yuuundj/Haetburi-practice/archive/code_before_variants/README.md

# 횃불이 이족보행 로봇 — URDF / MuJoCo 모델

횃불이 캐릭터 STL을 관절 단위로 잘라, **Dynamixel XL430-W250-T 7개**로 움직이는
이족 로봇 모델로 만든 것입니다. 현재 버전은 **모터 7개가 전부 캐릭터 껍데기 안에**
들어갑니다. 발목 모터는 발에 하나(피치), 다리에 하나(롤)를 나눠 넣었습니다.

preview

```
python3 sim/view.py            # 인터랙티브 뷰어 (Tab → Control 탭에서 관절 슬라이더)
python3 sim/demo.py            # 전 관절 가동 범위 시연
python3 sim/analyse.py         # 모터 간섭·토크·전도 한계·한 발 지지 리포트
python3 tools/build_model.py   # 파라미터를 고친 뒤 모델 재생성
python3 tools/ankle_search.py  # 발목 모터 배치 전수 탐색
```

필요한 것은 `mujoco`, `trimesh`, `shapely`, `manifold3d`, `mapbox_earcut`, `rtree`,
`numpy`, `pillow`입니다. WSL에서는 렌더링에 `MUJOCO_GL=glfw`가 필요합니다.

## 1. 관절 구성

| 관절 | 축 | 범위 | 모터 위치 | 부모 → 자식 |
|---|---|---|---|---|
| `waist_yaw` | z | ±60° | 가슴 속 | pelvis → torso |
| `hip_pitch_l/r` | y | ±45° | 배(골반) 속 | pelvis → leg |
| `ankle_roll_l/r` | x | ±12° | 다리 속 | leg → ankle |
| `ankle_pitch_l/r` | y | ±15° | 발 속 | ankle → foot |

무릎은 없고 다리는 고관절 한 축입니다. `ankle` 링크는 롤 모터 출력과 피치 모터 출력을
잇는 브래킷이고 모터가 없습니다. 머리·팔·꼬리·가방은 상체 강체 하나입니다.

## 2. 크기

| 항목 | 값 |
|---|---|
| 캐릭터 본체 (머리 끝 ~ 원래 발바닥) | 500 mm |
| 실제 전고 | 614 mm |
| 발 (길이 × 폭 × 높이) | 108 × 45 × 82 mm, 위에서 보면 타원(지수 2.5), 옆은 돔(지수 4) |
| 발이 다리보다 나온 길이 | 앞 68 mm, 뒤 41 mm |
| 다리 단면 (폭 × 앞뒤) | 37 × 46 mm, 모서리 지수 6 |
| 다리 길이 (가랑이 ~ 다리 밑) | 57 mm (원본 비율이면 약 19 mm) |
| 발목 틈 (발등 ~ 다리 밑) | 10 mm |
| 발목 피치 축 / 롤 축 높이 | 17 / 106 mm |
| 총 질량 / 무게중심 높이 | 2.82 kg / 244 mm |

## 3. 모양과 모터 배치를 정한 과정

500 mm 스케일에서 골반은 49 mm 높이라 고관절 모터(46.5 mm)로 꽉 차고, 가랑이 아래는
원래 35 mm뿐입니다. XL430은 28.5 × 46.5 × 34 mm이고, 출력축은 34 mm 방향으로 지나며
46.5 mm 변의 한쪽 끝에서 11.25 mm 지점에 있습니다(ROBOTIS 도면).

1. **발목 모터 2개를 모두 발에 넣는 안**은 전수 탐색 결과 가장 작은 발도
   89 × 43 × 142 mm였습니다(`tools/ankle_search.py`). 발 폭이 두 다리 간격 때문에
   약 44 mm로 묶여 있어 두 모터를 세로로 쌓아야 하기 때문입니다.
2. 그래서 **발목 모터를 나눠** 넣었습니다. 다리에는 좌우 폭이 28.5 mm인 롤 모터를
   세워 넣고, 발에는 피치 모터를 긴 쪽이 발끝을 향하게 눕혀 넣습니다.
3. **다리**는 모서리 지수 6의 둥근 사각 기둥(37 × 46 mm)입니다. 원본처럼 둥근 단면은
   직사각형 모터를 품으려면 46 mm 폭까지 굵어져야 해서 두 다리가 거의 붙습니다.
4. **몸통 아랫부분**은 배 둘레와 두 다리 윗면을 볼록 껍질로 이은 반바지 모양입니다.
   원래의 둥근 다리 윗부분을 지우고 다시 만들었기 때문에, 사각 다리가 턱 없이 몸통으로
   이어집니다. 그 높이에 붙어 있던 꼬리 뿌리는 따로 잘라 다시 붙였습니다.
5. **배터리·U2D2 300 g은 배 앞쪽**, 고관절 모터 앞에 둡니다. 가방에 넣으면 무게중심이
   다리보다 11 mm 뒤에 와서 발을 뒤로 빼야만 섰습니다. 지금은 무게중심이 다리 바로
   위에 있어 발을 앞으로 길게 뺄 수 있습니다.
6. **발**은 위에서 보면 타원, 옆에서 보면 돔인 번입니다. 발바닥은 가장 넓은 둘레에서
   잘랐습니다. 그보다 아래에서 자르면 옆면이 발바닥보다 불룩해서, 발목을 꺾을 때 발이
   흔들의자처럼 굴렀습니다.
7. 다리 속 모터는 고관절 ±45°에서도 고관절 모터에 닿지 않게 고관절 축 20 mm 아래에서
   끝납니다. 이것과 모터 높이가 다리 길이 57 mm를 정합니다. 발목 틈 10 mm는 발목을
   끝까지 꺾어도 다리 밑면이 발에 닿지 않는 최소값입니다.

## 4. 부하 계산

`sim/analyse.py` 결과이고, XL430 스톨 토크 1.4 N·m 대비 비율입니다.

| 상황 | 결과 |
|---|---|
| 모터 7개가 껍데기 안에 든 비율 | 전부 100 % |
| 모터끼리 최소 간격 | 2.2 mm |
| 중립 직립, 발목 피치 / 고관절 | 3 % / 3 % |
| 두 발로 앞뒤 7° 기울이기 | 35 % |
| 앞뒤 전도 | 시뮬레이션 8°, 정적 계산 10.3° (뒤꿈치 쪽) |
| 좌우 | 발목 롤 한계 12°까지 넘어지지 않음 |
| 넘어지기 직전 자세를 한 발로 버티기 | 80 % |
| 전 관절 데모(23.5초, 앞뒤 기울임 5°) | 최대 43 %, 넘어지지 않음 |

**한 발로 서기는 이 버전에서 되지 않습니다.** 고관절 롤이 없어서 두 발이 닿아 있는 동안
몸을 옆으로 옮길 방법이 없습니다. 발목 롤을 꺾으면 두 가지 결과가 가능합니다. 하나는
몸 전체가 한쪽 발로 기울며 반대 발이 뜨는 것이고, 다른 하나는 몸은 그대로 있고 두 발이
모서리로 서는 것입니다. 롤 축이 바닥에서 106 mm로 높은 이 버전에서는 뒤쪽이 일어납니다.
딛는 발부터 꺾거나 시간차를 줘도 같았습니다. 롤 축이 낮았던 이전 버전들에서는 발이
떴습니다. 걷게 하려면 고관절 롤을 추가하거나, 롤 모터를 발로 내려 축을 낮추거나,
동적으로 흔드는 보행 제어가 필요합니다.

지금까지 만든 버전을 비교하면 이렇습니다.

| | 모터 노출 | 발목 2개 발에 | 나눠 넣기 (1차) | **나눠 넣기 (현재)** |
|---|---|---|---|---|
| 모터 내장 | 고관절·허리만 | 전부 | 전부 | 전부 |
| 전고 | 500 mm (본체 407) | 608 mm | 584 mm | 614 mm |
| 발 | 110 × 66 판 | 103 × 43 × 120 | 62 × 45 × 49 | 108 × 45 × 82 |
| 발 방향 | - | 가운데 | 뒤로 치우침 | 앞으로 김 |
| 가랑이 아래 다리 | 28 + 모터 93 | 19 | 57 | 57 |
| 앞뒤 전도 | 19° | 9° | 6° | 8° |
| 한 발 지지 | 됨 | 됨 | 됨 | **안 됨** |
| 데모 최대 부하 | 28 % | 50 % | 44 % | 43 % |

## 5. 파일

```
tools/haetburi_params.py   치수·질량·관절 범위·발목 배치 선택 (여기만 고치면 됨)
tools/ankle_search.py      발목 모터 2개를 발에 넣는 배치 탐색, 둥근 발 맞춤(fit_bun)
tools/layout.py            발·다리 단면 크기, 다리 길이, 발목 틈, 모터 위치
tools/segment.py           원본 STL 절단, 둥근 사각 다리, 반바지 모양 몸통 아랫부분
tools/massprops.py         껍데기 적분 기반 질량·관성
tools/build_model.py       URDF 생성, 메시 내보내기, 모터 내장 비율 검사
tools/write_mjcf.py        MuJoCo 씬 생성
tools/render_preview.py    robot/preview.png (투시 화면 포함)
tools/make_feet.py         검토용 도라에몽 발 시안 (modelings/haetburi_feet_v1.stl)

robot/haetburi.urdf        URDF (ROS·PyBullet에서도 로드 가능)
robot/haetburi_scene.xml   MuJoCo 씬
robot/meshes/*.stl         링크별 메시 (미터, 로봇 좌표계)
review/                    발 시안 검토 이미지
```

`robot/` 아래는 전부 생성물입니다. 손으로 고치지 말고 파라미터를 고친 뒤 다시 빌드하세요.

## 6. 좌표계와 단위

- **+x 정면, +y 로봇 왼쪽, +z 위**, 발바닥이 z = 0
- 원본 STL은 −y가 얼굴 방향이라 z축 기준 +90° 회전해 내보냅니다
- 메시·URDF·MJCF는 미터, 파라미터 파일은 mm

## 7. 모델링 상의 단순화

- 모터는 실제 치수와 축 위치를 쓰지만 외형은 박스입니다. 혼 2.5 mm는 간섭 계산에만
  넣었습니다.
- 롤 모터와 피치 모터를 잇는 발목 브래킷은 50 g 박스로만 넣었고 형상은 없습니다.
- 반사 관성 `armature = 0.0067 kg·m²`, 마찰 `0.04 N·m`는 추정값입니다.
- 액추에이터는 `kp 30, kv 1.2, ±1.4 N·m` 위치 서보입니다. 실제 PID·전류 제한은
  반영하지 않았습니다.
- 발 충돌은 발 메시의 볼록 껍질, 나머지는 박스와 구입니다. 다리와 자기 발은 서로
  충돌하지 않게 제외했습니다.
- 배터리·U2D2 300 g은 배 앞쪽의 점 질량으로 넣었습니다.

## 8. 참고

- [ROBOTIS XL430-W250-T e-Manual](https://emanual.robotis.com/docs/en/dxl/x/xl430-w250/)
- [ROBOTIS XM430 데이터시트 도면](https://media.distrelec.com/Web/Downloads/_t/ds/Dynamixel_XM-Series_eng_tds.pdf)
  (XL430과 케이스 치수 동일, 축 위치 11.25 mm의 근거)
- `images-modeling/PartsAssembly.png` (6파트 분할, 몸통 상하 분할)
