yuuundj/Haetburi-practice/images-modeling/Haetburi.png

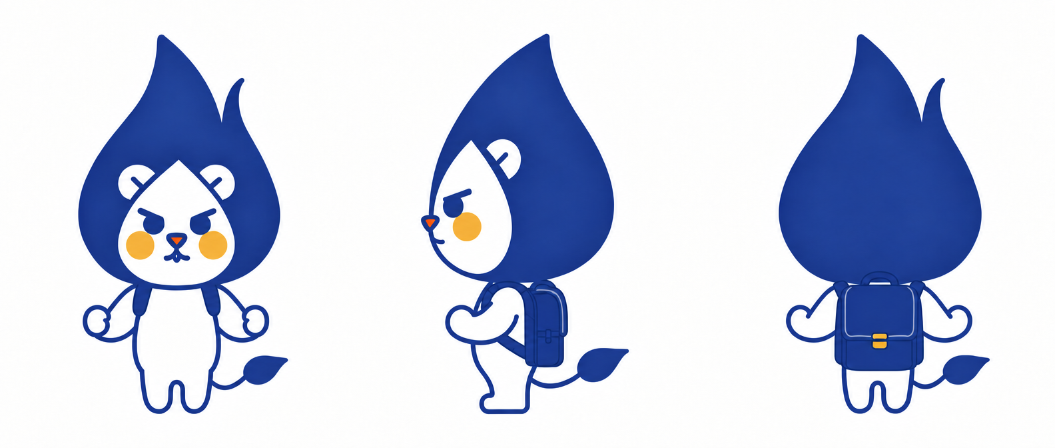
images-modeling/Haetburi.png
