yuuundj/Haetburi-practice/images-modeling/Haetburi_display.png

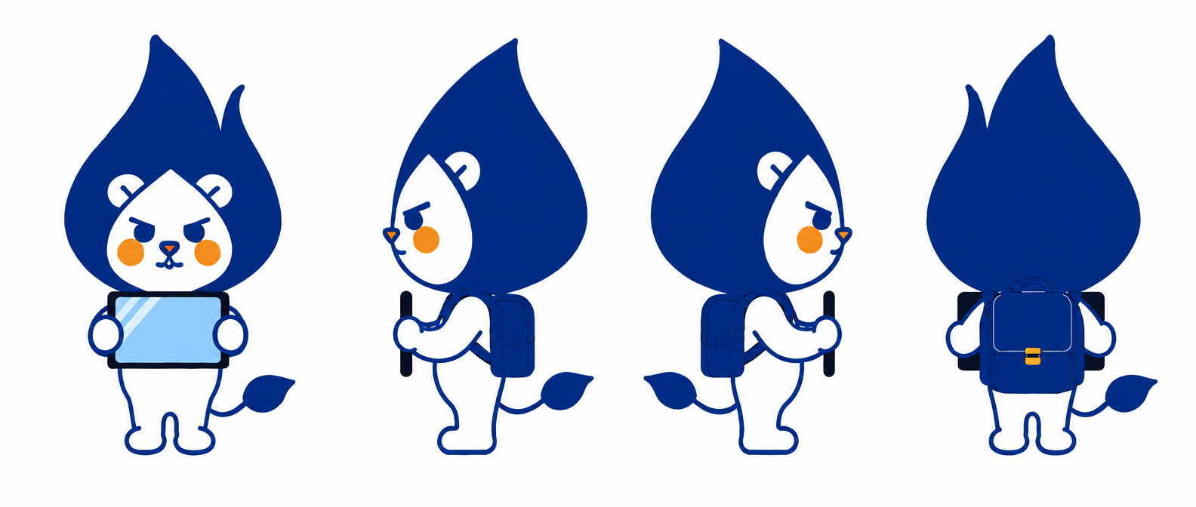
images-modeling/Haetburi_display.png
