yuuundj/Haetburi-practice/review/display_model_v2.png

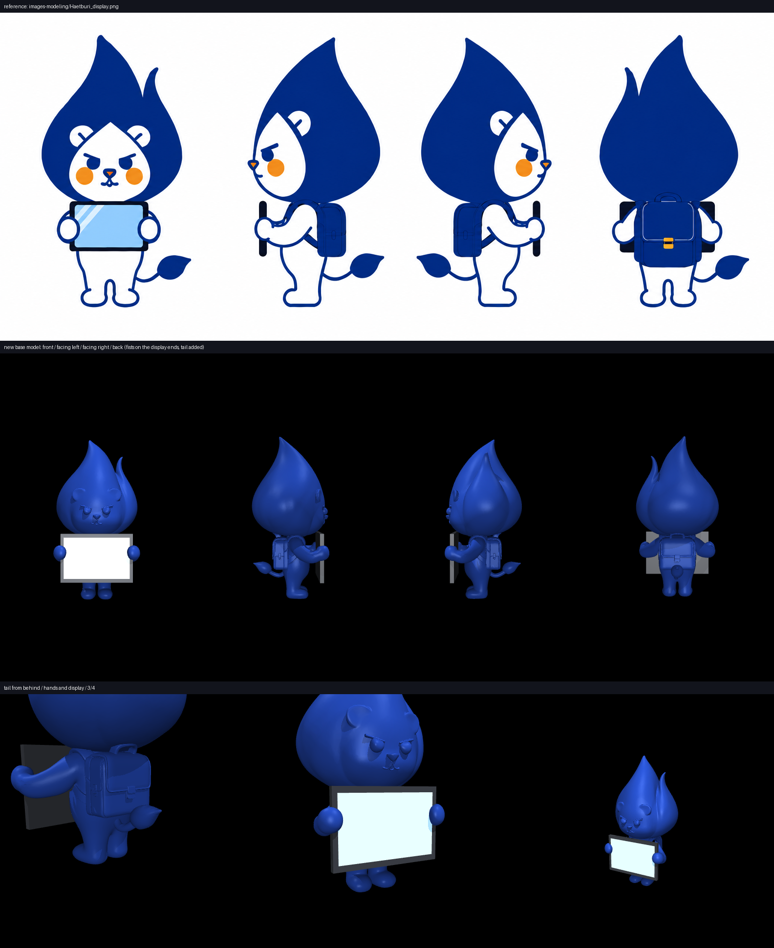
review/display_model_v2.png
