yuuundj/Haetburi-practice/review/feet_v1.png

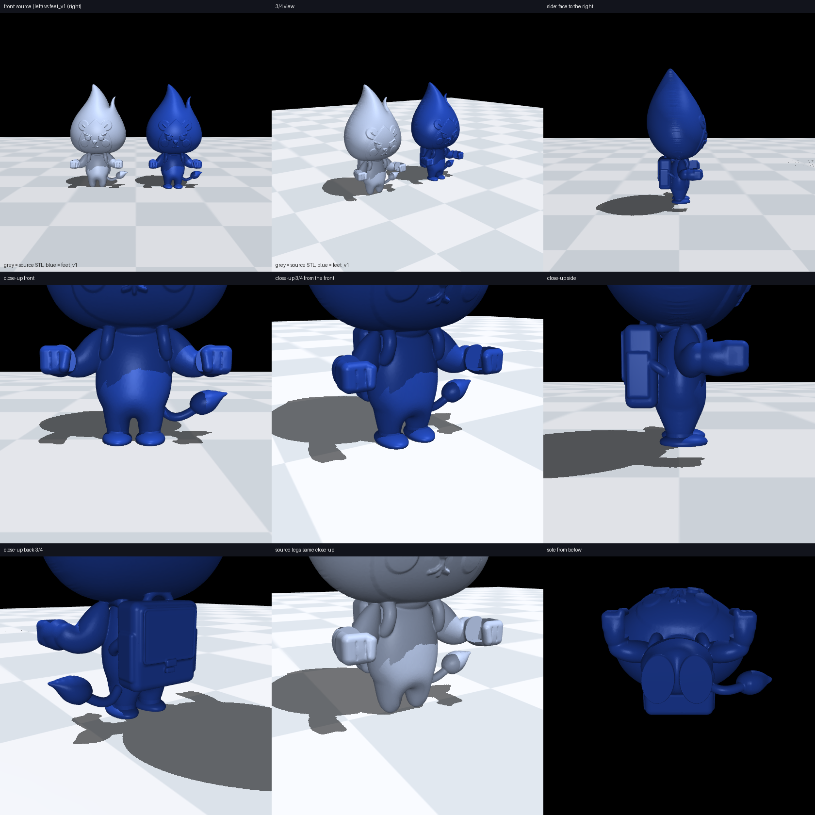
review/feet_v1.png
