yuuundj/Haetburi-practice/review/feet_v1_plan.png

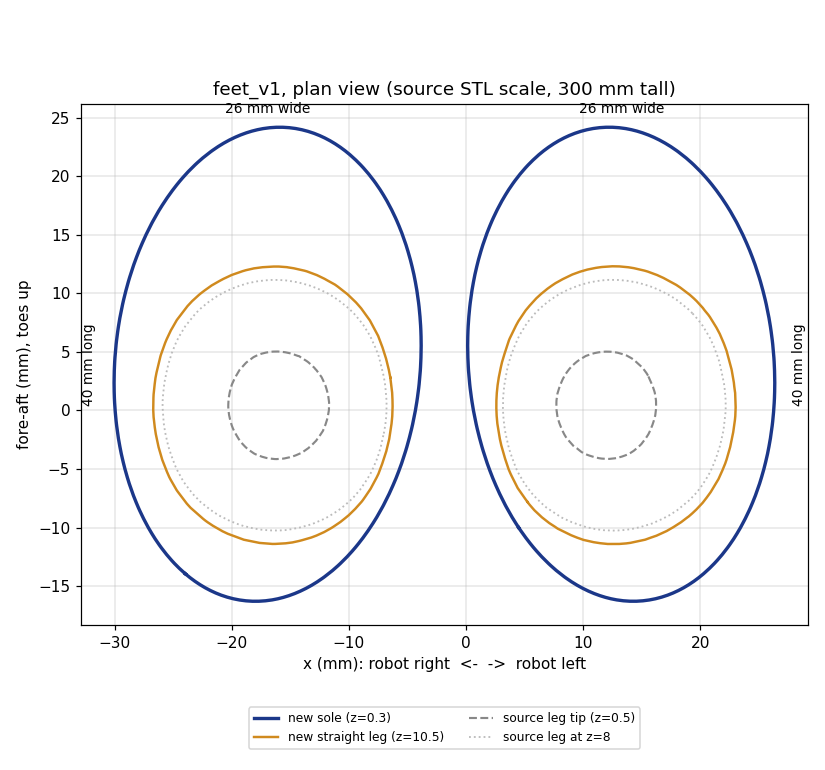
review/feet_v1_plan.png
