yuuundj/Haetburi-practice/robot/v9_yaw_roll_display/reference_compare.png

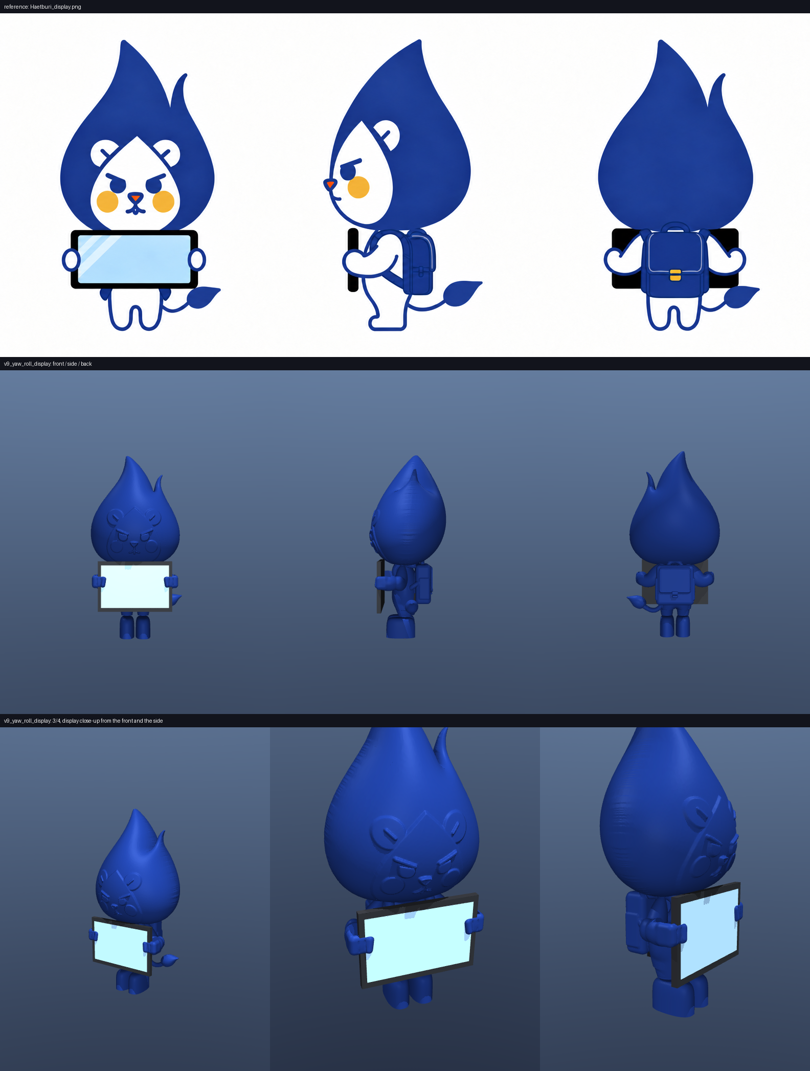
robot/v9_yaw_roll_display/reference_compare.png
