yuuundj/Haetburi-practice/robot/v10_split_display/reference_compare.png

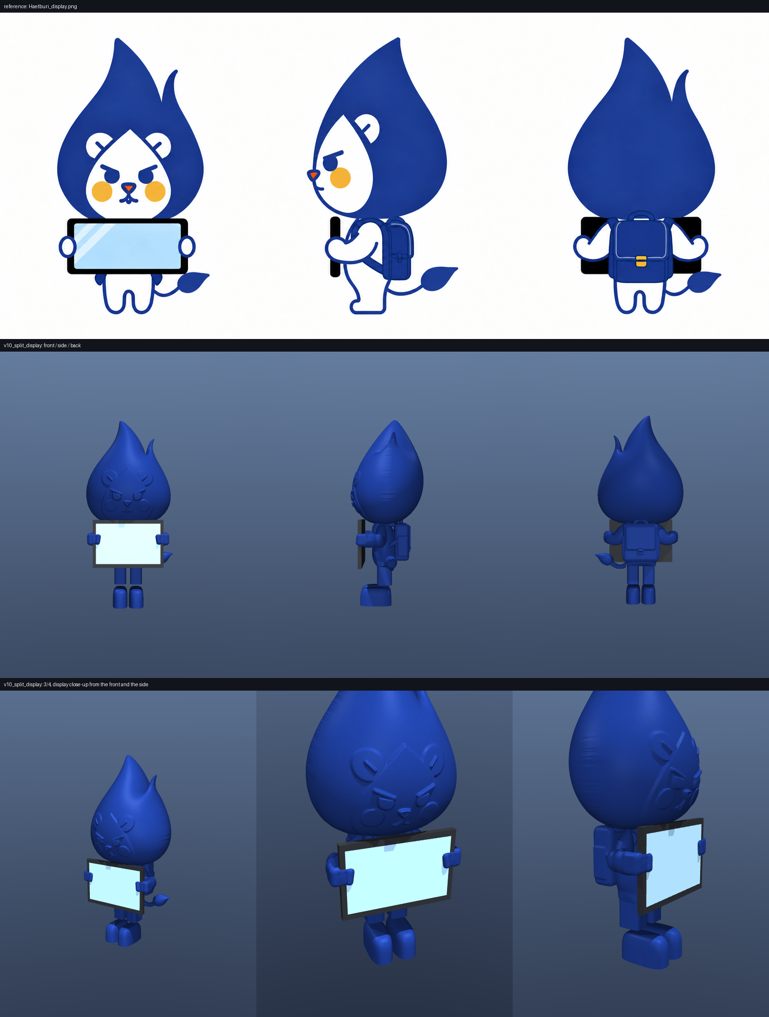
robot/v10_split_display/reference_compare.png
