yuuundj/Haetburi-practice/robot/v11_newbase_display/preview.png

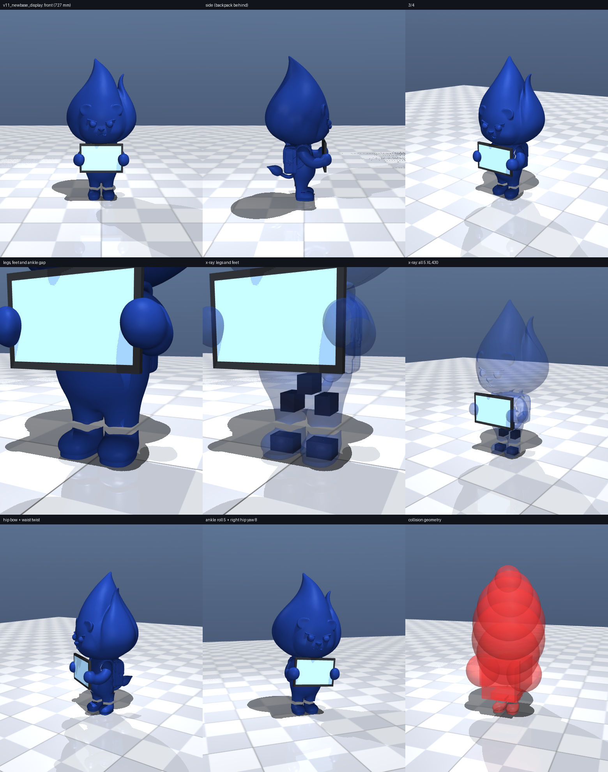
robot/v11_newbase_display/preview.png
