yuuundj/Haetburi-practice/robot/v11_newbase_display/walk_strip.png

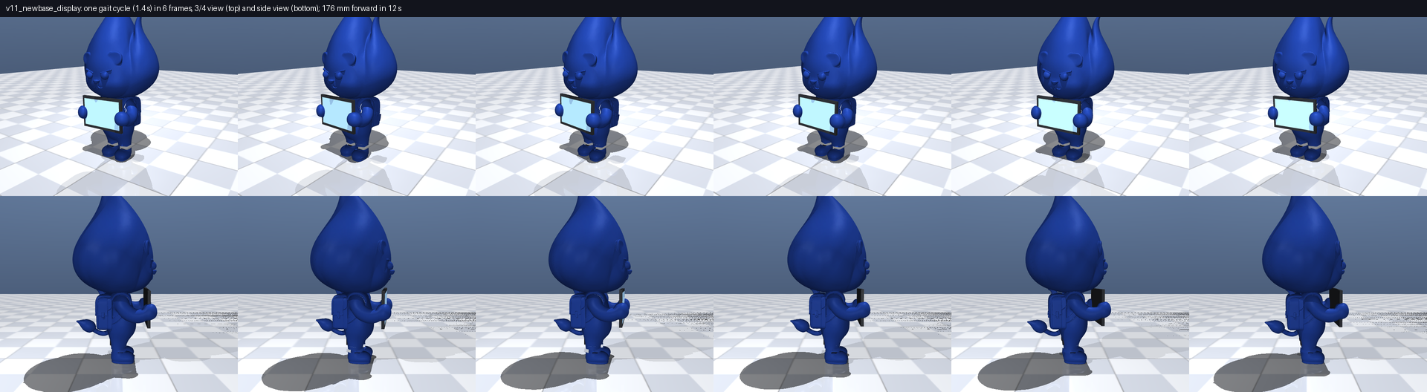
robot/v11_newbase_display/walk_strip.png
