yuuundj/Haetburi-practice/robot/v12_slipper_display/feet_closeup.png

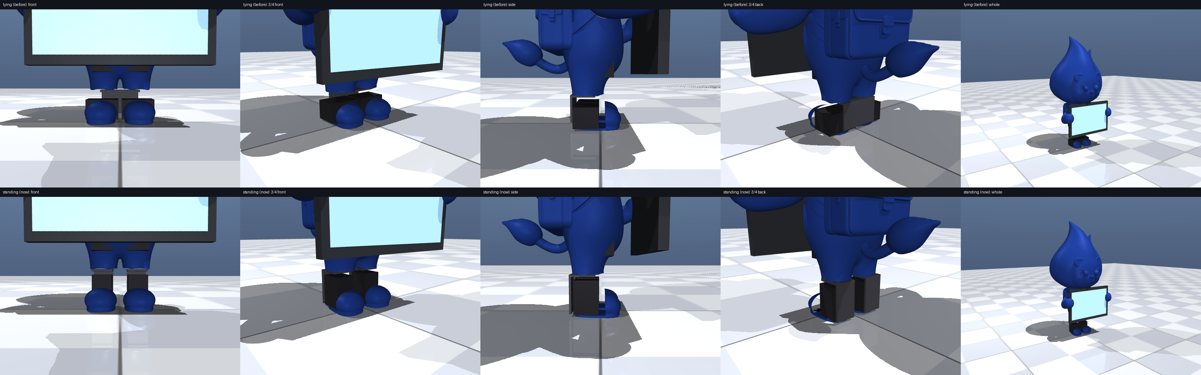
robot/v12_slipper_display/feet_closeup.png
