yuuundj/Haetburi-practice/robot/v12_slipper_display/preview.png

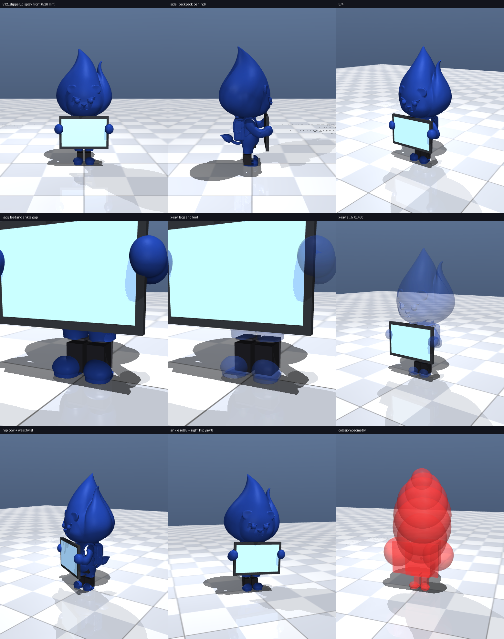
robot/v12_slipper_display/preview.png
