yuuundj/Haetburi-practice/robot/v12_slipper_display/walk_strip.png

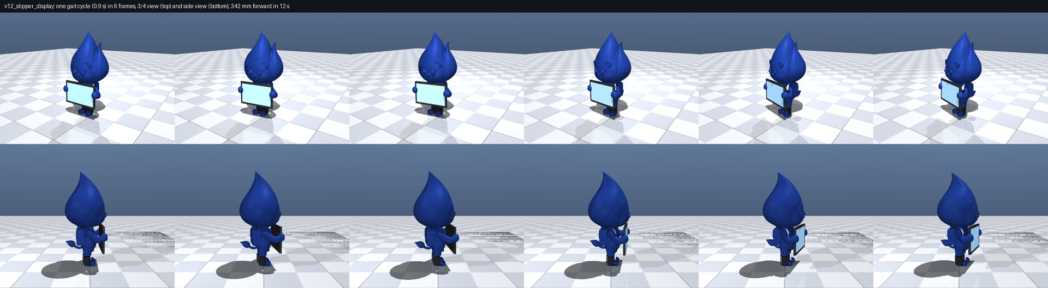
robot/v12_slipper_display/walk_strip.png
