yuuundj/Haetburi-practice/robot/v13_ankle_pitch_display/legs_closeup.png

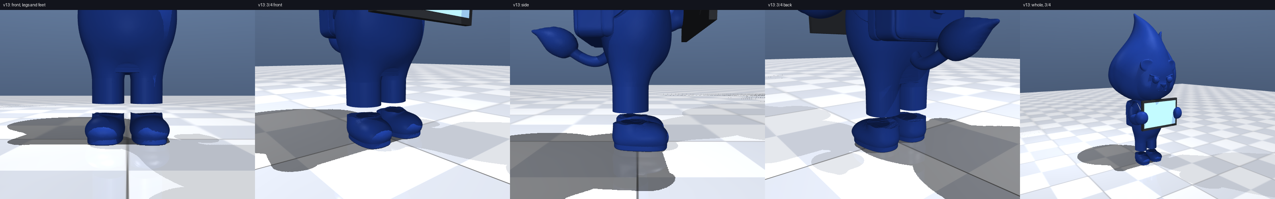
robot/v13_ankle_pitch_display/legs_closeup.png
