yuuundj/Haetburi-practice/robot/v13_ankle_pitch_display/preview.png

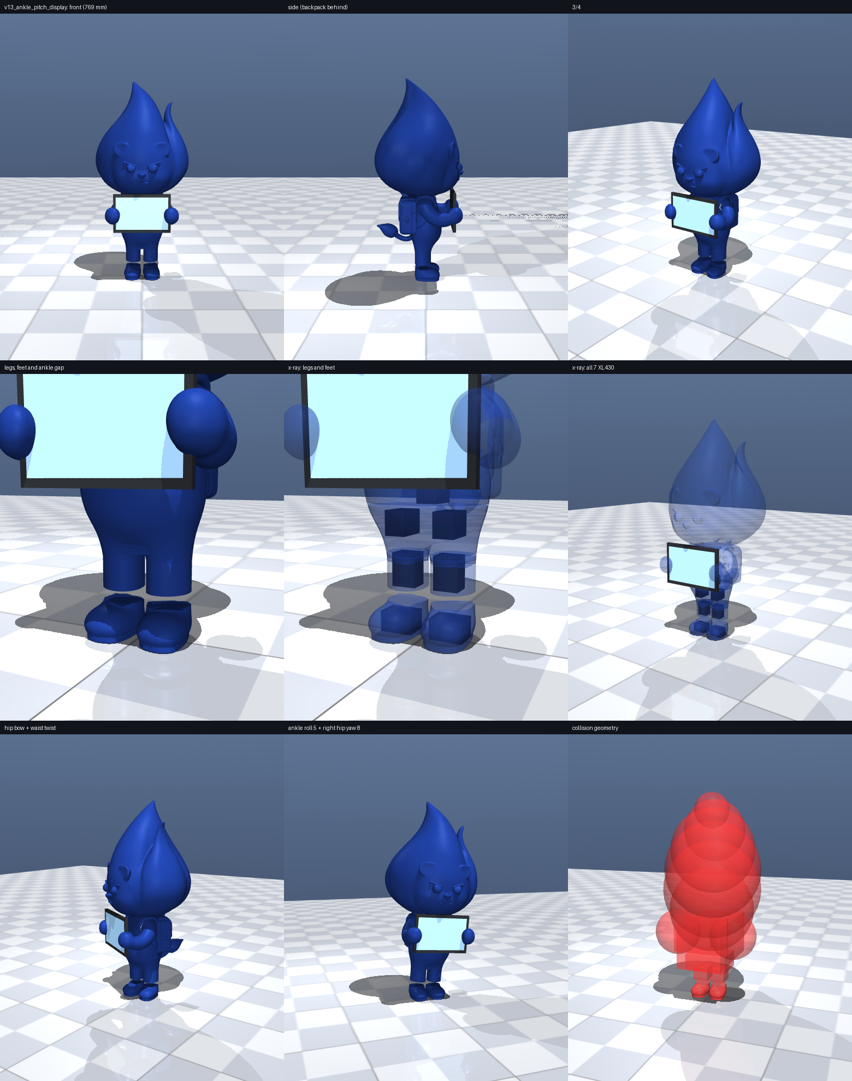
robot/v13_ankle_pitch_display/preview.png
