yuuundj/Haetburi-practice/robot/v14_scs0009_hidden/preview.png

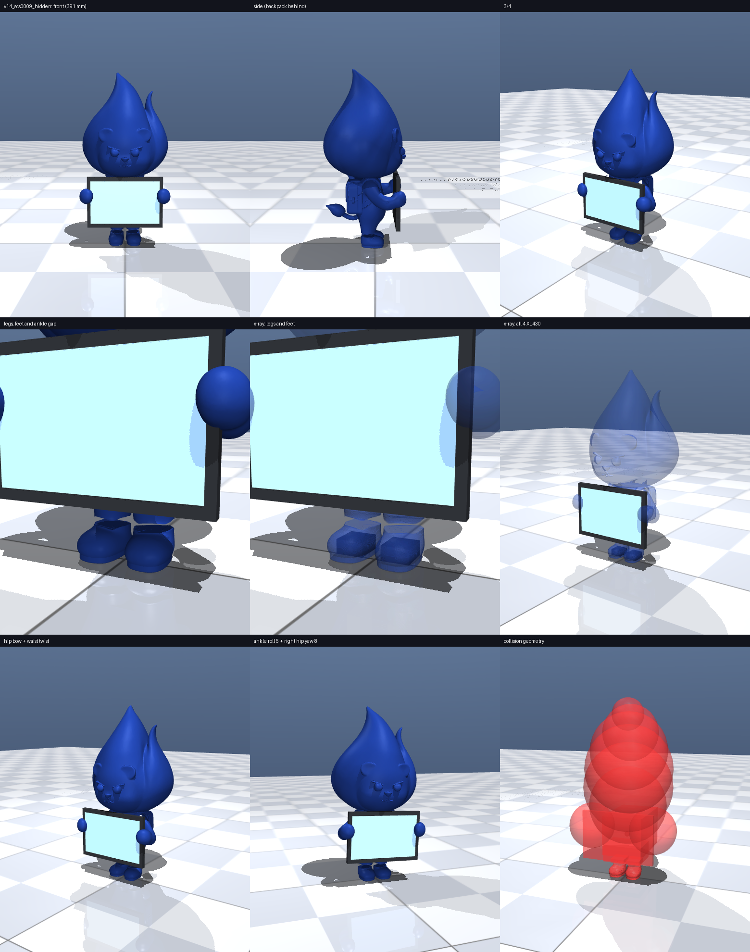
robot/v14_scs0009_hidden/preview.png
