yuuundj/Haetburi-practice/robot/v14_size_compare.png

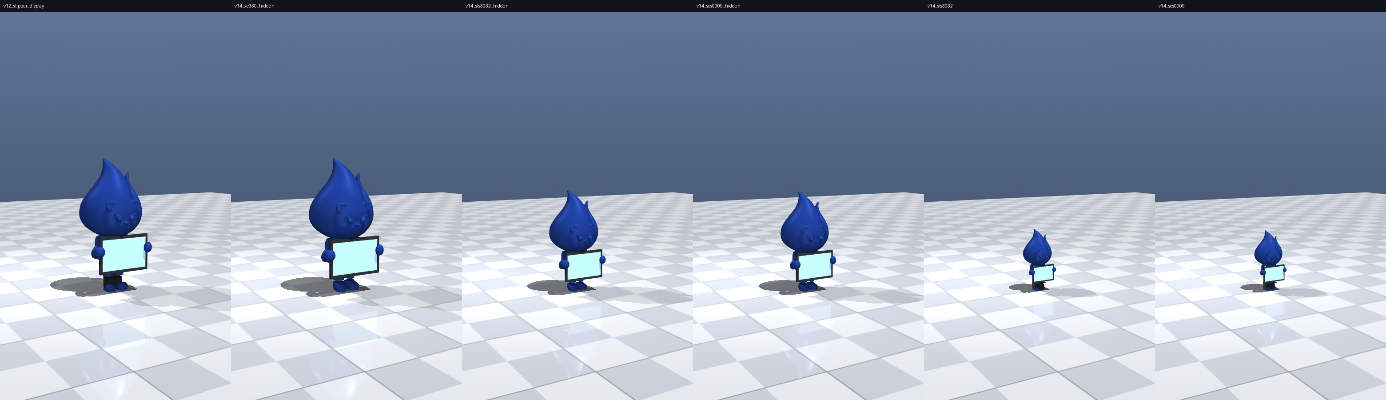
robot/v14_size_compare.png
