yuuundj/Haetburi-practice/robot/v14_sts3032_hidden_7in/layout_xray.png

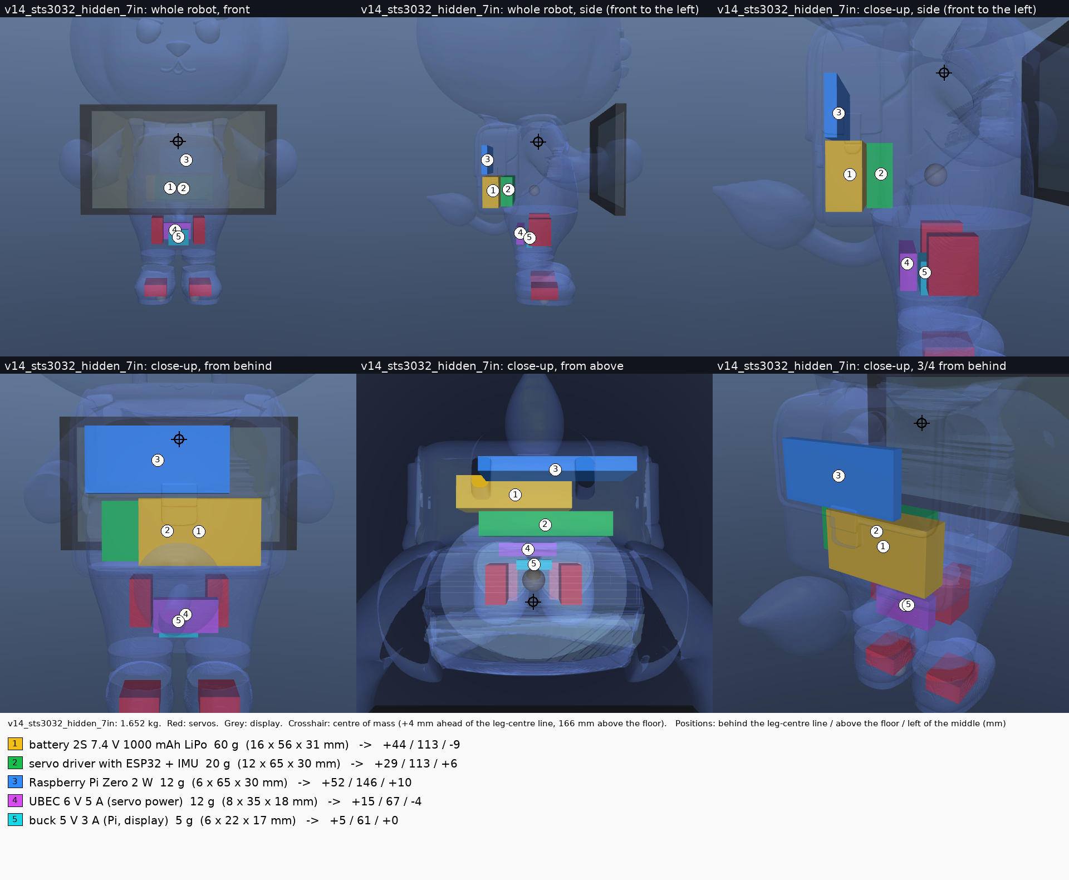
robot/v14_sts3032_hidden_7in/layout_xray.png
