yuuundj/Haetburi-practice/robot/v16_xm430/walk_strip.png

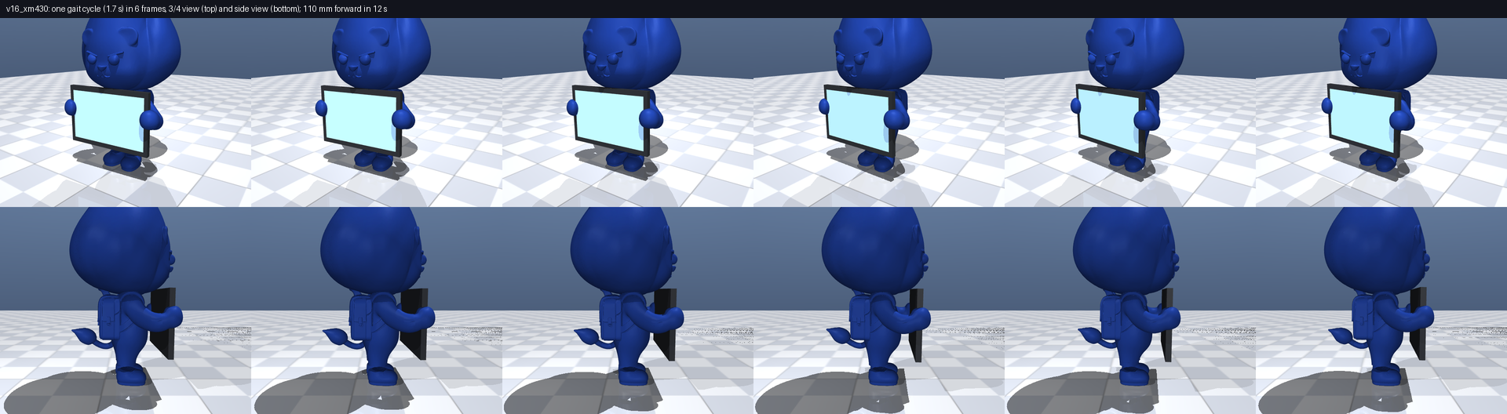
robot/v16_xm430/walk_strip.png
