yuuundj/Haetburi-practice/robot/v17_sts3032_w4/walk_strip.png

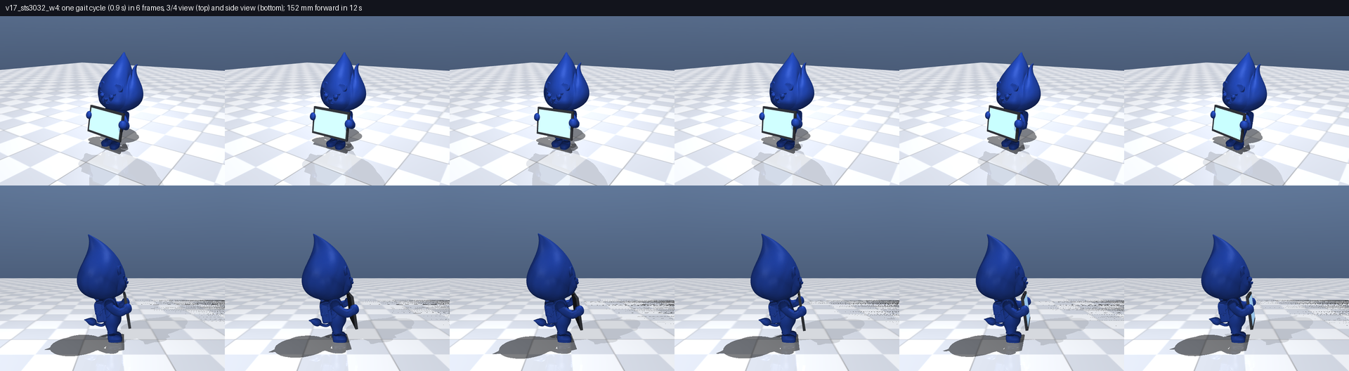
robot/v17_sts3032_w4/walk_strip.png
