yuuundj/Haetburi-practice/robot/v17_v18_v19_compare.png

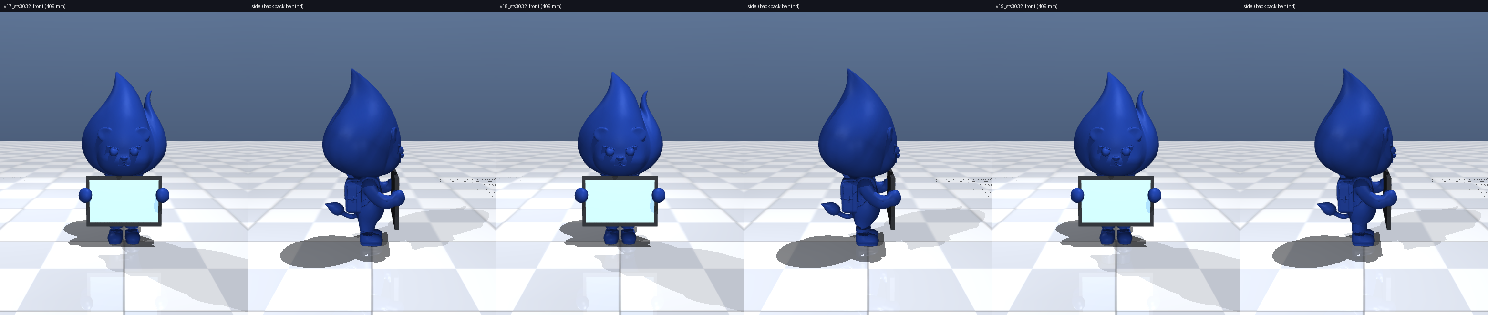
robot/v17_v18_v19_compare.png
