yuuundj/Haetburi-practice/robot/v19_scs0009/hip_seam.png

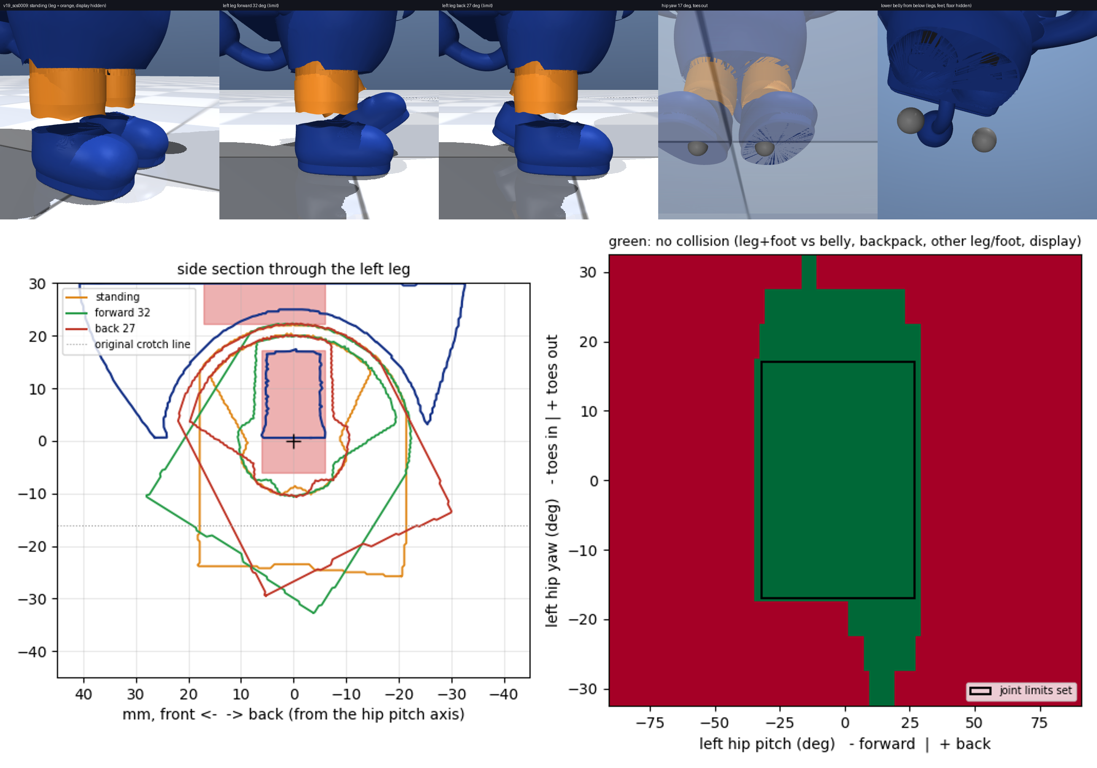
robot/v19_scs0009/hip_seam.png
