yuuundj/Haetburi-practice/robot/v19_scs0009/preview.png

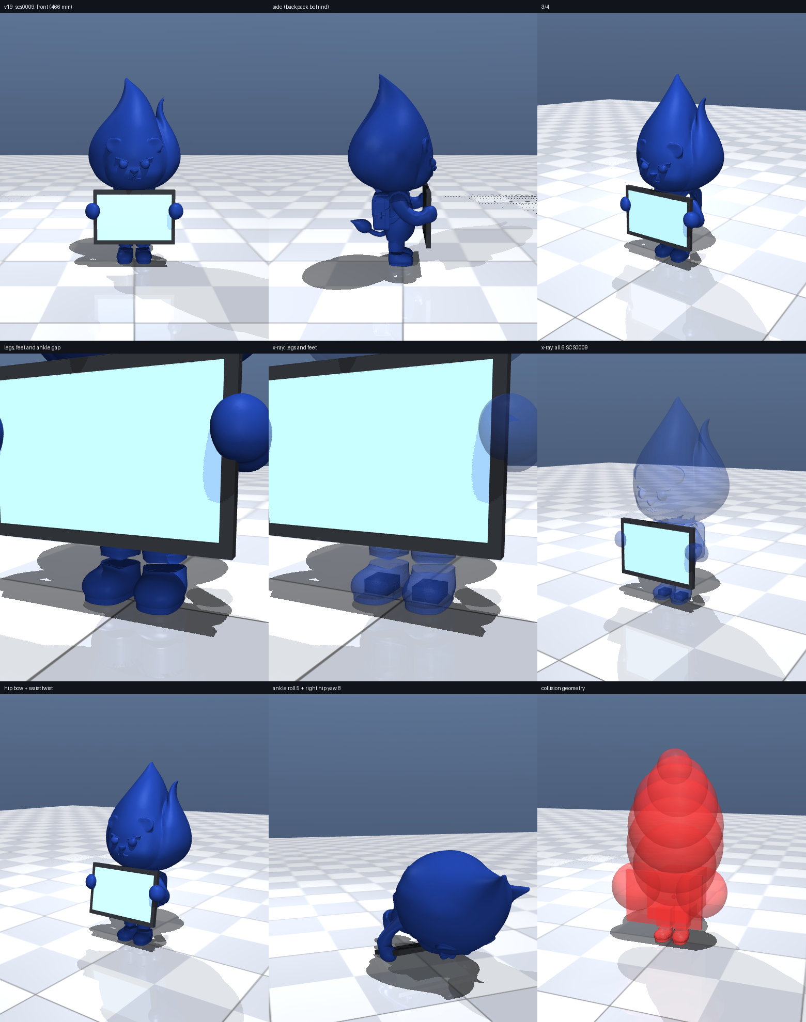
robot/v19_scs0009/preview.png
