yuuundj/Haetburi-practice/robot/v21_lower_body.png

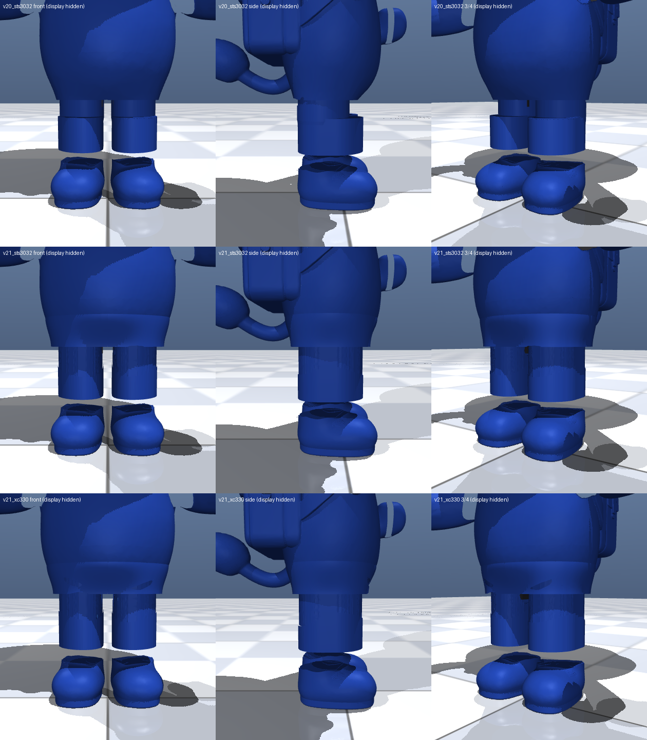
robot/v21_lower_body.png
