yuuundj/Haetburi-practice/robot/v21_xc330/hip_seam.png

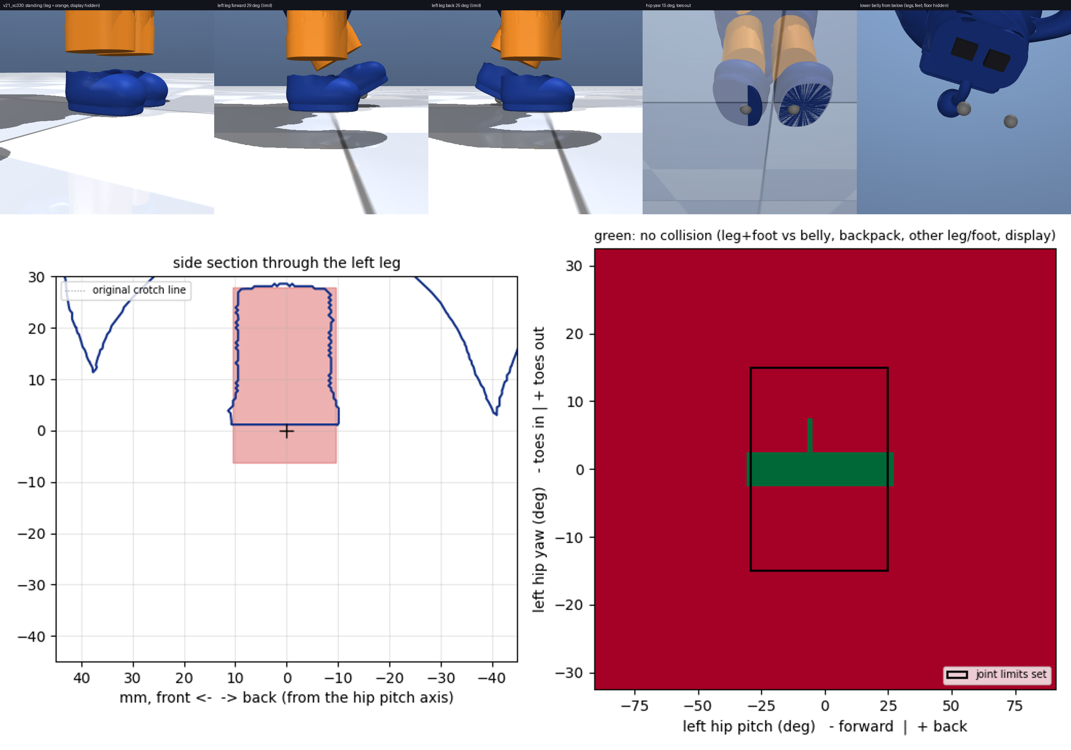
robot/v21_xc330/hip_seam.png
