yuuundj/Haetburi-practice/robot/v22_sts3032/hip_seam.png

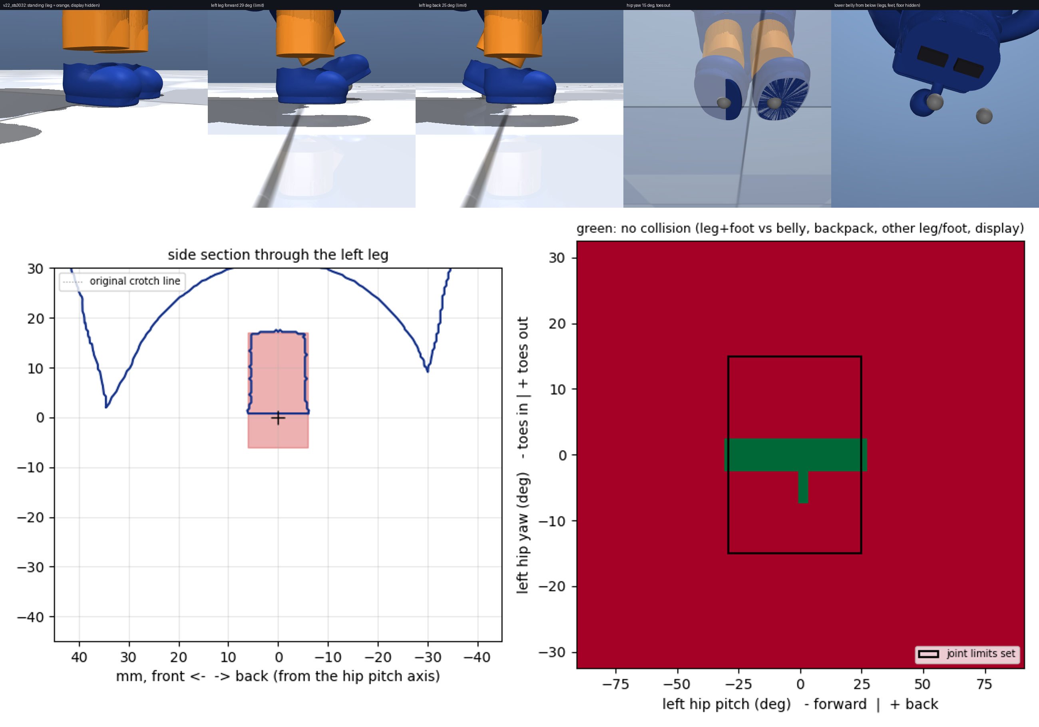
robot/v22_sts3032/hip_seam.png
