yuuundj/Haetburi-practice/robot/v22_sts3032/preview.png

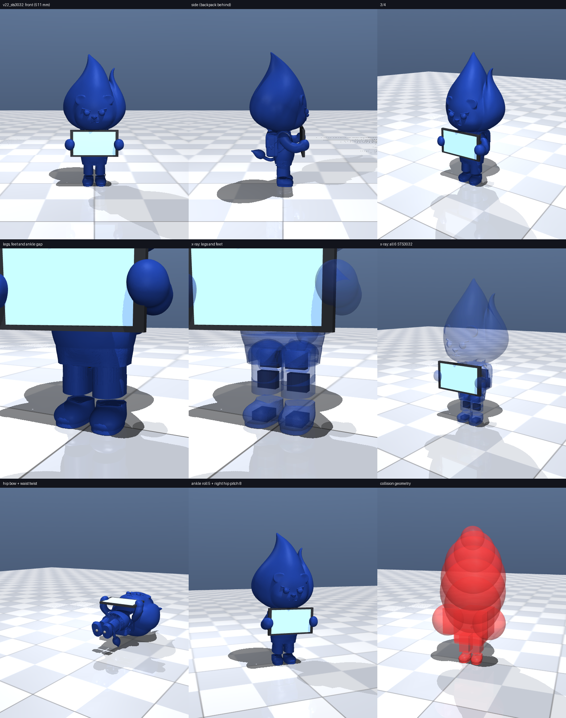
robot/v22_sts3032/preview.png
