yuuundj/Haetburi-practice/robot/v22_sts3032/walk_strip.png

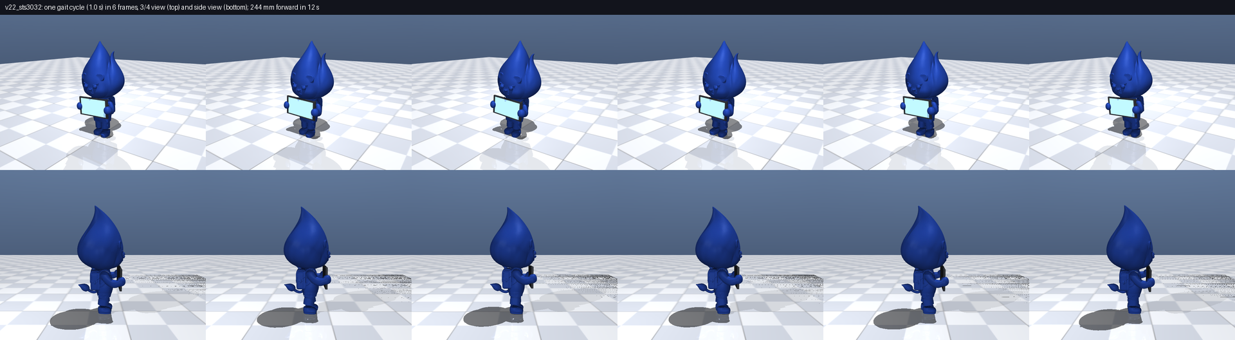
robot/v22_sts3032/walk_strip.png
