yuuundj/Haetburi-practice/images-modeling/PartsAssembly.png

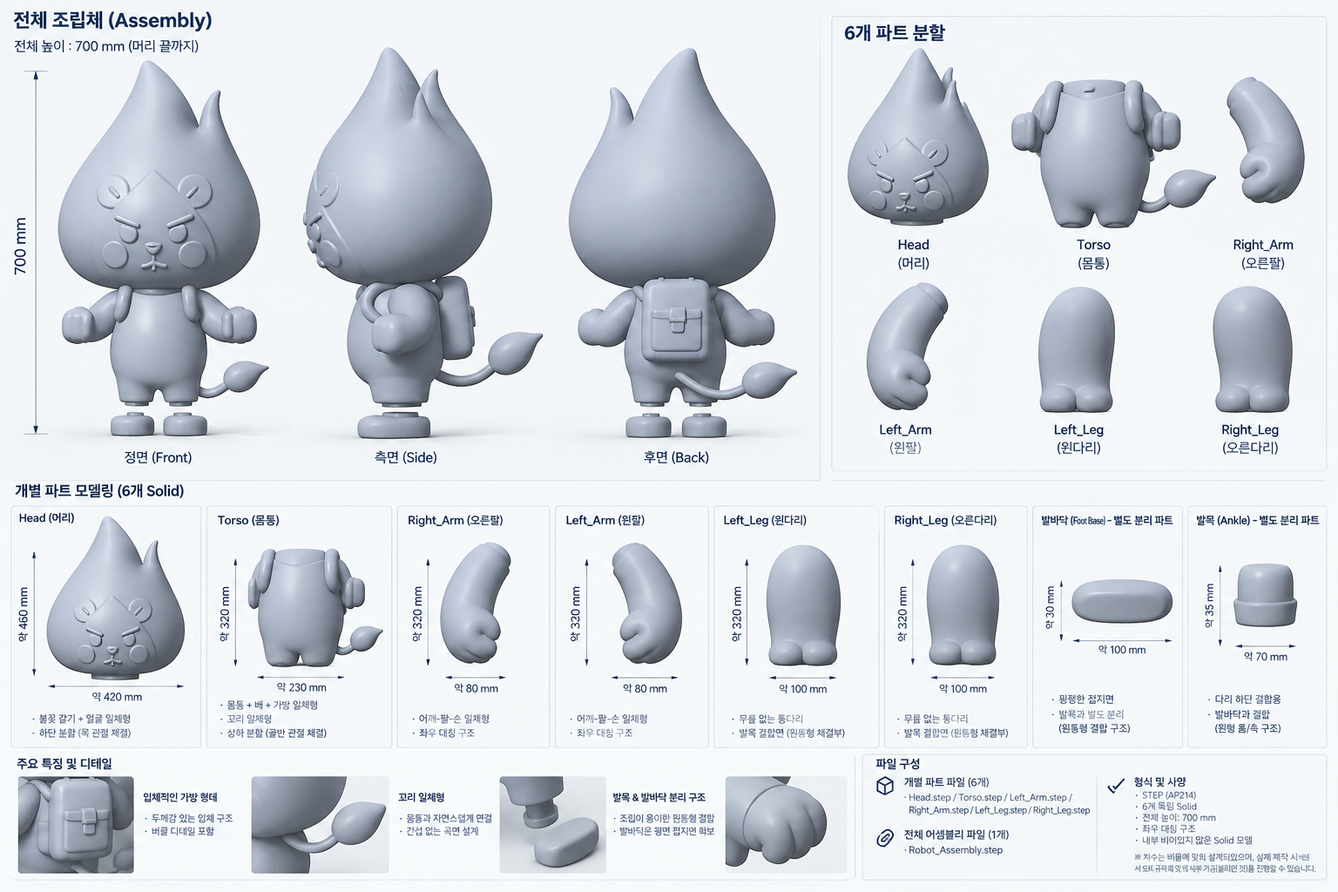
images-modeling/PartsAssembly.png
