yuuundj/Haetburi-practice/images-modeling/PartsAssemblyV2.jpeg

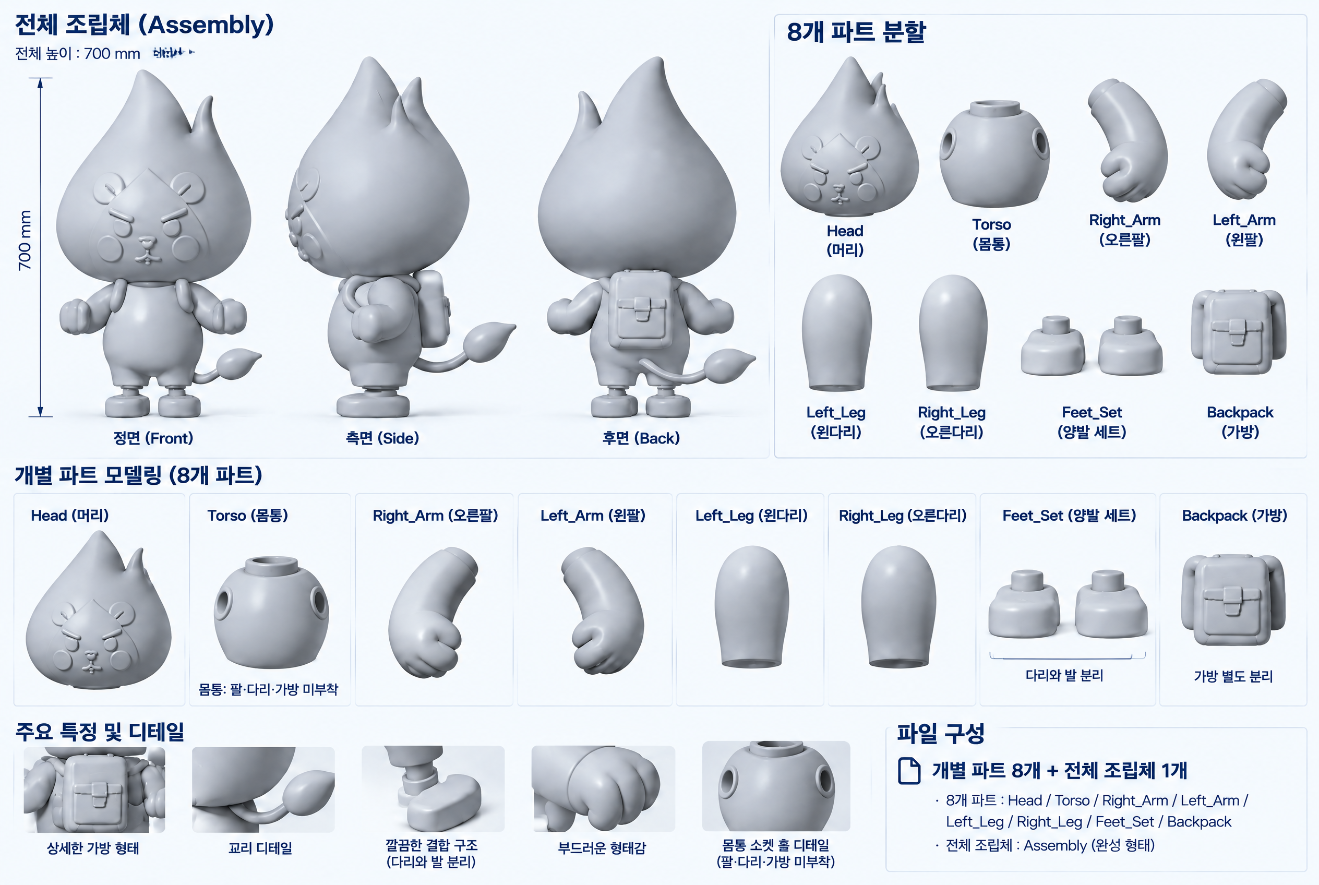
images-modeling/PartsAssemblyV2.jpeg
