yuuundj/Haetburi-practice/images-modeling/PartsSeparation_back.png

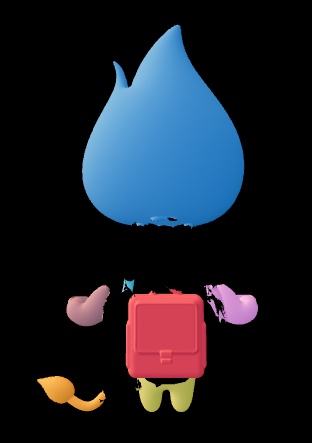
images-modeling/PartsSeparation_back.png
