yuuundj/Haetburi-practice/images-modeling/PartsSeparation_front.png

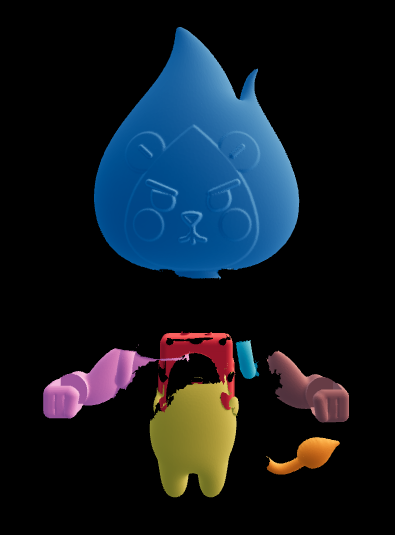
images-modeling/PartsSeparation_front.png
