yuuundj/Haetburi-practice/robot/v11_newbase_display/meshes/leg_r.stl

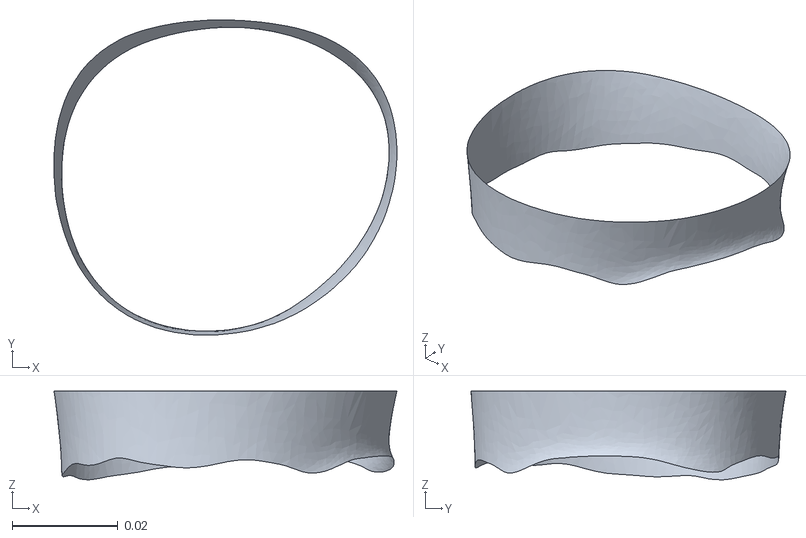
[picture p34: CAD file, 2026-10-13]
robot/v11_newbase_display/meshes/leg_r.stl
0.0648 x 0.0596 x 0.0168
