yuuundj/Haetburi-practice/robot/v12_slipper_display/meshes/foot_r.stl

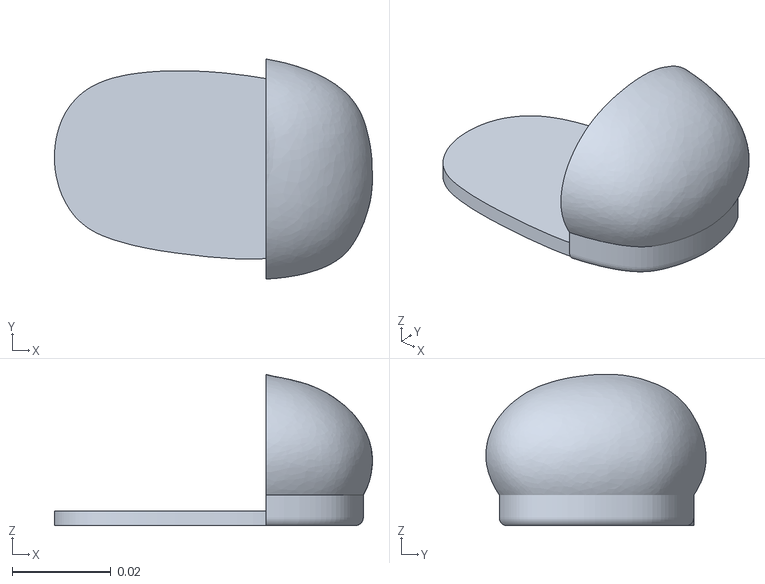
[picture p35: CAD file, 2026-10-13]
robot/v12_slipper_display/meshes/foot_r.stl
0.0646 x 0.0447 x 0.0307
