yuuundj/Haetburi-practice/robot/v13_ankle_pitch_display/meshes/torso.stl

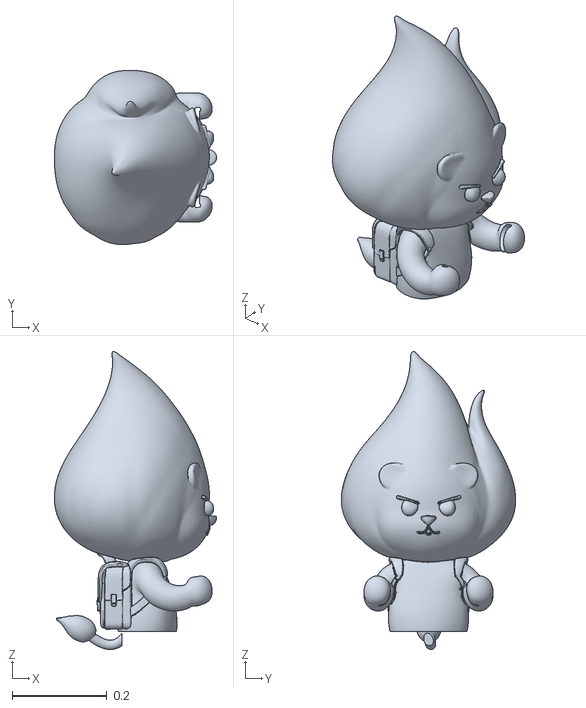
[picture p36: CAD file, 2026-10-13]
robot/v13_ankle_pitch_display/meshes/torso.stl
0.342 x 0.368 x 0.628
