yuuundj/Haetburi-practice/robot/v14_scs0009_hidden/meshes/leg_l.stl

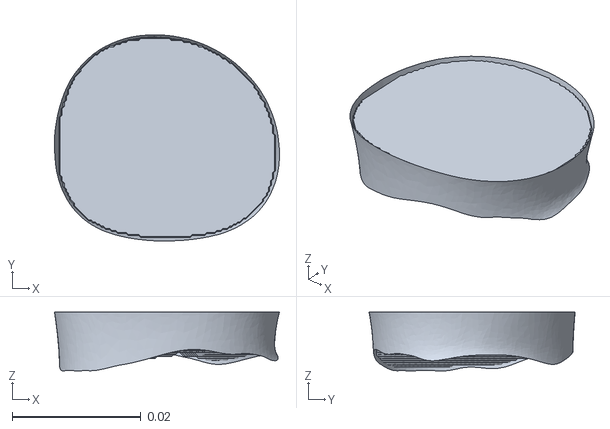
[picture p37: CAD file, 2026-10-13]
robot/v14_scs0009_hidden/meshes/leg_l.stl
0.0349 x 0.032 x 0.00914
