yuuundj/Haetburi-practice/robot/v14_sts3032_hidden/meshes/leg_r.stl

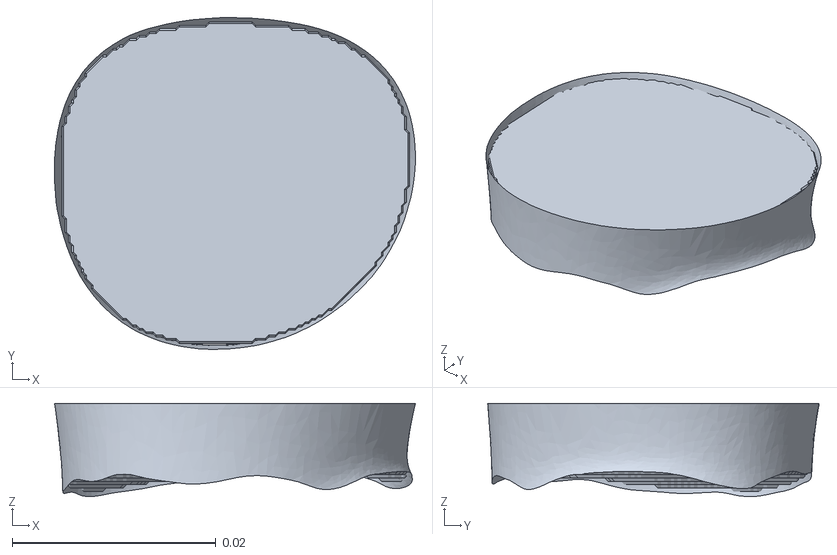
[picture p38: CAD file, 2026-10-13]
robot/v14_sts3032_hidden/meshes/leg_r.stl
0.0354 x 0.0325 x 0.00916
