yuuundj/Haetburi-practice/robot/v14_sts3032_hidden_7in/meshes/leg_r.stl

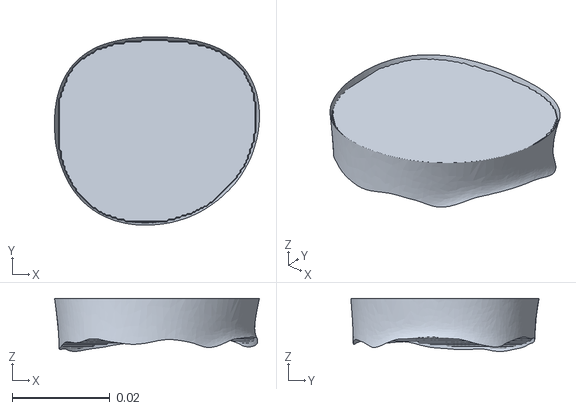
[picture p39: CAD file, 2026-10-13]
robot/v14_sts3032_hidden_7in/meshes/leg_r.stl
0.042 x 0.0385 x 0.0109
