yuuundj/Haetburi-practice/robot/v14_xc330_hidden/meshes/foot_r.stl

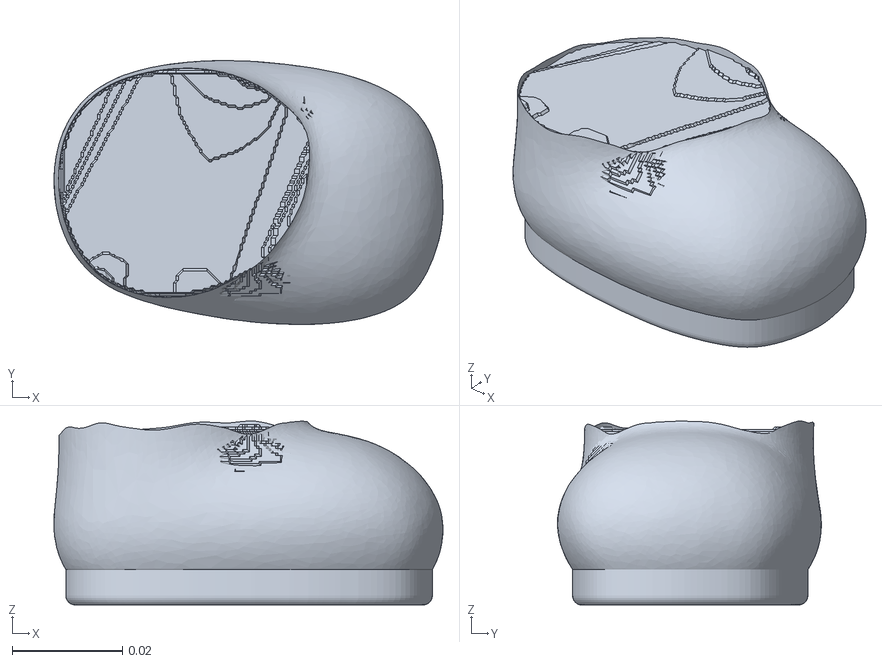
[picture p40: CAD file, 2026-10-13]
robot/v14_xc330_hidden/meshes/foot_r.stl
0.0705 x 0.0478 x 0.0333
