yuuundj/Haetburi-practice/robot/v16_xm430/meshes/foot_r.stl

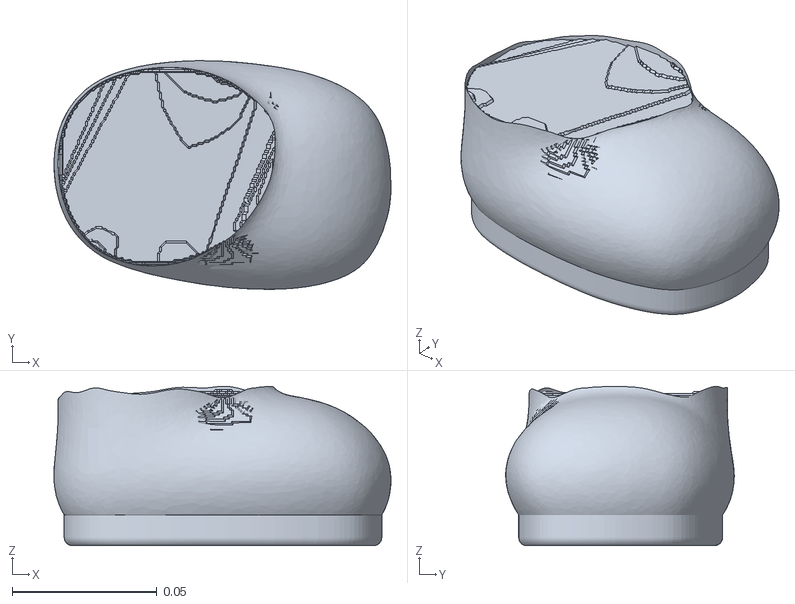
[picture p41: CAD file, 2026-10-13]
robot/v16_xm430/meshes/foot_r.stl
0.116 x 0.0789 x 0.055
