yuuundj/Haetburi-practice/robot/v17_sts3032_w4/meshes/leg_l.stl

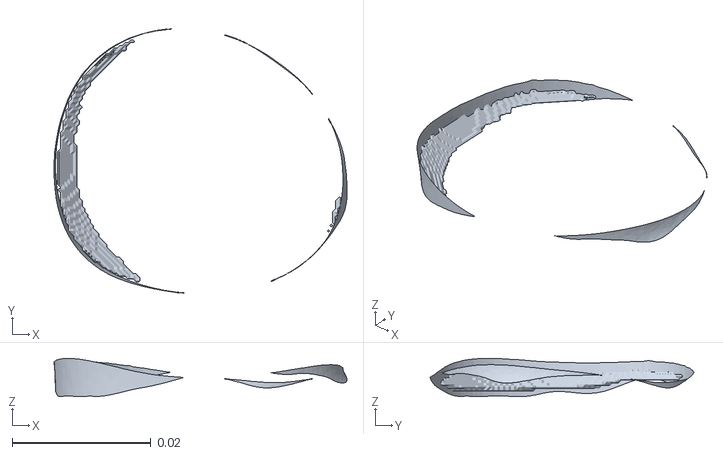
[picture p42: CAD file, 2026-10-13]
robot/v17_sts3032_w4/meshes/leg_l.stl
0.0423 x 0.0381 x 0.00552
