yuuundj/Haetburi-practice/robot/v19_scs0009/meshes/foot_l.stl

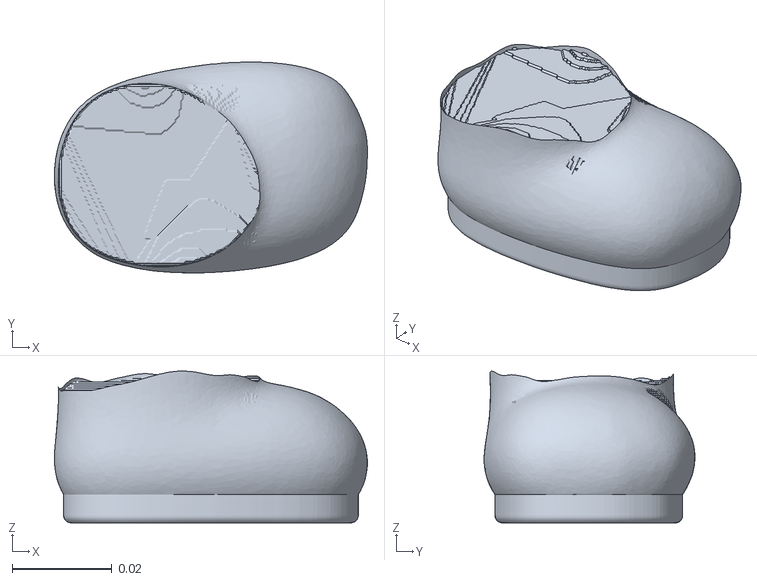
[picture p43: CAD file, 2026-10-13]
robot/v19_scs0009/meshes/foot_l.stl
0.0628 x 0.0423 x 0.0305
