yuuundj/Haetburi-practice/robot/v19_xl330/meshes/torso.stl

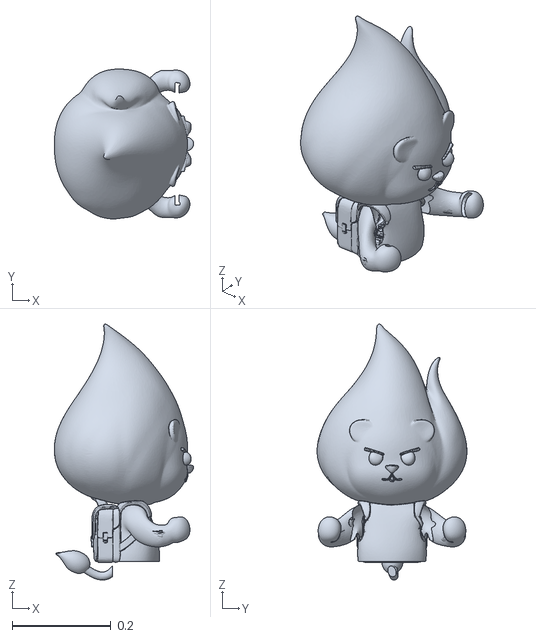
[picture p44: CAD file, 2026-10-13]
robot/v19_xl330/meshes/torso.stl
0.282 x 0.303 x 0.517
