yuuundj/Haetburi-practice/robot/v21_sts3032_lite/body_native.stl

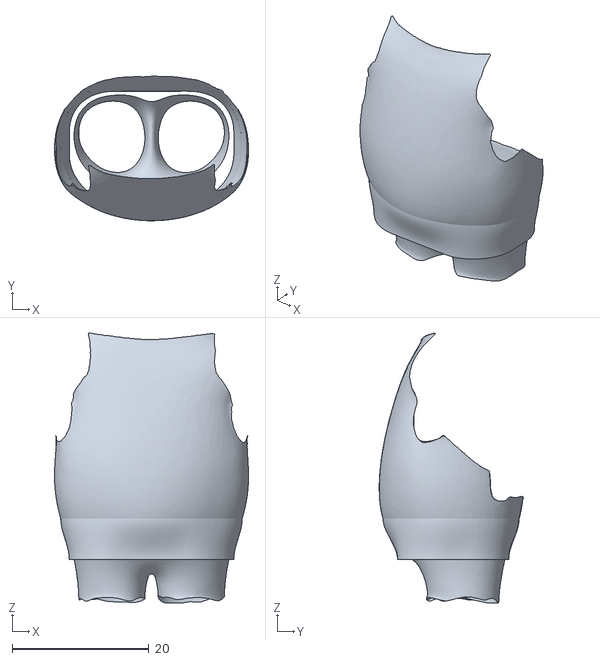
[picture p45: CAD file, 2026-10-13]
robot/v21_sts3032_lite/body_native.stl
28.3 x 21.1 x 39.4
