yuuundj/Haetburi-practice/robot/v21_xc330/meshes/torso.stl

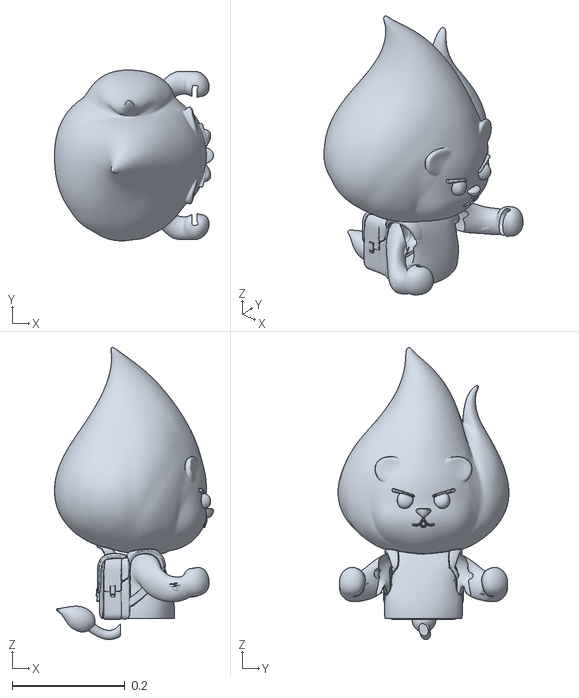
[picture p47: CAD file, 2026-10-13]
robot/v21_xc330/meshes/torso.stl
0.282 x 0.303 x 0.517
