yuuundj/Haetburi-practice/robot/v22_sts3032/meshes/foot_r.stl

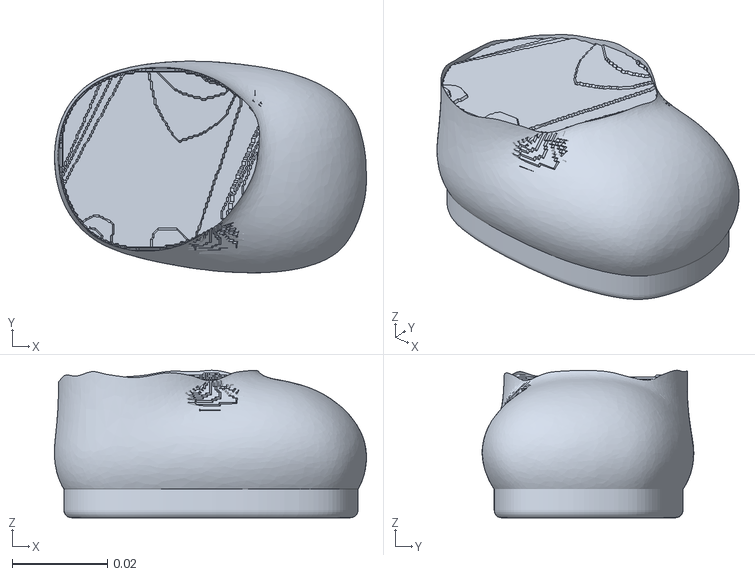
[picture p48: CAD file, 2026-10-13]
robot/v22_sts3032/meshes/foot_r.stl
0.0655 x 0.0445 x 0.031
