yuuundj/Haetburi-practice/modelings/haetburi_display_tail.stl

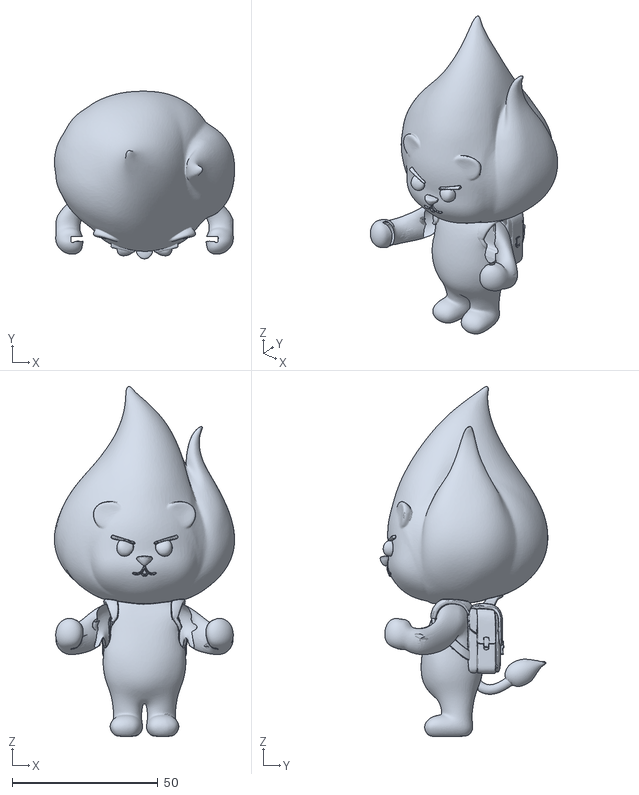
[picture p49: CAD file, 2026-10-13]
modelings/haetburi_display_tail.stl
61.8 x 57.5 x 120.0
