yuuundj/Haetburi-practice/robot/v11_newbase_display/meshes/torso.stl

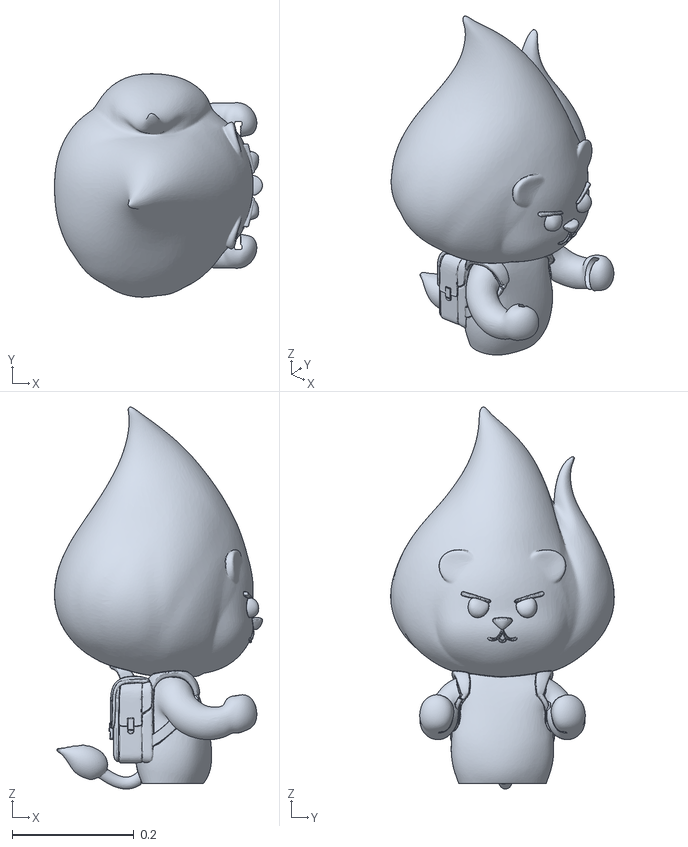
[picture p50: CAD file, 2026-10-13]
robot/v11_newbase_display/meshes/torso.stl
0.342 x 0.368 x 0.628
