yuuundj/Haetburi-practice/robot/v12_slipper_display/meshes/leg_l.stl

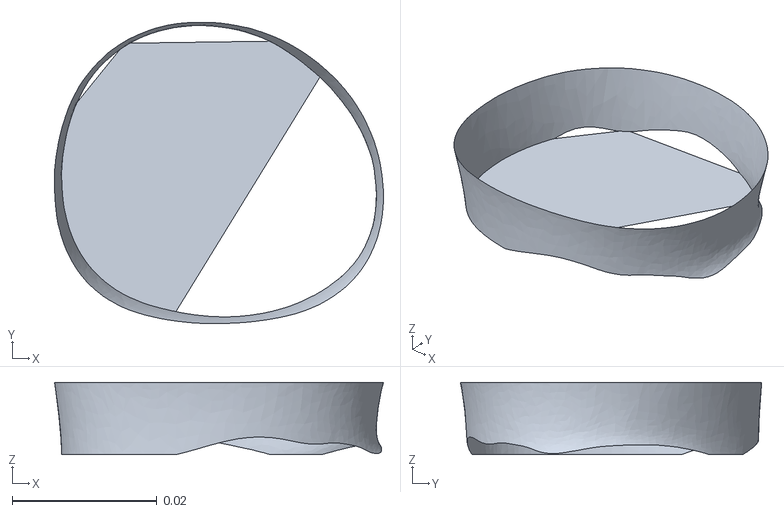
[picture p51: CAD file, 2026-10-13]
robot/v12_slipper_display/meshes/leg_l.stl
0.0454 x 0.0416 x 0.01
