yuuundj/Haetburi-practice/robot/v13_ankle_pitch_display/meshes/pelvis.stl

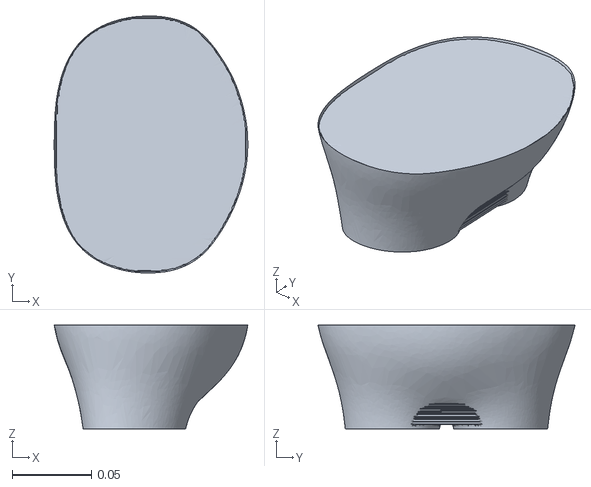
[picture p52: CAD file, 2026-10-13]
robot/v13_ankle_pitch_display/meshes/pelvis.stl
0.122 x 0.162 x 0.0654
