yuuundj/Haetburi-practice/robot/v14_scs0009_hidden/meshes/foot_l.stl

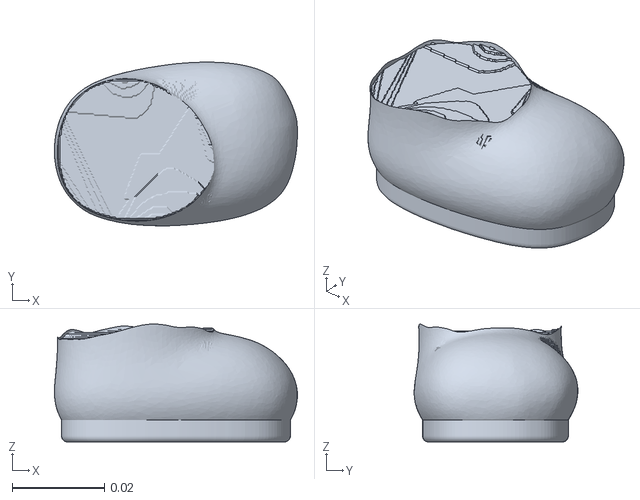
[picture p53: CAD file, 2026-10-13]
robot/v14_scs0009_hidden/meshes/foot_l.stl
0.0527 x 0.0355 x 0.0255
