yuuundj/Haetburi-practice/robot/v14_sts3032_hidden/meshes/foot_l.stl

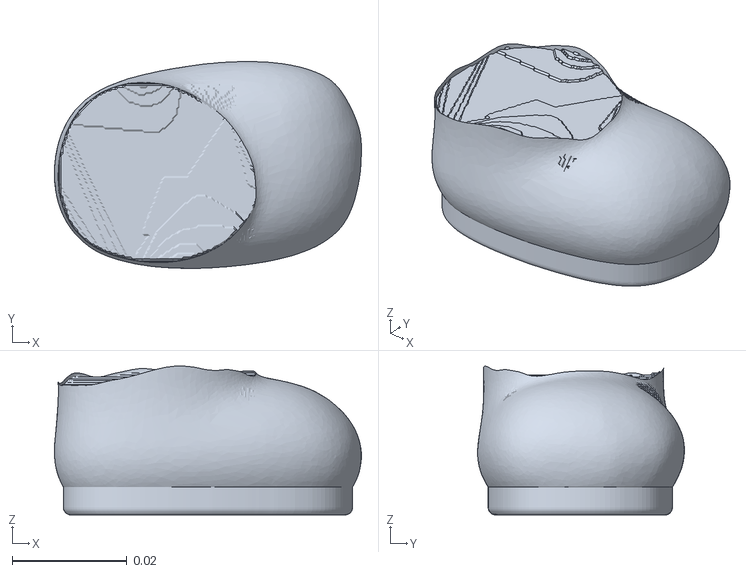
[picture p54: CAD file, 2026-10-13]
robot/v14_sts3032_hidden/meshes/foot_l.stl
0.0535 x 0.036 x 0.0259
