yuuundj/Haetburi-practice/robot/v14_sts3032_hidden_w4/meshes/foot_l.stl

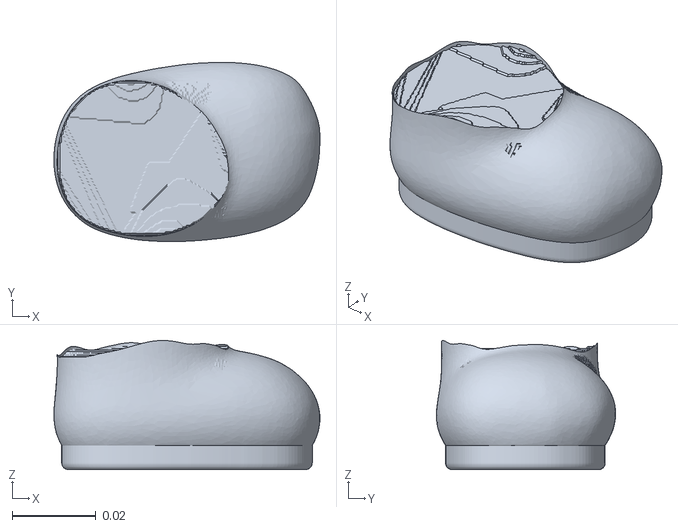
[picture p56: CAD file, 2026-10-13]
robot/v14_sts3032_hidden_w4/meshes/foot_l.stl
0.0634 x 0.0427 x 0.0307
