yuuundj/Haetburi-practice/robot/v14_xc330_hidden/meshes/foot_l.stl

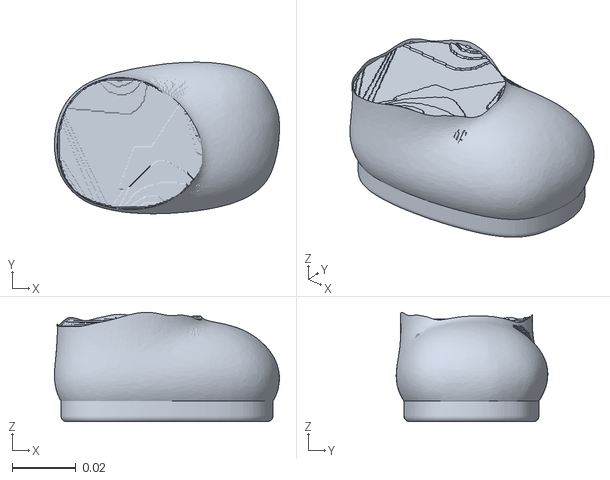
[picture p57: CAD file, 2026-10-13]
robot/v14_xc330_hidden/meshes/foot_l.stl
0.0708 x 0.0477 x 0.0343
