yuuundj/Haetburi-practice/robot/v14_xl330_hidden/meshes/leg_l.stl

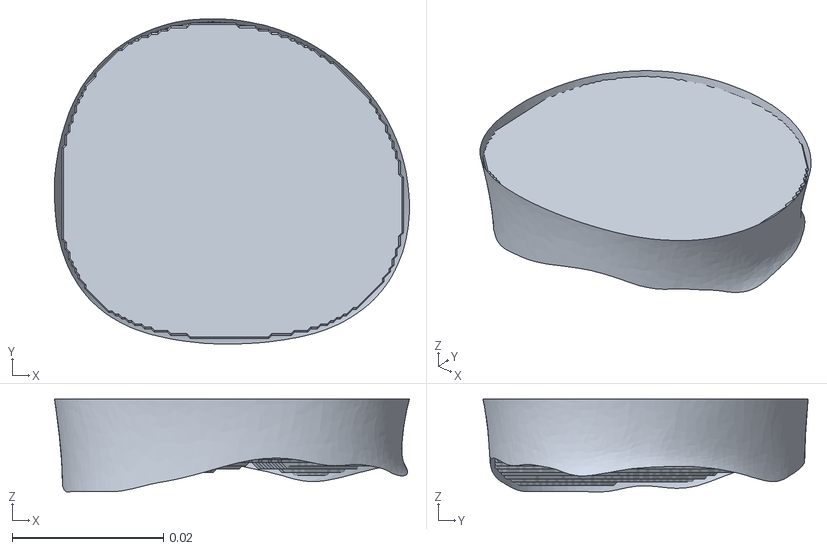
[picture p58: CAD file, 2026-10-13]
robot/v14_xl330_hidden/meshes/leg_l.stl
0.0469 x 0.043 x 0.0123
