yuuundj/Haetburi-practice/robot/v16_xm430/meshes/pelvis.stl

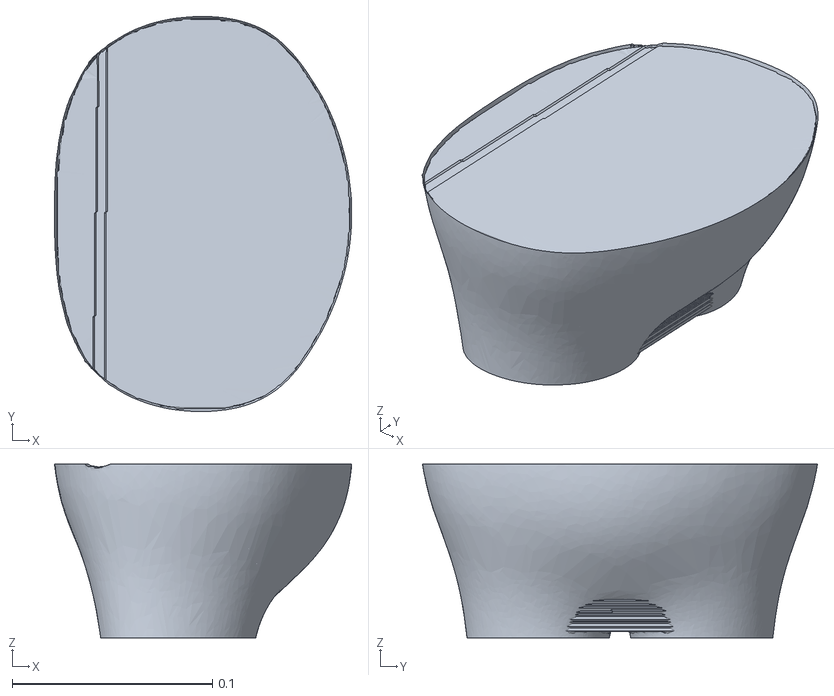
[picture p59: CAD file, 2026-10-13]
robot/v16_xm430/meshes/pelvis.stl
0.148 x 0.197 x 0.0866
