yuuundj/Haetburi-practice/robot/v17_sts3032_w4/meshes/foot_l.stl

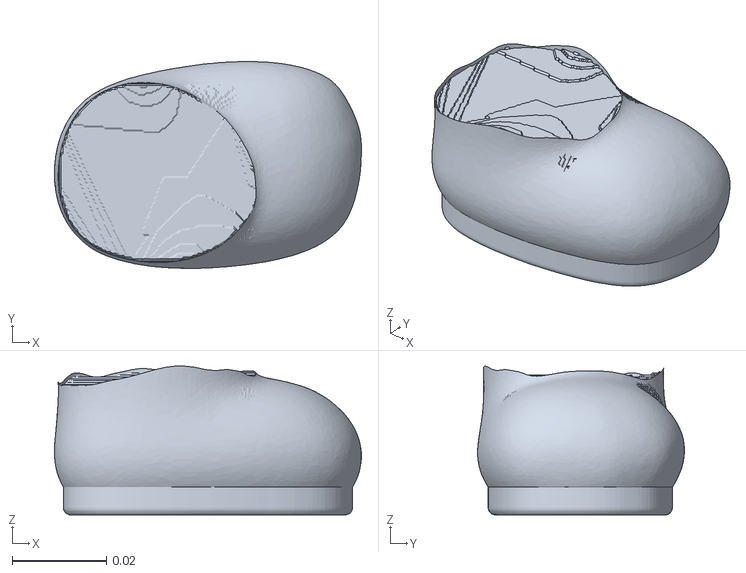
[picture p60: CAD file, 2026-10-13]
robot/v17_sts3032_w4/meshes/foot_l.stl
0.0653 x 0.044 x 0.0317
