yuuundj/Haetburi-practice/robot/v19_scs0009/meshes/torso.stl

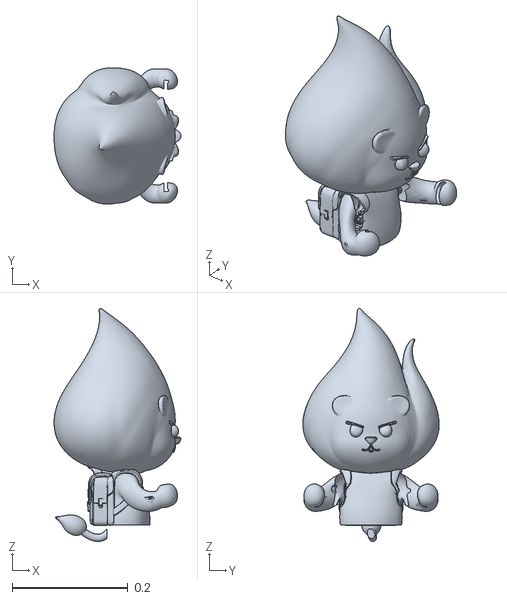
[picture p61: CAD file, 2026-10-13]
robot/v19_scs0009/meshes/torso.stl
0.219 x 0.236 x 0.403
