yuuundj/Haetburi-practice/robot/v19_xl330/meshes/leg_r.stl

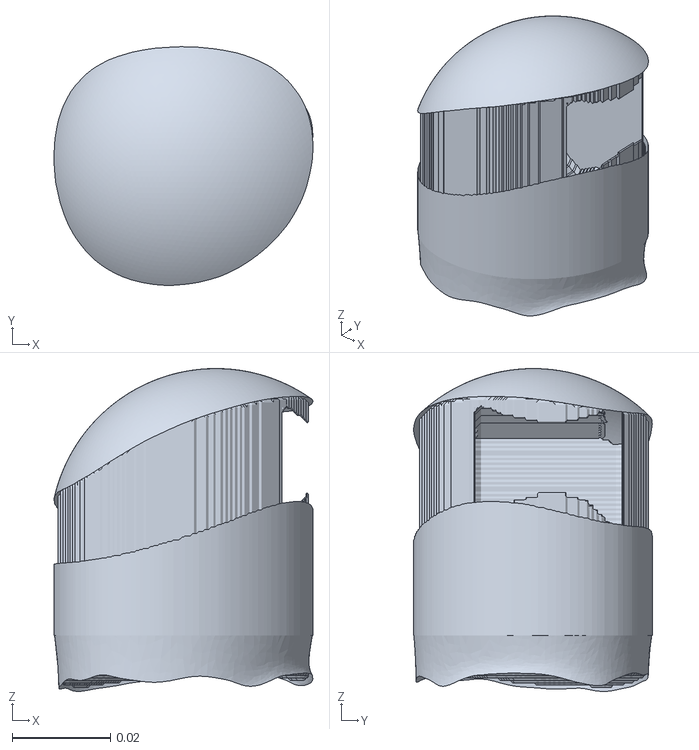
[picture p62: CAD file, 2026-10-13]
robot/v19_xl330/meshes/leg_r.stl
0.0527 x 0.0486 x 0.0658
