yuuundj/Haetburi-practice/robot/v21_sts3032_lite/meshes/torso.stl

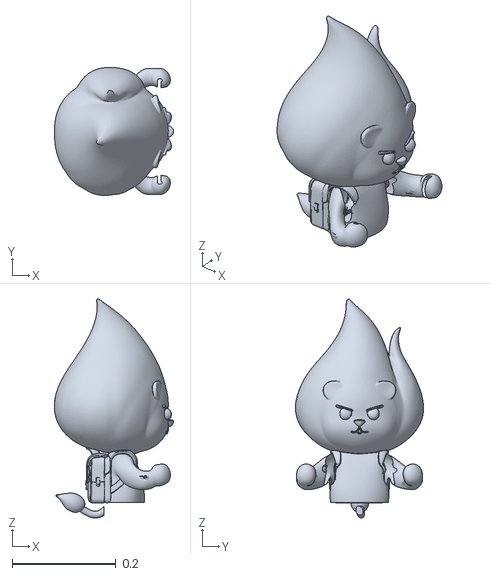
[picture p63: CAD file, 2026-10-13]
robot/v21_sts3032_lite/meshes/torso.stl
0.23 x 0.247 x 0.422
