yuuundj/Haetburi-practice/robot/v21_xc330/meshes/foot_r.stl

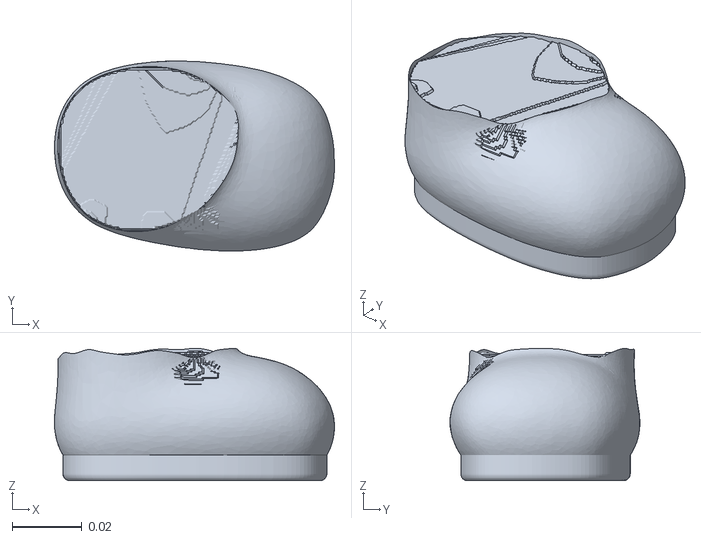
[picture p64: CAD file, 2026-10-13]
robot/v21_xc330/meshes/foot_r.stl
0.0803 x 0.0545 x 0.038
