yuuundj/Haetburi-practice/robot/v22_sts3032/meshes/pelvis.stl

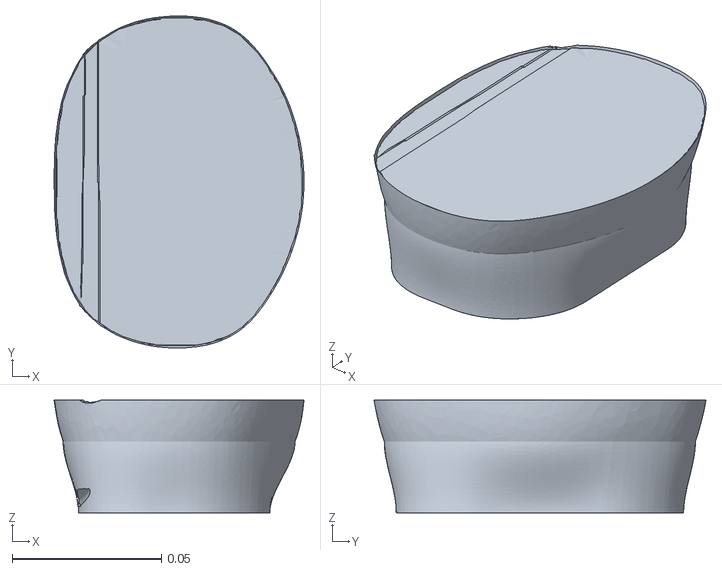
[picture p65: CAD file, 2026-10-13]
robot/v22_sts3032/meshes/pelvis.stl
0.0836 x 0.111 x 0.0378
