yuuundj/Haetburi-practice/robot/v11_newbase_display/meshes/foot_r.stl

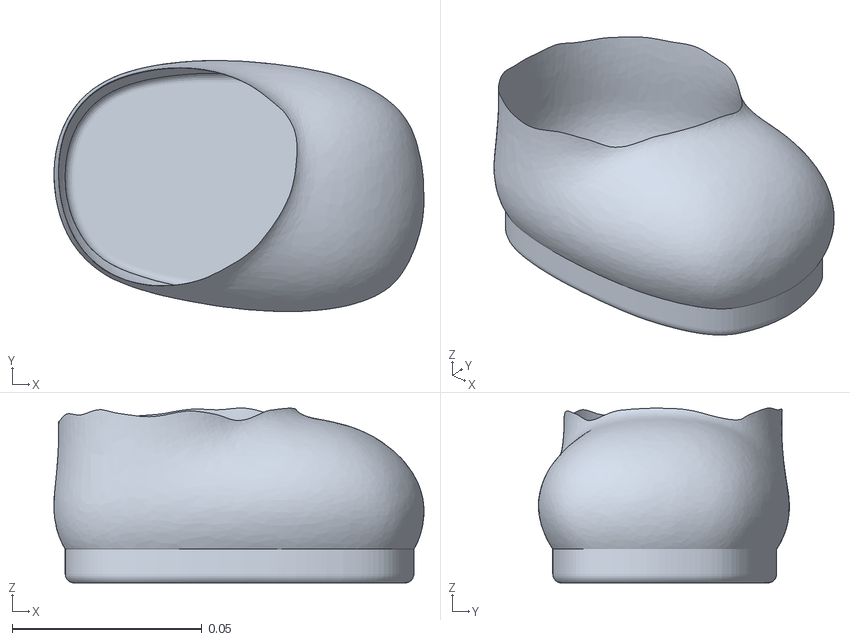
[picture p66: CAD file, 2026-10-13]
robot/v11_newbase_display/meshes/foot_r.stl
0.0975 x 0.0662 x 0.0461
