yuuundj/Haetburi-practice/robot/v13_ankle_pitch_display/meshes/foot_r.stl

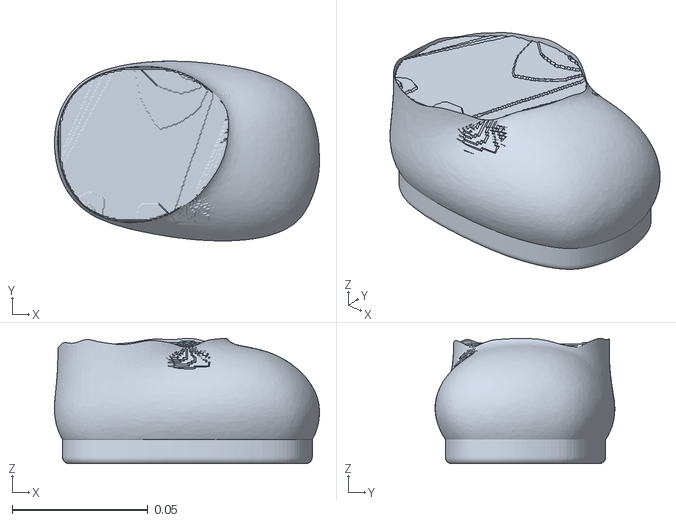
[picture p67: CAD file, 2026-10-13]
robot/v13_ankle_pitch_display/meshes/foot_r.stl
0.0975 x 0.0662 x 0.0461
