yuuundj/Haetburi-practice/robot/v14_scs0009_hidden/meshes/pelvis.stl

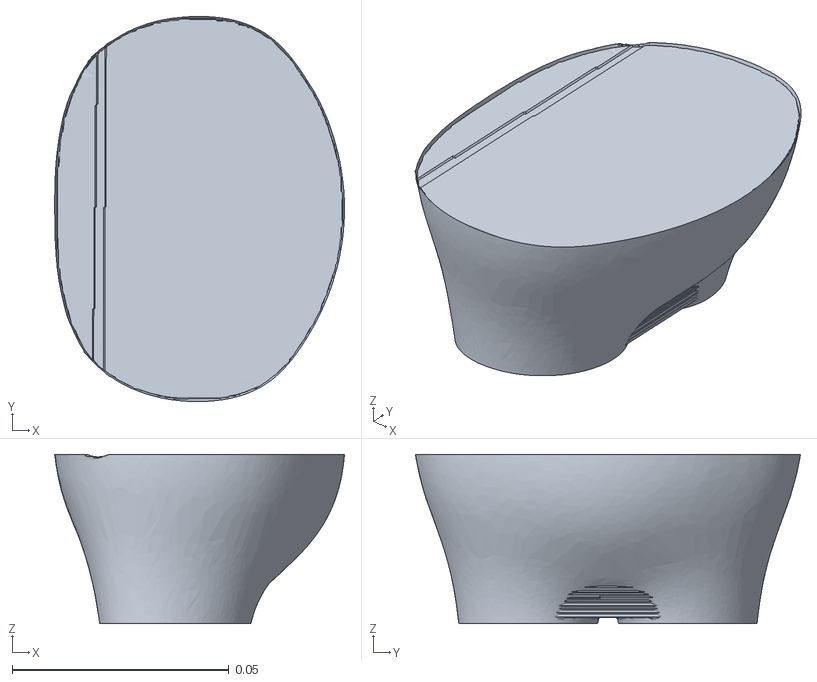
[picture p68: CAD file, 2026-10-13]
robot/v14_scs0009_hidden/meshes/pelvis.stl
0.0669 x 0.0888 x 0.039
