yuuundj/Haetburi-practice/robot/v14_sts3032_hidden/meshes/foot_r.stl

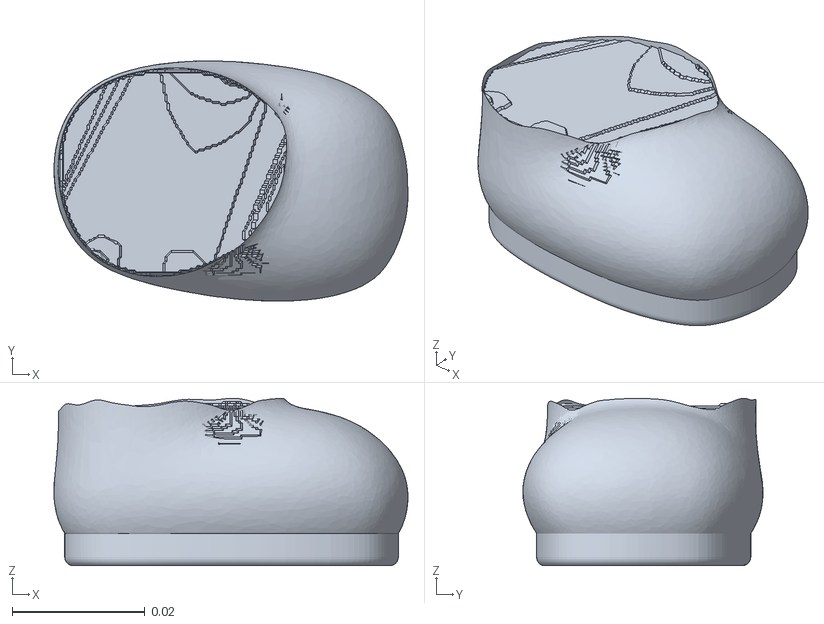
[picture p69: CAD file, 2026-10-13]
robot/v14_sts3032_hidden/meshes/foot_r.stl
0.0533 x 0.0361 x 0.0252
