yuuundj/Haetburi-practice/robot/v14_sts3032_hidden_7in/meshes/foot_r.stl

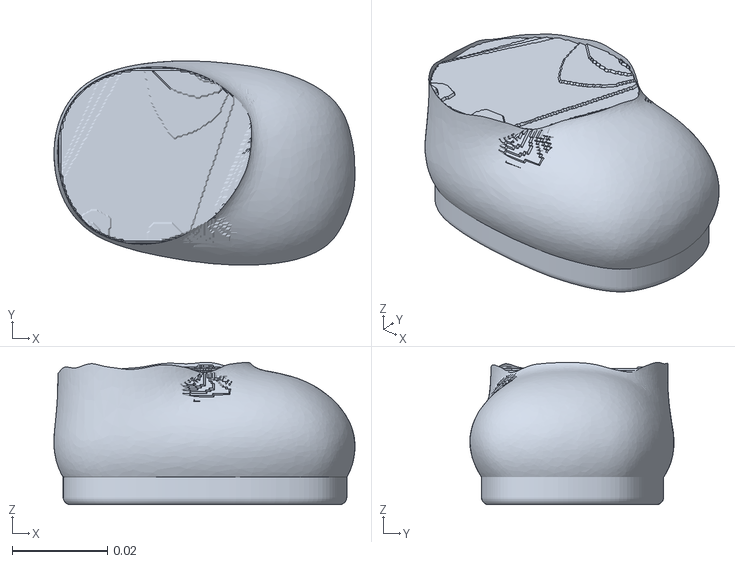
[picture p70: CAD file, 2026-10-13]
robot/v14_sts3032_hidden_7in/meshes/foot_r.stl
0.0631 x 0.0428 x 0.0298
