yuuundj/Haetburi-practice/robot/v14_xl330_hidden/meshes/torso.stl

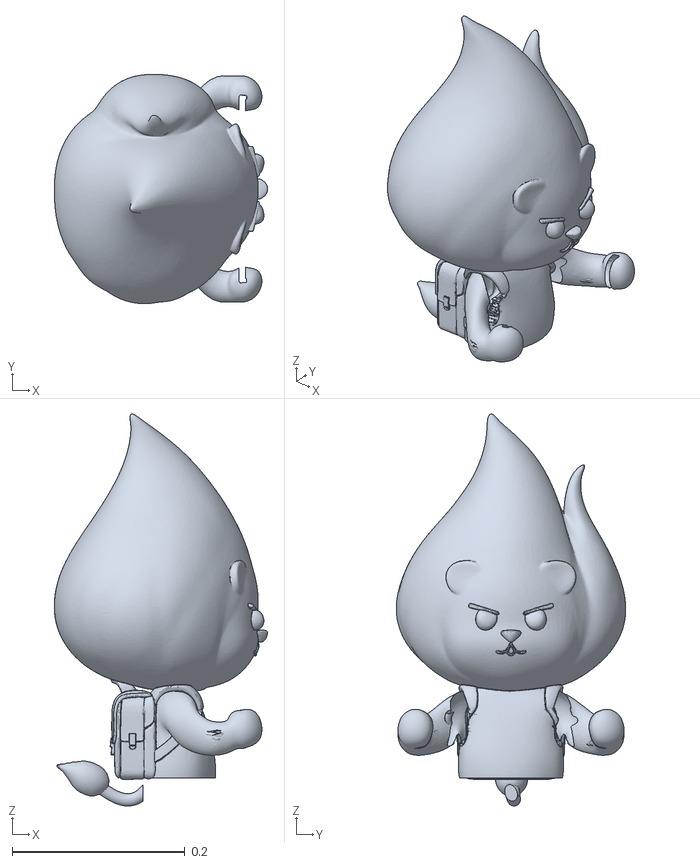
[picture p71: CAD file, 2026-10-13]
robot/v14_xl330_hidden/meshes/torso.stl
0.247 x 0.266 x 0.454
