yuuundj/Haetburi-practice/robot/v16_xm430/meshes/leg_l.stl

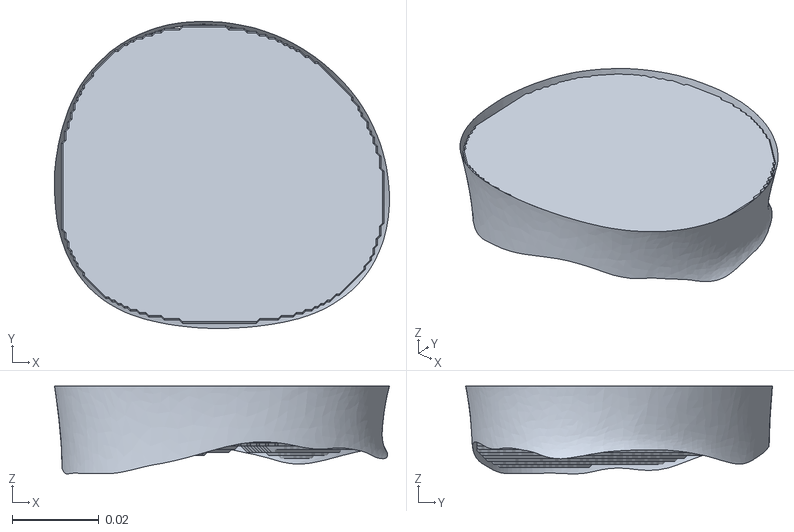
[picture p72: CAD file, 2026-10-13]
robot/v16_xm430/meshes/leg_l.stl
0.0774 x 0.0709 x 0.0203
