yuuundj/Haetburi-practice/robot/v17_sts3032_w4/meshes/pelvis.stl

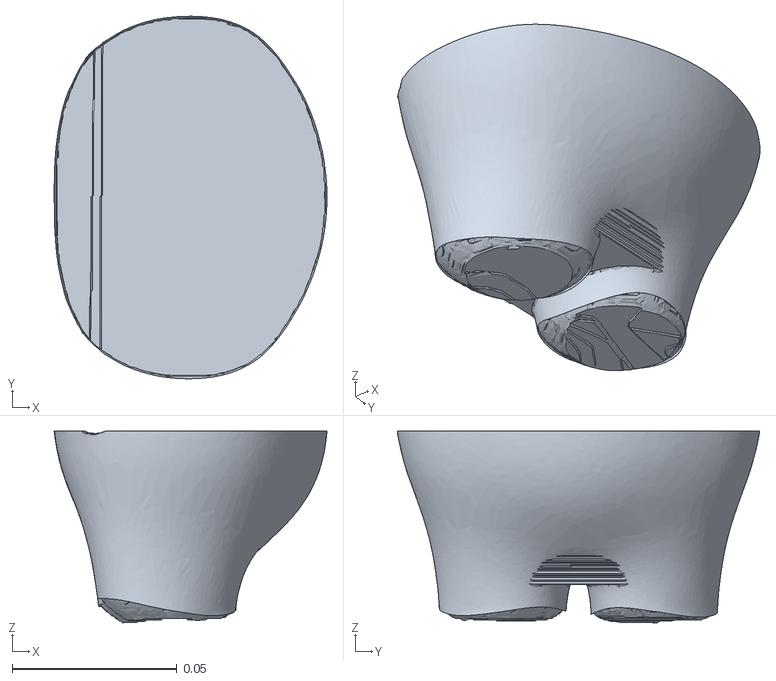
[picture p73: CAD file, 2026-10-13]
robot/v17_sts3032_w4/meshes/pelvis.stl
0.0829 x 0.11 x 0.0582
