yuuundj/Haetburi-practice/robot/v19_scs0009/meshes/leg_r.stl

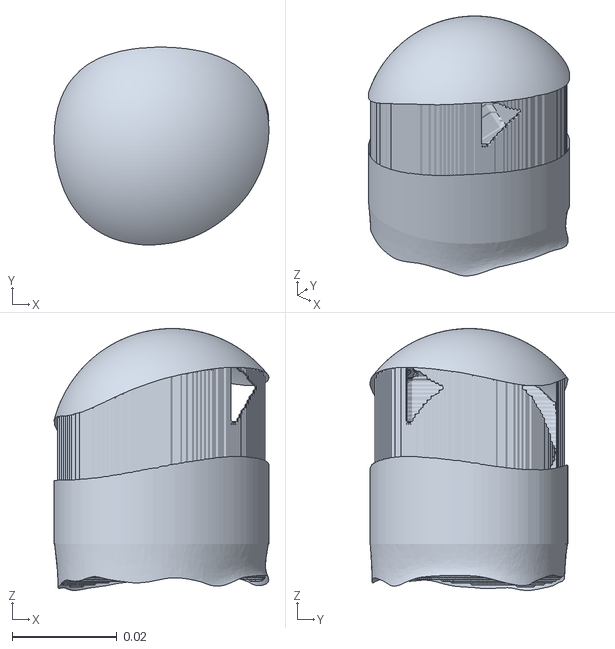
[picture p74: CAD file, 2026-10-13]
robot/v19_scs0009/meshes/leg_r.stl
0.041 x 0.0379 x 0.0501
