yuuundj/Haetburi-practice/robot/v19_xl330/meshes/foot_l.stl

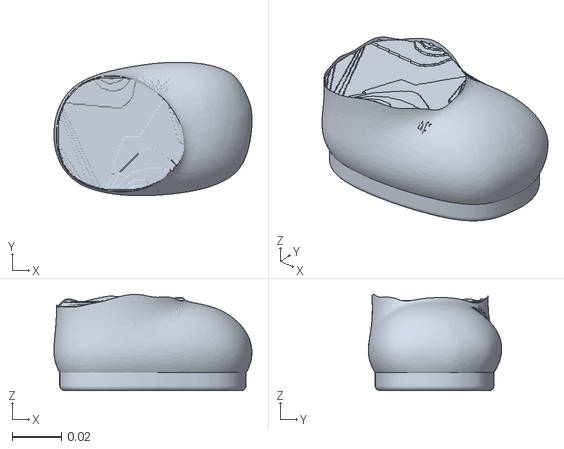
[picture p75: CAD file, 2026-10-13]
robot/v19_xl330/meshes/foot_l.stl
0.0806 x 0.0543 x 0.0391
