yuuundj/Haetburi-practice/robot/v21_sts3032_lite/meshes/leg_r.stl

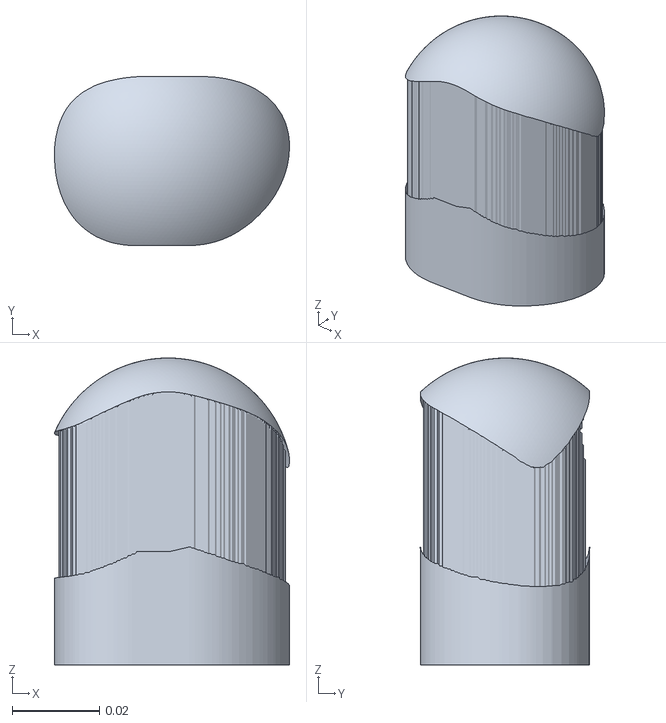
[picture p76: CAD file, 2026-10-13]
robot/v21_sts3032_lite/meshes/leg_r.stl
0.054 x 0.0388 x 0.0705
