yuuundj/Haetburi-practice/robot/v21_xc330/meshes/leg_r.stl

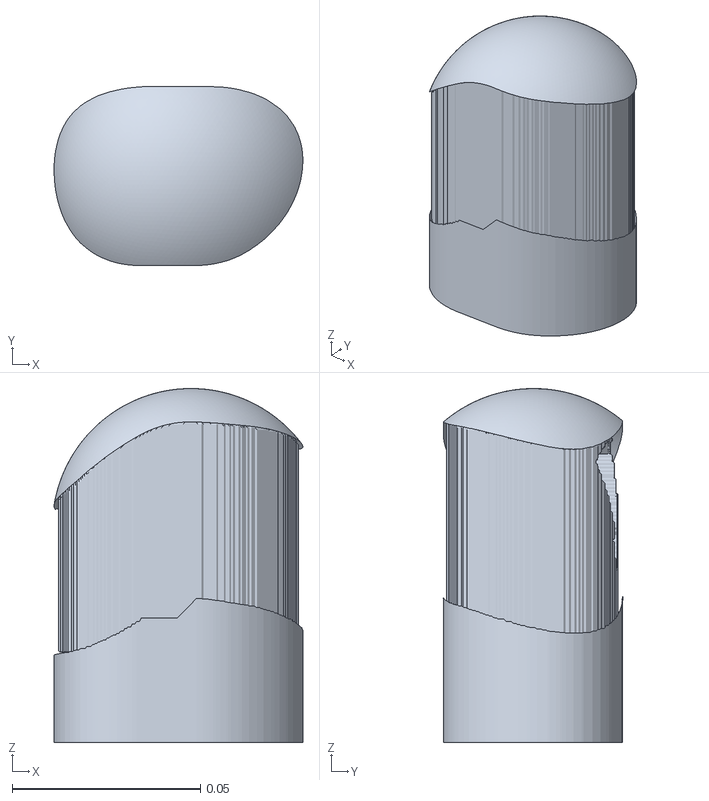
[picture p77: CAD file, 2026-10-13]
robot/v21_xc330/meshes/leg_r.stl
0.0661 x 0.0476 x 0.094
