yuuundj/Haetburi-practice/robot/v22_sts3032/meshes/leg_r.stl

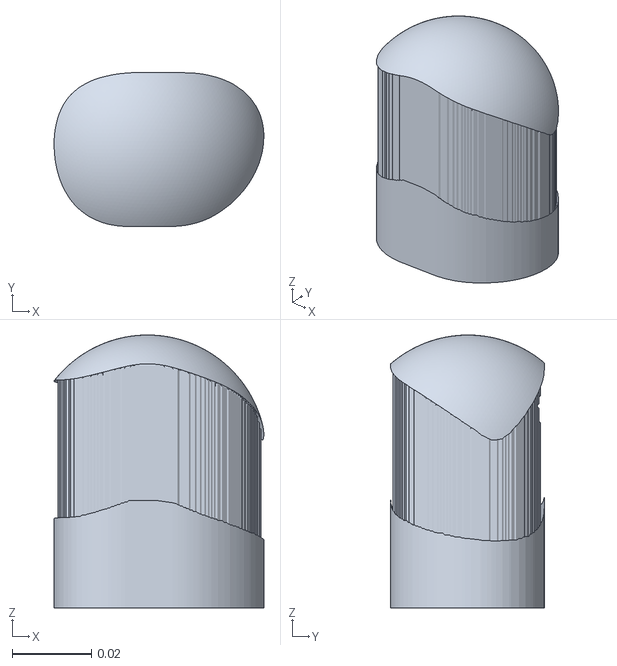
[picture p78: CAD file, 2026-10-13]
robot/v22_sts3032/meshes/leg_r.stl
0.053 x 0.0388 x 0.0689
