yuuundj/Haetburi-practice/modelings/haetburi_feet_v1.stl

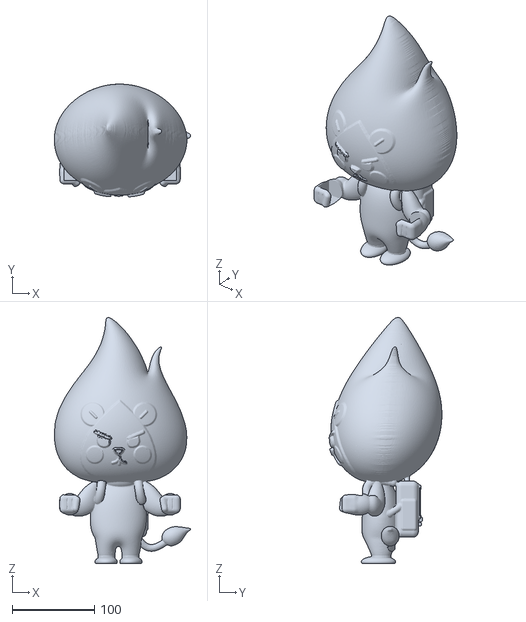
[picture p79: CAD file, 2026-09-24]
modelings/haetburi_feet_v1.stl
166.3 x 137.5 x 300.0
