yuuundj/Haetburi-practice/robot/v11_newbase_display/meshes/pelvis.stl

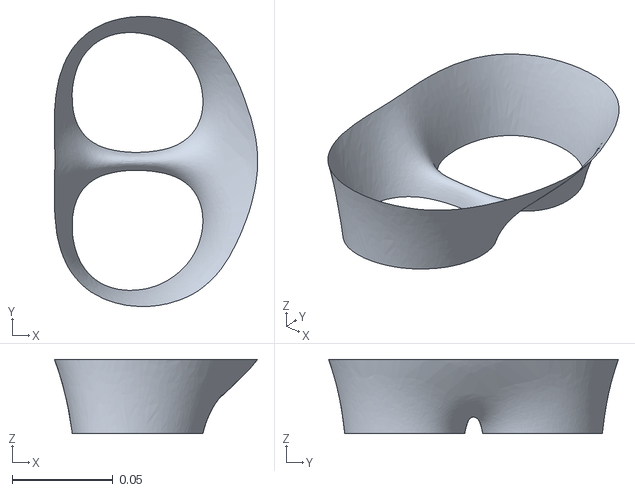
[picture p80: CAD file, 2026-10-13]
robot/v11_newbase_display/meshes/pelvis.stl
0.101 x 0.144 x 0.0369
