yuuundj/Haetburi-practice/robot/v12_slipper_display/meshes/leg_r.stl

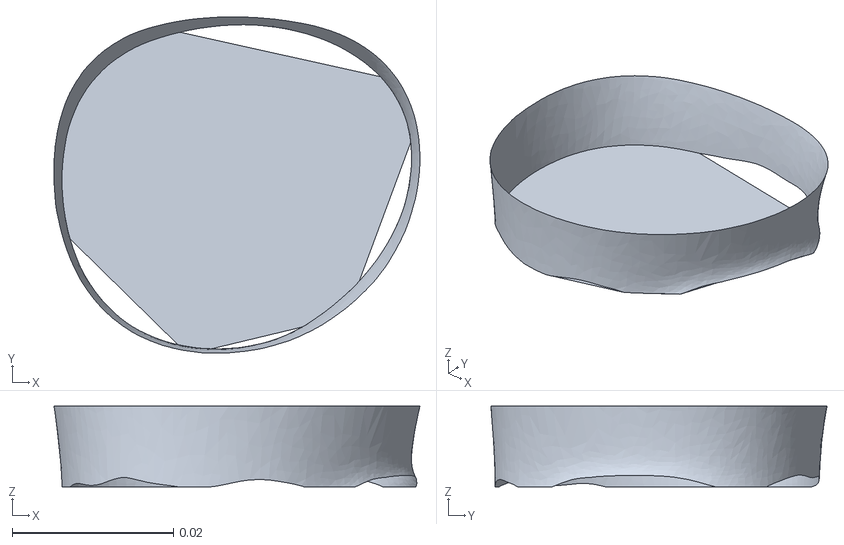
[picture p81: CAD file, 2026-10-13]
robot/v12_slipper_display/meshes/leg_r.stl
0.0454 x 0.0417 x 0.01
