yuuundj/Haetburi-practice/robot/v13_ankle_pitch_display/meshes/leg_r.stl

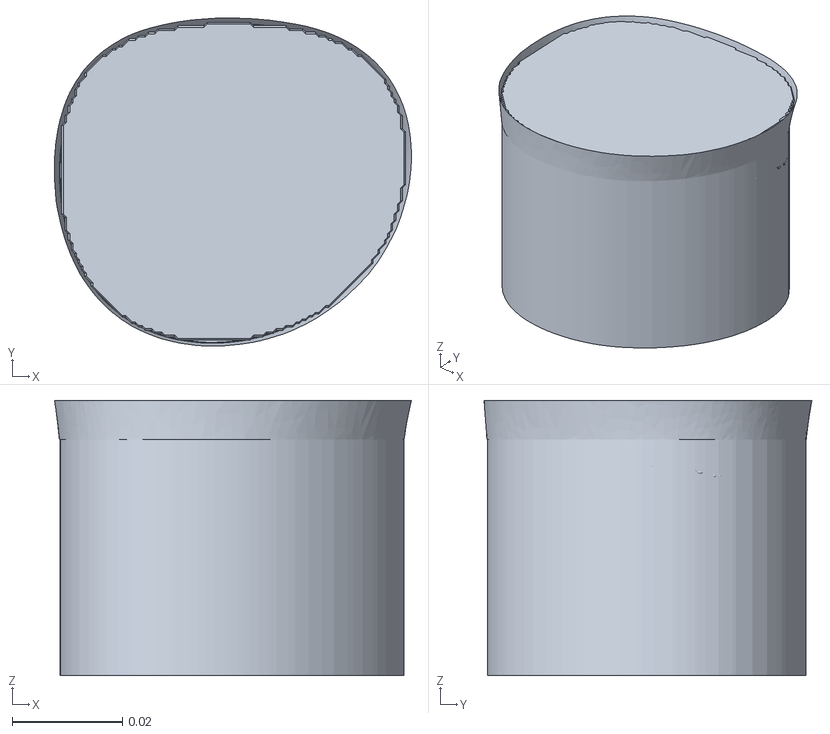
[picture p82: CAD file, 2026-10-13]
robot/v13_ankle_pitch_display/meshes/leg_r.stl
0.0648 x 0.0596 x 0.05
