yuuundj/Haetburi-practice/robot/v14_scs0009_hidden/meshes/leg_r.stl

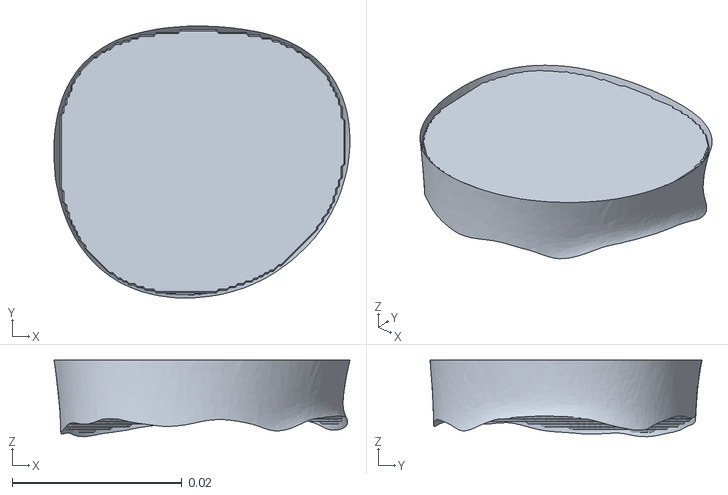
[picture p83: CAD file, 2026-10-13]
robot/v14_scs0009_hidden/meshes/leg_r.stl
0.0349 x 0.032 x 0.00902
