yuuundj/Haetburi-practice/robot/v14_sts3032_hidden/meshes/torso.stl

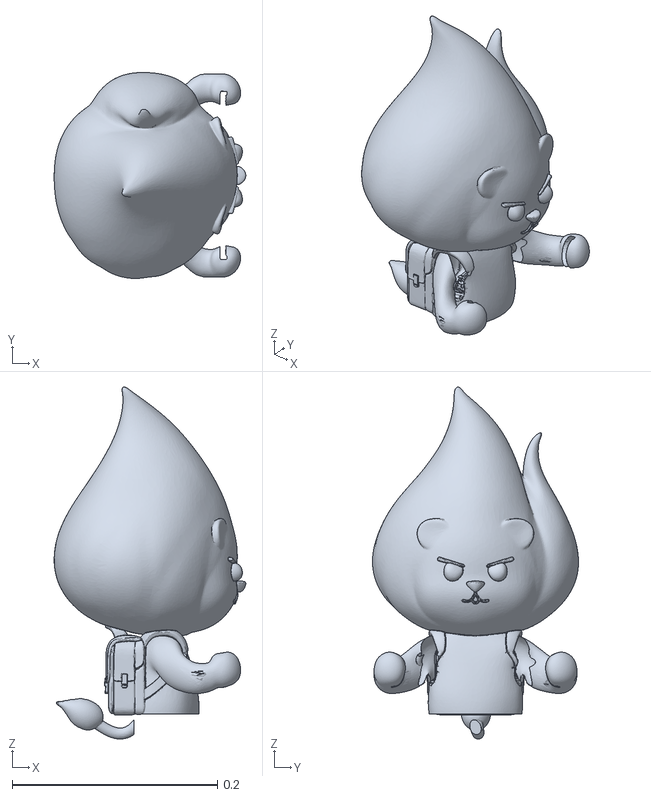
[picture p84: CAD file, 2026-10-13]
robot/v14_sts3032_hidden/meshes/torso.stl
0.187 x 0.201 x 0.343
