yuuundj/Haetburi-practice/robot/v14_sts3032_hidden_7in/meshes/torso.stl

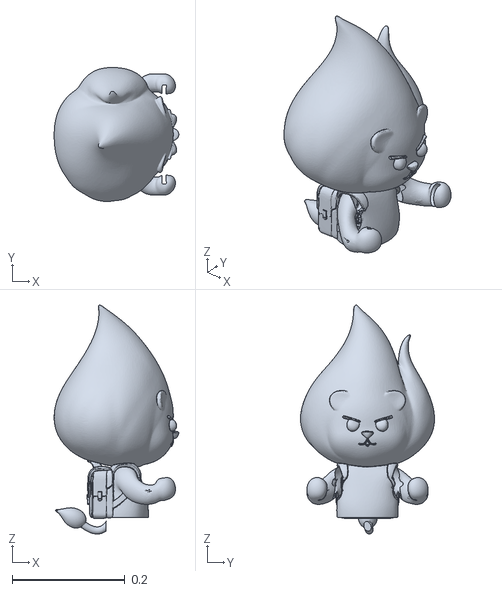
[picture p85: CAD file, 2026-10-13]
robot/v14_sts3032_hidden_7in/meshes/torso.stl
0.221 x 0.238 x 0.406
