yuuundj/Haetburi-practice/robot/v14_xl330_hidden/meshes/pelvis.stl

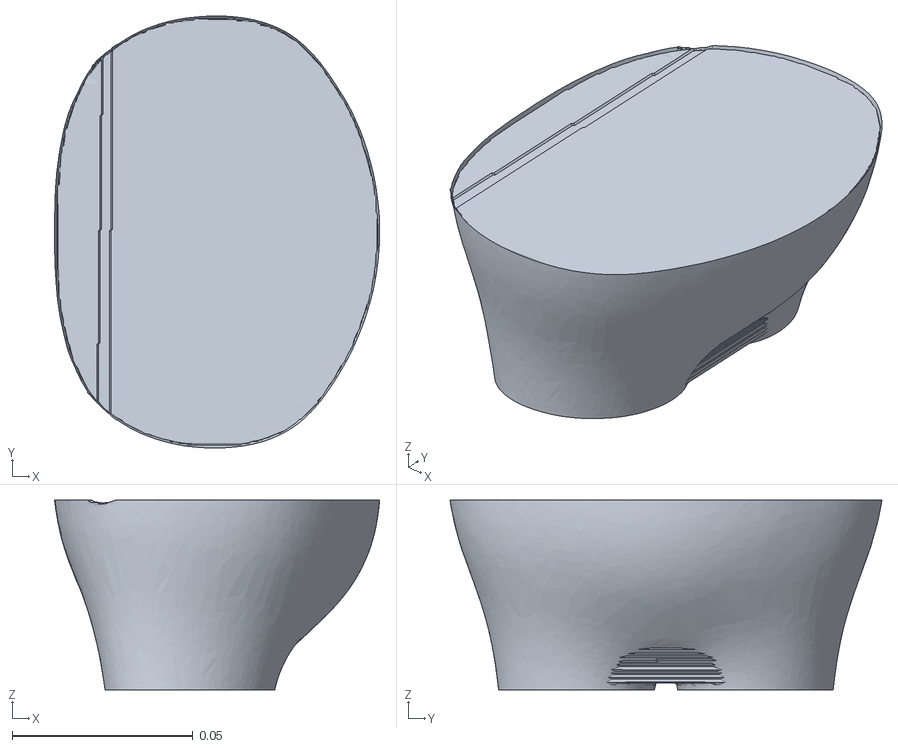
[picture p86: CAD file, 2026-10-13]
robot/v14_xl330_hidden/meshes/pelvis.stl
0.0899 x 0.119 x 0.0525
