yuuundj/Haetburi-practice/robot/v16_xm430/meshes/foot_l.stl

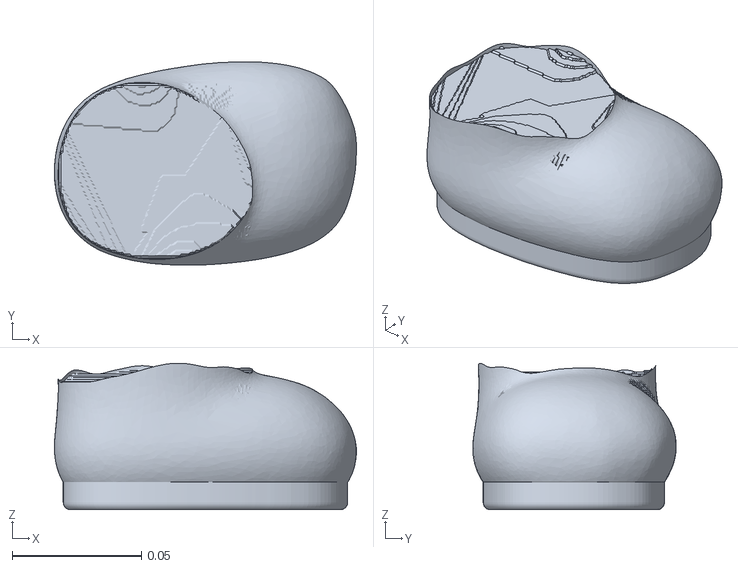
[picture p87: CAD file, 2026-10-13]
robot/v16_xm430/meshes/foot_l.stl
0.117 x 0.0787 x 0.0567
