yuuundj/Haetburi-practice/robot/v17_sts3032_w4/meshes/leg_r.stl

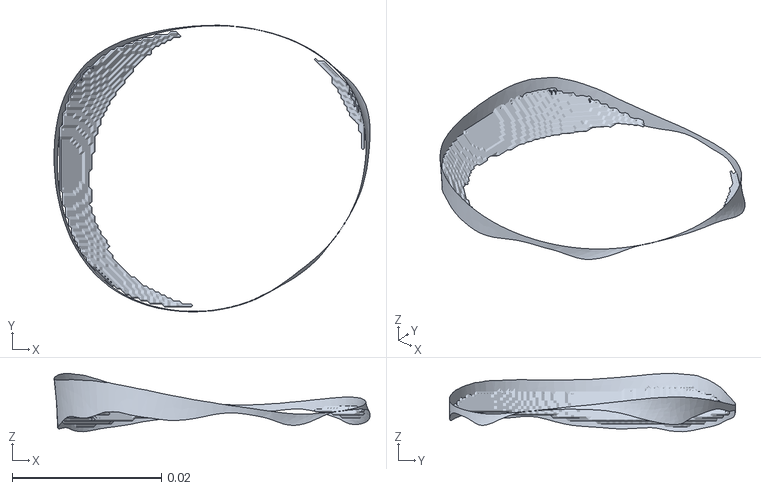
[picture p88: CAD file, 2026-10-13]
robot/v17_sts3032_w4/meshes/leg_r.stl
0.0423 x 0.0384 x 0.00784
