yuuundj/Haetburi-practice/robot/v19_xl330/meshes/pelvis.stl

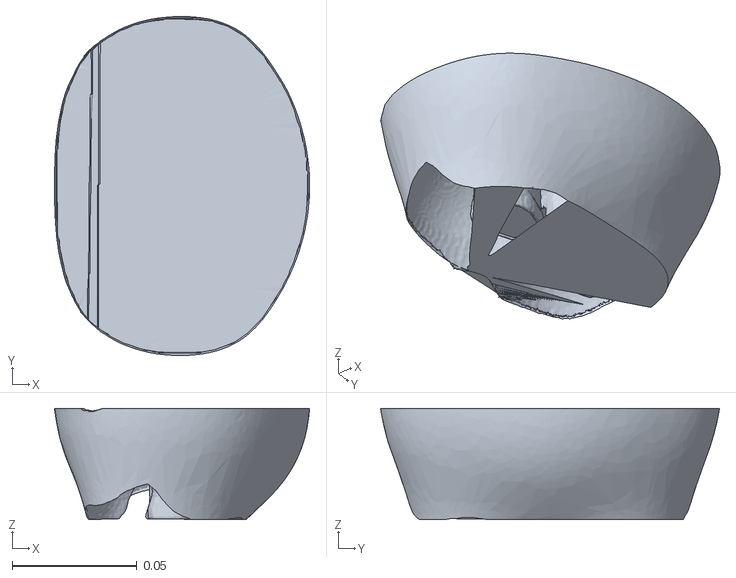
[picture p89: CAD file, 2026-10-13]
robot/v19_xl330/meshes/pelvis.stl
0.102 x 0.136 x 0.0446
