yuuundj/Haetburi-practice/robot/v21_xc330/meshes/pelvis.stl

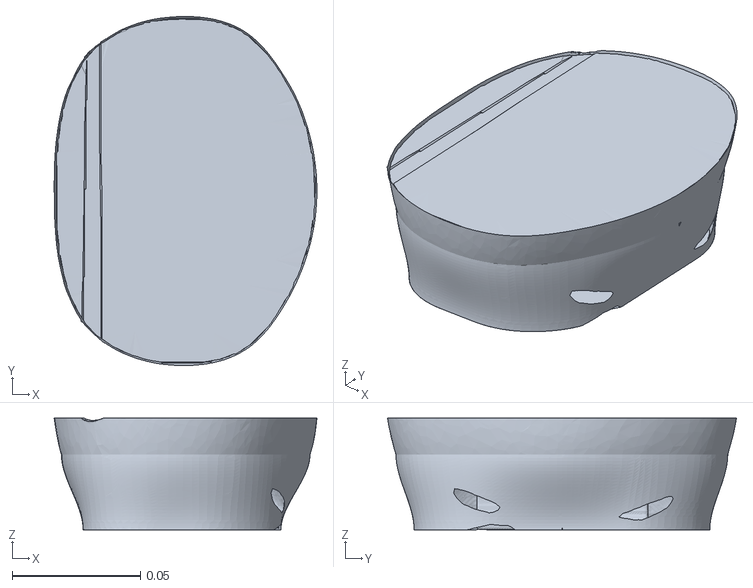
[picture p90: CAD file, 2026-10-13]
robot/v21_xc330/meshes/pelvis.stl
0.102 x 0.136 x 0.0436
