yuuundj/Haetburi-practice/robot/v22_sts3032/meshes/leg_l.stl

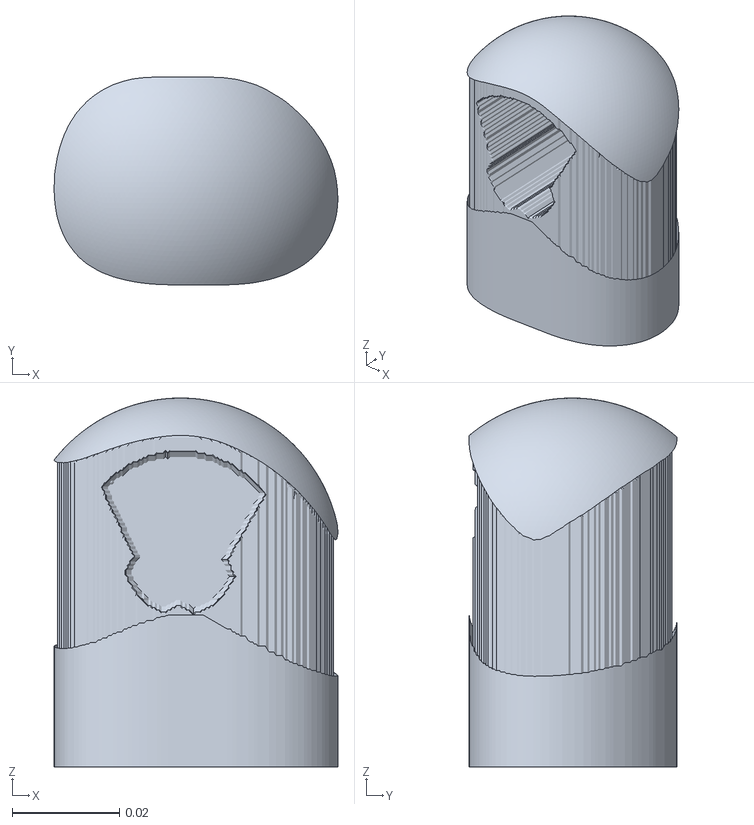
[picture p91: CAD file, 2026-10-13]
robot/v22_sts3032/meshes/leg_l.stl
0.053 x 0.0388 x 0.069
