yuuundj/Haetburi-practice/robot/v11_newbase_display/meshes/leg_l.stl

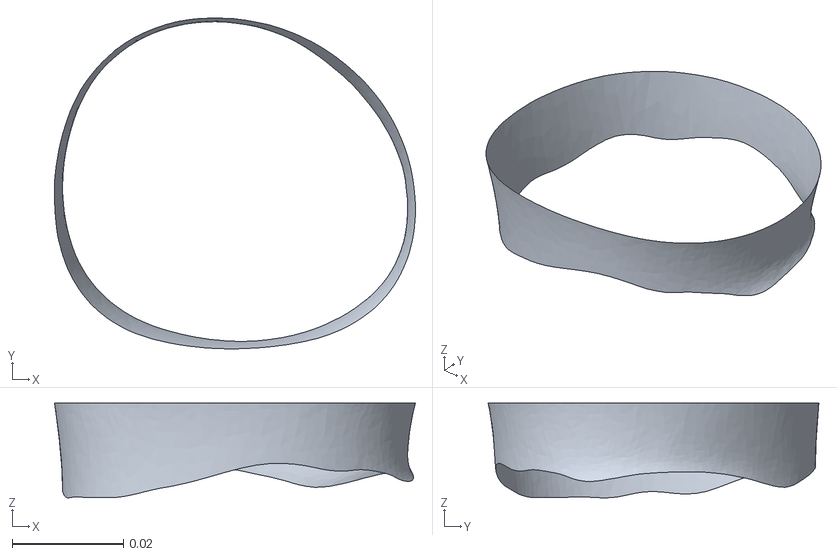
[picture p92: CAD file, 2026-10-13]
robot/v11_newbase_display/meshes/leg_l.stl
0.0649 x 0.0595 x 0.017
