yuuundj/Haetburi-practice/robot/v12_slipper_display/meshes/pelvis.stl

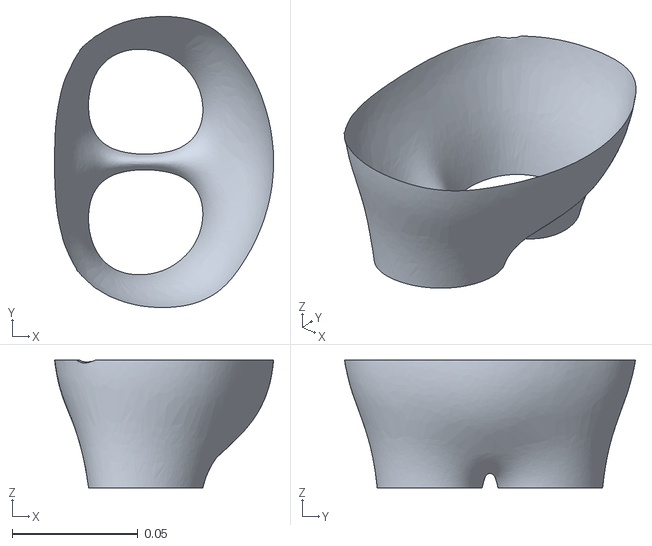
[picture p93: CAD file, 2026-10-13]
robot/v12_slipper_display/meshes/pelvis.stl
0.0871 x 0.116 x 0.0508
