yuuundj/Haetburi-practice/robot/v14_scs0009_hidden/meshes/foot_r.stl

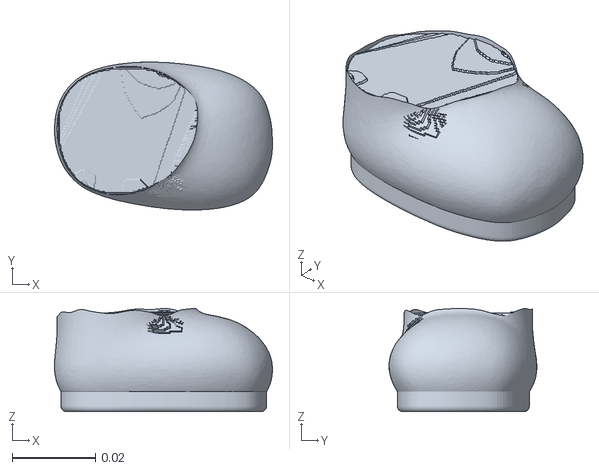
[picture p95: CAD file, 2026-10-13]
robot/v14_scs0009_hidden/meshes/foot_r.stl
0.0524 x 0.0356 x 0.0248
