yuuundj/Haetburi-practice/robot/v14_sts3032_hidden/meshes/pelvis.stl

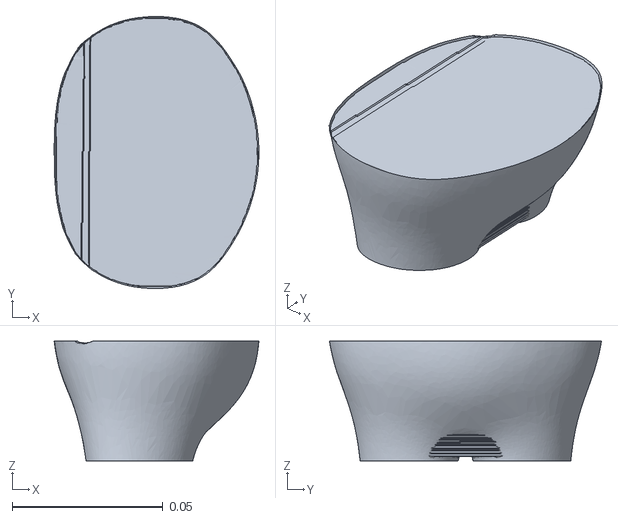
[picture p96: CAD file, 2026-10-13]
robot/v14_sts3032_hidden/meshes/pelvis.stl
0.068 x 0.0902 x 0.0397
