yuuundj/Haetburi-practice/robot/v14_sts3032_hidden_w4/meshes/pelvis.stl

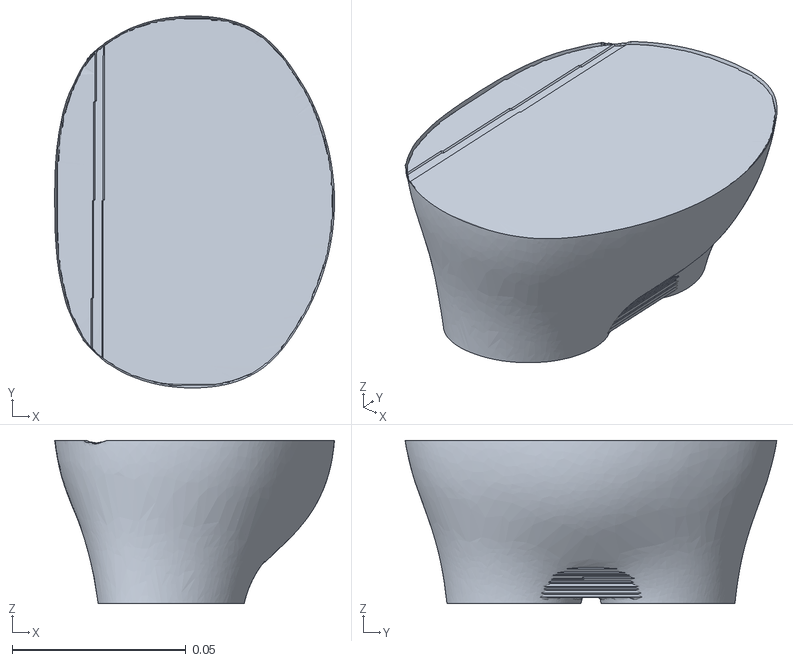
[picture p97: CAD file, 2026-10-13]
robot/v14_sts3032_hidden_w4/meshes/pelvis.stl
0.0805 x 0.107 x 0.047
