yuuundj/Haetburi-practice/robot/v17_sts3032_w4/meshes/foot_r.stl

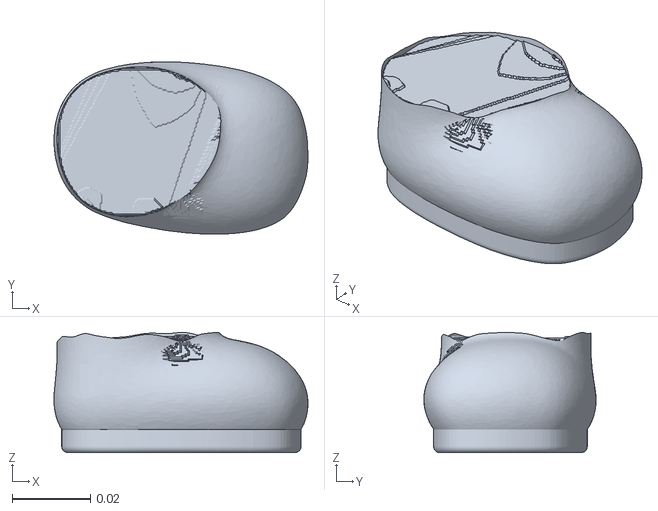
[picture p98: CAD file, 2026-10-13]
robot/v17_sts3032_w4/meshes/foot_r.stl
0.065 x 0.0441 x 0.0307
