yuuundj/Haetburi-practice/robot/v21_sts3032_lite/meshes/pelvis.stl

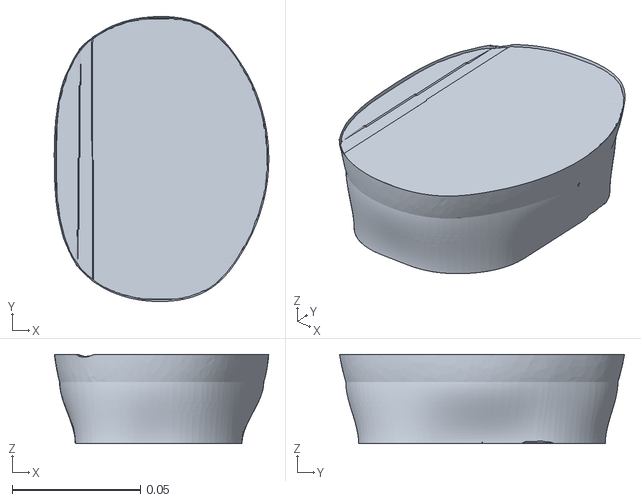
[picture p99: CAD file, 2026-10-13]
robot/v21_sts3032_lite/meshes/pelvis.stl
0.0836 x 0.111 x 0.0348
