yuuundj/Haetburi-practice/robot/v21_xc330/meshes/leg_l.stl

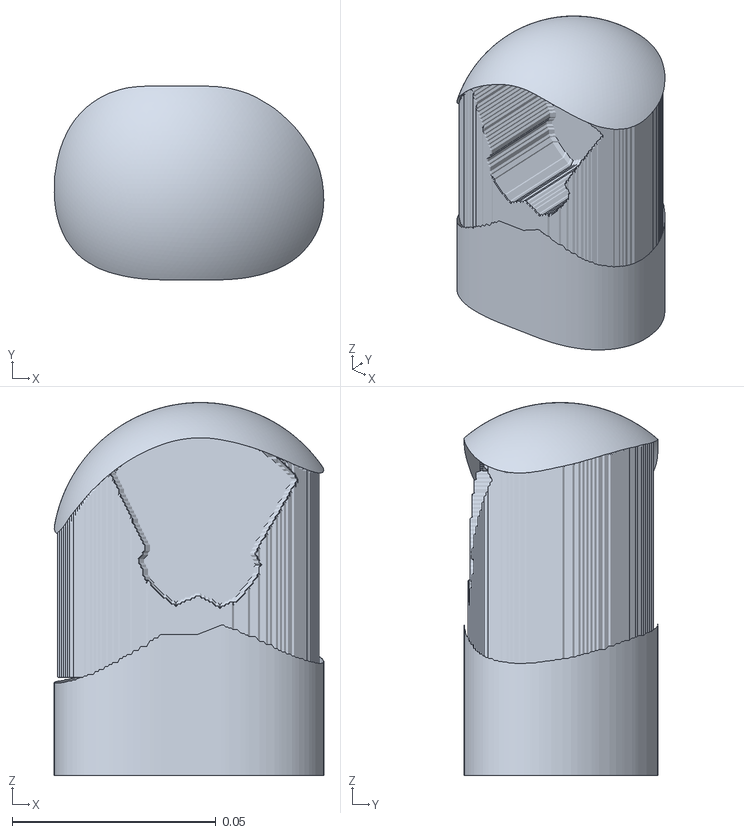
[picture p100: CAD file, 2026-10-13]
robot/v21_xc330/meshes/leg_l.stl
0.0662 x 0.0475 x 0.0916
