yuuundj/Haetburi-practice/robot/v22_sts3032/meshes/foot_l.stl

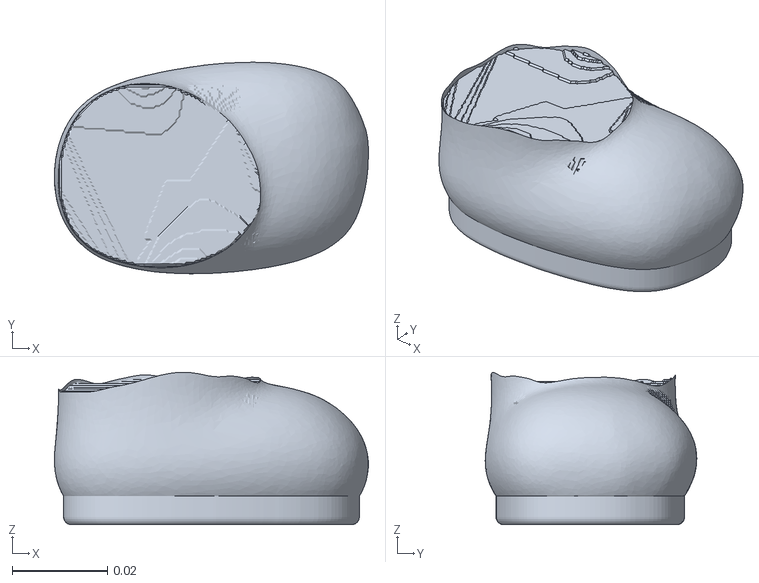
[picture p101: CAD file, 2026-10-13]
robot/v22_sts3032/meshes/foot_l.stl
0.0658 x 0.0444 x 0.0319
