yuuundj/Haetburi-practice/robot/v11_newbase_display/meshes/foot_l.stl

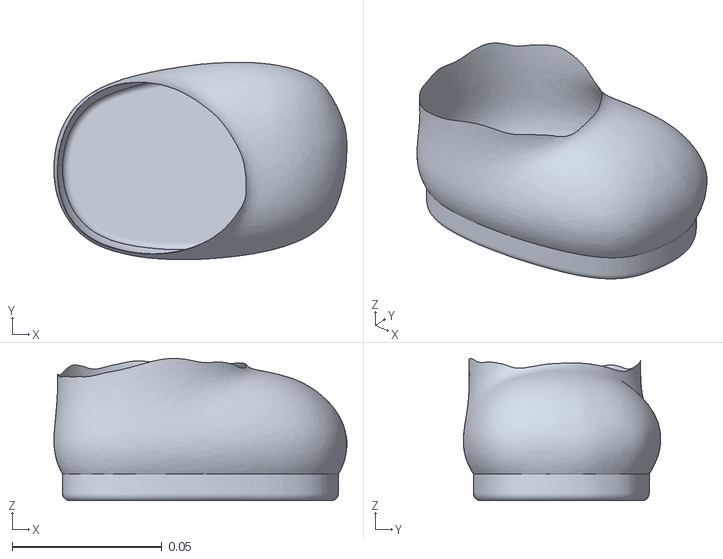
[picture p102: CAD file, 2026-10-13]
robot/v11_newbase_display/meshes/foot_l.stl
0.0979 x 0.066 x 0.0475
