yuuundj/Haetburi-practice/robot/v12_slipper_display/meshes/torso.stl

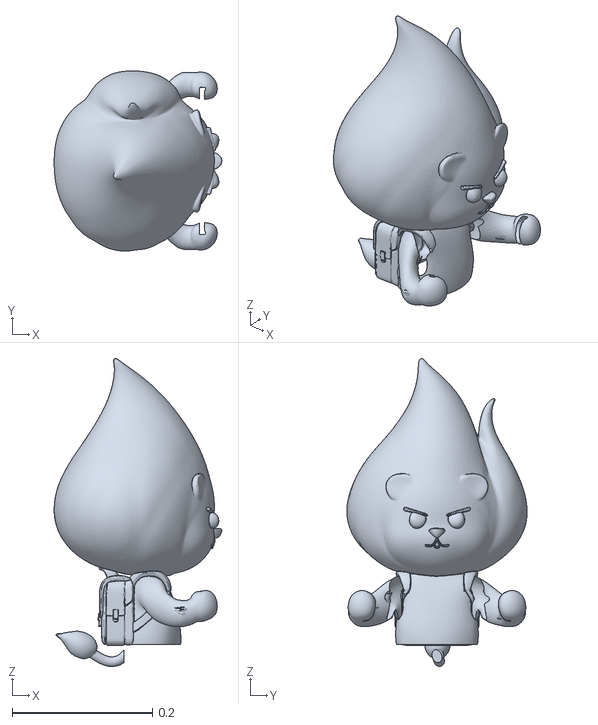
[picture p103: CAD file, 2026-10-13]
robot/v12_slipper_display/meshes/torso.stl
0.239 x 0.257 x 0.44
