yuuundj/Haetburi-practice/robot/v13_ankle_pitch_display/meshes/leg_l.stl

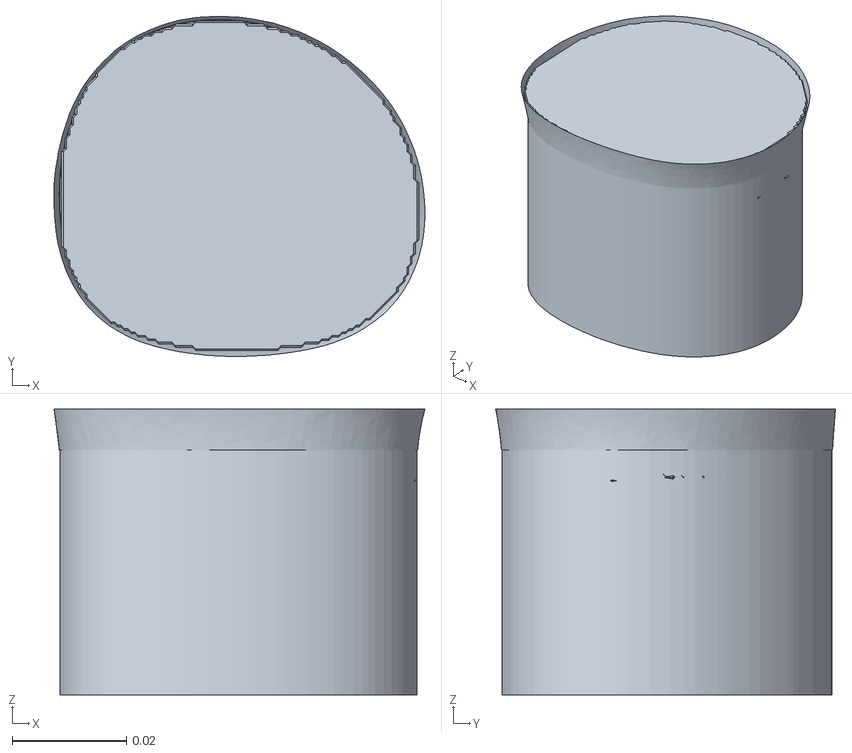
[picture p104: CAD file, 2026-10-13]
robot/v13_ankle_pitch_display/meshes/leg_l.stl
0.0649 x 0.0595 x 0.05
