yuuundj/Haetburi-practice/robot/v14_scs0009_hidden/meshes/torso.stl

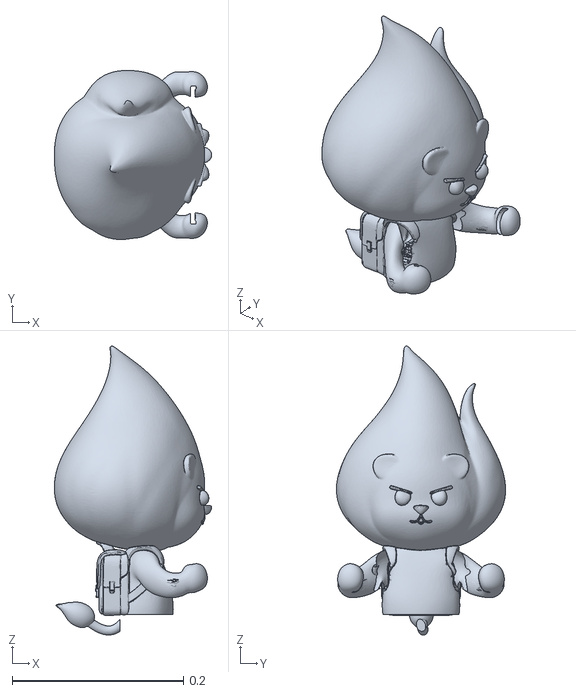
[picture p105: CAD file, 2026-10-13]
robot/v14_scs0009_hidden/meshes/torso.stl
0.184 x 0.198 x 0.338
