yuuundj/Haetburi-practice/robot/v16_xm430/meshes/torso.stl

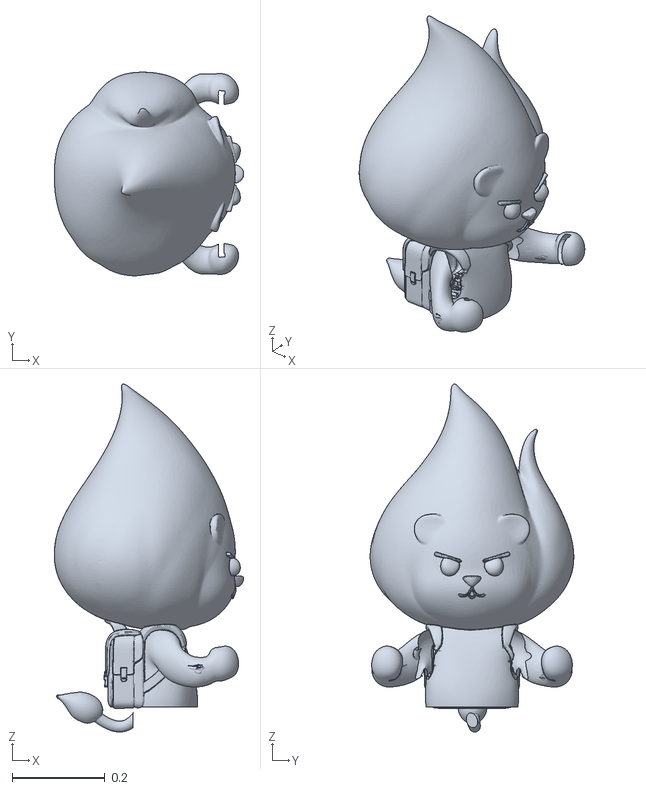
[picture p107: CAD file, 2026-10-13]
robot/v16_xm430/meshes/torso.stl
0.408 x 0.439 x 0.749
