yuuundj/Haetburi-practice/robot/v17_sts3032_w4/meshes/torso.stl

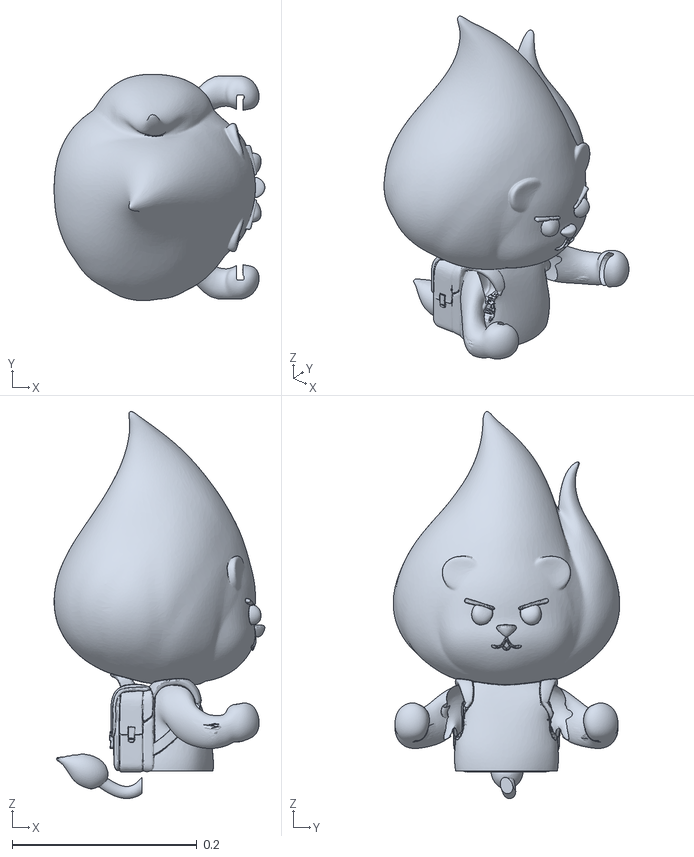
[picture p108: CAD file, 2026-10-13]
robot/v17_sts3032_w4/meshes/torso.stl
0.228 x 0.245 x 0.419
