yuuundj/Haetburi-practice/robot/v19_scs0009/meshes/pelvis.stl

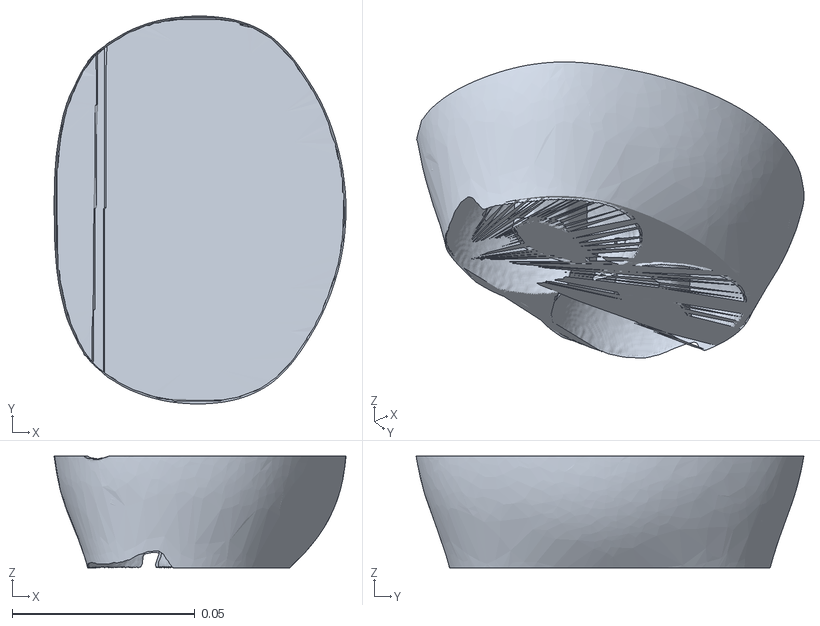
[picture p109: CAD file, 2026-10-13]
robot/v19_scs0009/meshes/pelvis.stl
0.0798 x 0.106 x 0.0306
