yuuundj/Haetburi-practice/robot/v19_xl330/meshes/leg_l.stl

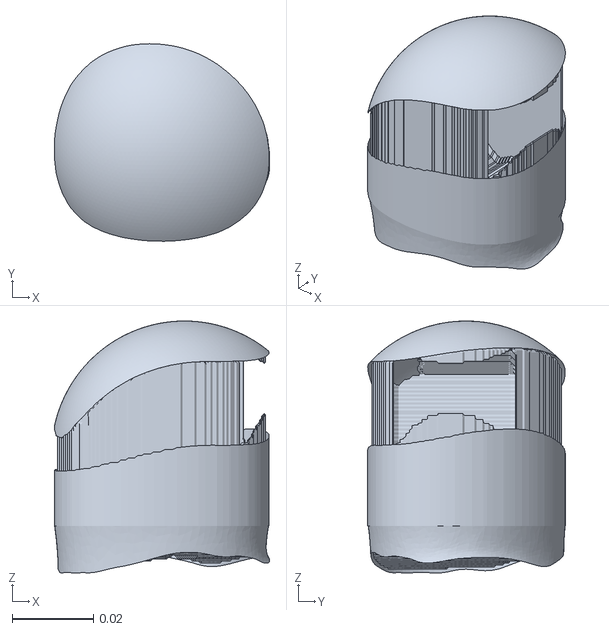
[picture p110: CAD file, 2026-10-13]
robot/v19_xl330/meshes/leg_l.stl
0.0529 x 0.0485 x 0.0619
