yuuundj/Haetburi-practice/(list of files, cad)

Other CAD files:
robot/v21_xc330/body_native.stl
robot/v22_sts3032/body_native.stl
modelings/haetburi_display_parts.stl
robot/v12_slipper_display/meshes/foot_l.stl
robot/v14_xc330_hidden/meshes/leg_r.stl
robot/v19_scs0009/meshes/foot_r.stl
modelings/haetburi_grip_20mm_300mm.stl
robot/v14_xl330_hidden/meshes/leg_r.stl
robot/v16_xm430/meshes/leg_r.stl
robot/v19_scs0009/meshes/leg_l.stl
robot/v14_sts3032_hidden_w4/meshes/torso.stl
robot/v22_sts3032/meshes/torso.stl
archive/robot_before_variants/meshes/foot_l.stl
archive/robot_before_variants/meshes/foot_r.stl
archive/robot_before_variants/meshes/pelvis.stl
archive/robot_before_variants/meshes/torso.stl
robot/v10_split_display/meshes/foot_l.stl
robot/v10_split_display/meshes/foot_r.stl
robot/v10_split_display/meshes/leg_l.stl
robot/v10_split_display/meshes/leg_r.stl
robot/v10_split_display/meshes/pelvis.stl
robot/v10_split_display/meshes/torso.stl
robot/v14_scs0009/meshes/foot_l.stl
robot/v14_scs0009/meshes/foot_r.stl
robot/v14_scs0009/meshes/leg_l.stl
robot/v14_scs0009/meshes/leg_r.stl
robot/v14_scs0009/meshes/pelvis.stl
robot/v14_scs0009/meshes/torso.stl
robot/v14_sts3032/meshes/foot_l.stl
robot/v14_sts3032/meshes/foot_r.stl
robot/v14_sts3032/meshes/leg_l.stl
robot/v14_sts3032/meshes/leg_r.stl
robot/v14_sts3032/meshes/pelvis.stl
robot/v14_sts3032/meshes/torso.stl
robot/v14_sts3032_w4/meshes/foot_l.stl
robot/v14_sts3032_w4/meshes/foot_r.stl
robot/v14_sts3032_w4/meshes/leg_l.stl
robot/v14_sts3032_w4/meshes/leg_r.stl
robot/v14_sts3032_w4/meshes/pelvis.stl
robot/v14_sts3032_w4/meshes/torso.stl
robot/v14_xc330/meshes/foot_l.stl
robot/v14_xc330/meshes/foot_r.stl
robot/v14_xc330/meshes/leg_l.stl
robot/v14_xc330/meshes/leg_r.stl
robot/v14_xc330/meshes/pelvis.stl
robot/v14_xc330/meshes/torso.stl
robot/v14_xl330/meshes/foot_l.stl
robot/v14_xl330/meshes/foot_r.stl
robot/v14_xl330/meshes/leg_l.stl
robot/v14_xl330/meshes/leg_r.stl
robot/v14_xl330/meshes/pelvis.stl
robot/v14_xl330/meshes/torso.stl
robot/v15_scs0009/meshes/foot_l.stl
robot/v15_scs0009/meshes/foot_r.stl
robot/v15_scs0009/meshes/leg_l.stl
robot/v15_scs0009/meshes/leg_r.stl
robot/v15_scs0009/meshes/pelvis.stl
robot/v15_scs0009/meshes/torso.stl
robot/v15_sts3032/meshes/foot_l.stl
robot/v15_sts3032/meshes/foot_r.stl
robot/v15_sts3032/meshes/leg_l.stl
robot/v15_sts3032/meshes/leg_r.stl
robot/v15_sts3032/meshes/pelvis.stl
robot/v15_sts3032/meshes/torso.stl
robot/v15_sts3032_w4/meshes/leg_l.stl
robot/v15_sts3032_w4/meshes/leg_r.stl
robot/v15_sts3032_w4/meshes/pelvis.stl
robot/v15_sts3032_w4/meshes/torso.stl
robot/v15_xc330/meshes/leg_l.stl
robot/v15_xc330/meshes/leg_r.stl
robot/v15_xc330/meshes/pelvis.stl
robot/v15_xc330/meshes/torso.stl
robot/v15_xl330/meshes/leg_l.stl
robot/v15_xl330/meshes/leg_r.stl
robot/v15_xl330/meshes/pelvis.stl
robot/v15_xl330/meshes/torso.stl
robot/v16_scs0009/meshes/foot_l.stl
robot/v16_scs0009/meshes/foot_r.stl
robot/v16_scs0009/meshes/leg_l.stl
robot/v16_scs0009/meshes/leg_r.stl
robot/v16_scs0009/meshes/pelvis.stl
robot/v16_scs0009/meshes/torso.stl
robot/v16_sts3032/meshes/foot_l.stl
robot/v16_sts3032/meshes/foot_r.stl
robot/v16_sts3032/meshes/leg_l.stl
robot/v16_sts3032/meshes/leg_r.stl
robot/v16_sts3032/meshes/pelvis.stl
robot/v16_sts3032/meshes/torso.stl
robot/v16_sts3032_w4/meshes/foot_l.stl
robot/v16_sts3032_w4/meshes/foot_r.stl
robot/v16_sts3032_w4/meshes/leg_l.stl
robot/v16_sts3032_w4/meshes/leg_r.stl
robot/v16_sts3032_w4/meshes/pelvis.stl
robot/v16_sts3032_w4/meshes/torso.stl
robot/v16_xc330/meshes/foot_l.stl
robot/v16_xc330/meshes/foot_r.stl
robot/v16_xc330/meshes/leg_l.stl
robot/v16_xc330/meshes/leg_r.stl
robot/v16_xc330/meshes/pelvis.stl
robot/v16_xc330/meshes/torso.stl
robot/v16_xl330/meshes/foot_l.stl
robot/v16_xl330/meshes/foot_r.stl
robot/v16_xl330/meshes/leg_l.stl
robot/v16_xl330/meshes/leg_r.stl
robot/v16_xl330/meshes/pelvis.stl
robot/v16_xl330/meshes/torso.stl
robot/v17_scs0009/meshes/leg_l.stl
robot/v17_scs0009/meshes/leg_r.stl
robot/v17_scs0009/meshes/pelvis.stl
robot/v17_scs0009/meshes/torso.stl
robot/v17_sts3032/meshes/foot_l.stl
robot/v17_sts3032/meshes/foot_r.stl
robot/v17_sts3032/meshes/leg_l.stl
robot/v17_sts3032/meshes/leg_r.stl
robot/v17_sts3032/meshes/pelvis.stl
robot/v17_sts3032/meshes/torso.stl
robot/v17_xc330/meshes/leg_l.stl
robot/v17_xc330/meshes/leg_r.stl
robot/v17_xc330/meshes/pelvis.stl
robot/v17_xc330/meshes/torso.stl
robot/v17_xl330/meshes/leg_l.stl
robot/v17_xl330/meshes/leg_r.stl
robot/v17_xl330/meshes/pelvis.stl
robot/v17_xl330/meshes/torso.stl
robot/v18_scs0009/meshes/leg_l.stl
robot/v18_scs0009/meshes/leg_r.stl
robot/v18_scs0009/meshes/pelvis.stl
robot/v18_scs0009/meshes/torso.stl
robot/v18_sts3032/meshes/foot_l.stl
robot/v18_sts3032/meshes/foot_r.stl
robot/v18_sts3032/meshes/leg_l.stl
robot/v18_sts3032/meshes/leg_r.stl
robot/v18_sts3032/meshes/pelvis.stl
robot/v18_sts3032/meshes/torso.stl
robot/v18_xc330/meshes/leg_l.stl
robot/v18_xc330/meshes/leg_r.stl
robot/v18_xc330/meshes/pelvis.stl
robot/v18_xc330/meshes/torso.stl
robot/v18_xl330/meshes/leg_l.stl
robot/v18_xl330/meshes/leg_r.stl
robot/v18_xl330/meshes/pelvis.stl
robot/v18_xl330/meshes/torso.stl
robot/v19_sts3032/meshes/leg_l.stl
robot/v19_sts3032/meshes/leg_r.stl
robot/v19_sts3032/meshes/pelvis.stl
robot/v1_700_exposed/meshes/leg_l.stl
robot/v1_700_exposed/meshes/leg_r.stl
robot/v1_700_exposed/meshes/pelvis.stl
robot/v1_700_exposed/meshes/torso.stl
robot/v20_sts3032/meshes/leg_l.stl
robot/v20_sts3032/meshes/leg_r.stl
robot/v20_sts3032/meshes/pelvis.stl
robot/v20_sts3032/meshes/torso.stl
robot/v20_xc330/meshes/leg_l.stl
robot/v20_xc330/meshes/leg_r.stl
robot/v20_xc330/meshes/pelvis.stl
robot/v20_xc330/meshes/torso.stl
robot/v21_sts3032/meshes/leg_l.stl
robot/v21_sts3032/meshes/leg_r.stl
robot/v21_sts3032/meshes/pelvis.stl
robot/v21_sts3032/meshes/torso.stl
robot/v2_500_exposed/meshes/leg_l.stl
robot/v2_500_exposed/meshes/leg_r.stl
robot/v2_500_exposed/meshes/pelvis.stl
robot/v2_500_exposed/meshes/torso.stl
robot/v4_ankle_in_foot/meshes/foot_l.stl
robot/v4_ankle_in_foot/meshes/foot_r.stl
robot/v4_ankle_in_foot/meshes/pelvis.stl
robot/v5_split_boxy/meshes/foot_l.stl
robot/v5_split_boxy/meshes/foot_r.stl
robot/v5_split_boxy/meshes/leg_l.stl
robot/v5_split_boxy/meshes/leg_r.stl
robot/v5_split_boxy/meshes/pelvis.stl
robot/v6_split_round/meshes/foot_l.stl
robot/v6_split_round/meshes/foot_r.stl
robot/v6_split_round/meshes/pelvis.stl
robot/v6_split_round/meshes/torso.stl
robot/v7_roll_only/meshes/foot_l.stl
robot/v7_roll_only/meshes/foot_r.stl
robot/v7_roll_only/meshes/leg_l.stl
robot/v7_roll_only/meshes/leg_r.stl
robot/v7_roll_only/meshes/pelvis.stl
robot/v7_roll_only/meshes/torso.stl
robot/v9_yaw_roll_display/meshes/foot_l.stl
robot/v9_yaw_roll_display/meshes/foot_r.stl
robot/v9_yaw_roll_display/meshes/leg_l.stl
robot/v9_yaw_roll_display/meshes/leg_r.stl
robot/v9_yaw_roll_display/meshes/pelvis.stl
robot/v9_yaw_roll_display/meshes/torso.stl
