yuuundj/Haetburi-practice/robot/v14_xc330_hidden/build_report.txt

variant  v14_xc330_hidden: XC330-T288, all motors inside (roll motor in the STL foot), 516 mm
wrote    robot/v14_xc330_hidden/haetburi.urdf, robot/v14_xc330_hidden/haetburi_scene.xml

link       mass kg  com (m, robot frame)
pelvis       0.361  [ 0.026  -0.0001  0.0802]
torso        2.177  [3.200e-02 1.000e-04 2.348e-01]
leg_l        0.027  [0.01   0.0244 0.0311]
foot_l       0.080  [0.0226 0.0246 0.01  ]
leg_r        0.027  [ 0.0101 -0.0247  0.0312]
foot_r       0.080  [ 0.0222 -0.0251  0.01  ]

total mass 2.751 kg   com [3.020e-02 1.000e-04 1.975e-01] m   com height 198 mm
standing height 525 mm, character scale x4.3000
actuated joints: 4 (hip yaw x2, ankle roll x2; the waist is fixed)
servo: XC330-T288-T: 20.0 x 34.0 x 26.0 mm, 23 g, stall 1.0 N.m
roll axis above sole (mm): 12.4 / 12.4 (left / right)
roll axis vs leg centre (mm): 11.7 ahead, 7.4 inboard
legs raised to clear the feet (mm): 9.5
character scale: x4.30 of the 120 mm STL (516 mm character; the walled roll motor fits the STL foot from x4.25)
foot (mm): 70.8 long x 47.7 wide x 34.3 high (the STL's own foot, flat sole 63 x 39)
roll motor: lying on its side in the foot, shaft fore-aft, long end outward
ankle gap, leg bottom to foot top (mm): 5.0
leg shell (mm): original, 12.3 from bottom to crotch
display: 217.2 x 146.9 x 11.9 mm, 0.714 kg, centre 95 mm ahead, 145 mm up, bottom edge 71 mm above the floor
motor volume inside the shell:
  pelvis#0   100.0 %
  pelvis#1   100.0 %
  foot_l#0   100.0 %
  foot_r#0   100.0 %
