yuuundj/Haetburi-practice/robot/v16_xm430/build_report.txt

variant  v16_xm430: XM430-W350 (12 V), ankle pitch + roll both in the STL foot, legs unchanged, 852 mm
wrote    robot/v16_xm430/haetburi.urdf, robot/v16_xm430/haetburi_scene.xml

link       mass kg  com (m, robot frame)
pelvis       0.746  [ 0.0149 -0.0002  0.1396]
torso        8.472  [3.660e-02 2.000e-04 4.153e-01]
leg_l        0.102  [0.0163 0.0403 0.0548]
ankle_l      0.154  [0.0389 0.043  0.0181]
foot_l       0.285  [0.0281 0.0432 0.021 ]
leg_r        0.103  [ 0.0165 -0.0408  0.055 ]
ankle_r      0.154  [ 0.0369 -0.0418  0.0181]
foot_r       0.285  [ 0.0273 -0.0436  0.0209]

total mass 10.300 kg   com [3.420e-02 2.000e-04 3.545e-01] m   com height 355 mm
standing height 871 mm, character scale x7.1000
actuated joints: 6 (hip yaw x2, ankle pitch x2, ankle roll x2; the waist is fixed)
servo: XM430-W350-T: 28.5 x 46.5 x 34.0 mm, 82 g, stall 4.1 N.m
roll axis above sole (mm): 14.2 / 14.2 (left / right)
roll axis vs leg centre (mm): -8.5 ahead, -1.7 inboard
legs raised to clear the feet (mm): 19.2
character scale: x7.10 of the 120 mm STL (852 mm character)
foot (mm): 116.9 long x 78.7 wide x 56.7 high (the STL's own foot, flat sole 104 x 65)
ankle motors: both inside the foot: roll standing, pitch lying with its long side to the toe, riding the roll output
pitch axis above sole (mm): 19.3, 22.6 ahead of the leg centre
ankle gap, leg bottom to foot top (mm): 11.8
leg shell (mm): original, 20.3 from bottom to crotch
display: 358.7 x 242.5 x 19.6 mm, 1.890 kg, centre 156 mm ahead, 246 mm up, bottom edge 125 mm above the floor
motor volume inside the shell:
  pelvis#0   100.0 %
  pelvis#1   100.0 %
  ankle_l#0  100.0 %
  foot_l#0   100.0 %
  ankle_r#0  100.0 %
  foot_r#0   100.0 %
