yuuundj/Haetburi-practice/robot/v15_scs0009/build_report.txt

variant  v15_scs0009: SCS0009, ankle pitch + roll stacked, all 6 motors inside, 432 mm
wrote    robot/v15_scs0009/haetburi.urdf, robot/v15_scs0009/haetburi_scene.xml

link       mass kg  com (m, robot frame)
pelvis       0.209  [-0.0006 -0.      0.1053]
torso        1.281  [2.69e-02 1.00e-04 2.19e-01]
leg_l        0.053  [0.0141 0.02   0.0505]
ankle_l      0.012  [0.0197 0.0175 0.0282]
foot_l       0.053  [0.019  0.0204 0.0069]
leg_r        0.053  [ 0.0141 -0.0202  0.0505]
ankle_r      0.012  [ 0.0197 -0.0178  0.0282]
foot_r       0.053  [ 0.019  -0.0207  0.0069]

total mass 1.723 kg   com [0.0222 0.     0.1794] m   com height 179 mm
standing height 463 mm, character scale x3.6000
actuated joints: 6 (hip yaw x2, ankle pitch x2, ankle roll x2; the waist is fixed)
servo: SCS0009: 12.1 x 23.2 x 25.25 mm, 13 g, stall 0.226 N.m
roll axis above sole (mm): 8.3 / 8.3 (left / right)
roll axis vs leg centre (mm): 10.0 ahead, 4.3 inboard
legs raised to clear the feet (mm): 31.0
character scale: x3.60 of the 120 mm STL (432 mm character)
foot (mm): 59.3 long x 39.9 wide x 28.7 high (the STL's own foot, flat sole 53 x 33)
ankle motors: roll lying in the foot (long end outward); pitch standing in the leg above it
pitch axis above sole (mm): 48.0, 11.9 ahead of the leg centre
leg (mm): the STL leg lengthened by its own section: 21 added, 26 from bottom to crotch; the added part reaches 10.8 further forward
ankle gap, leg bottom to foot top (mm): 11.8
display: 181.9 x 122.9 x 9.9 mm, 0.423 kg, centre 79 mm ahead, 143 mm up, bottom edge 82 mm above the floor
motor volume inside the shell:
  pelvis#0   100.0 %
  pelvis#1   100.0 %
  leg_l#0    100.0 %
  foot_l#0   100.0 %
  leg_r#0    100.0 %
  foot_r#0   100.0 %
