yuuundj/Haetburi-practice/robot/v16_xc330/build_report.txt

variant  v16_xc330: XC330-T288, ankle pitch + roll both in the STL foot, legs unchanged, 642 mm
wrote    robot/v16_xc330/haetburi.urdf, robot/v16_xc330/haetburi_scene.xml

link       mass kg  com (m, robot frame)
pelvis       0.370  [ 3.300e-03 -1.000e-04  1.172e-01]
torso        3.889  [3.37e-02 1.00e-04 3.04e-01]
leg_l        0.033  [0.0121 0.0303 0.044 ]
ankle_l      0.043  [0.0292 0.034  0.0138]
foot_l       0.119  [0.0212 0.0335 0.0142]
leg_r        0.033  [ 0.0123 -0.0306  0.0441]
ankle_r      0.043  [ 0.0293 -0.0352  0.0138]
foot_r       0.118  [ 0.0211 -0.0337  0.0142]

total mass 4.648 kg   com [3.030e-02 1.000e-04 2.653e-01] m   com height 265 mm
standing height 656 mm, character scale x5.3500
actuated joints: 6 (hip yaw x2, ankle pitch x2, ankle roll x2; the waist is fixed)
servo: XC330-T288-T: 20.0 x 34.0 x 26.0 mm, 23 g, stall 1.0 N.m
roll axis above sole (mm): 10.8 / 10.8 (left / right)
roll axis vs leg centre (mm): -7.7 ahead, -4.1 inboard
legs raised to clear the feet (mm): 14.4
character scale: x5.35 of the 120 mm STL (642 mm character)
foot (mm): 88.1 long x 59.3 wide x 42.7 high (the STL's own foot, flat sole 79 x 49)
ankle motors: both inside the foot: roll standing, pitch lying with its long side to the toe, riding the roll output
pitch axis above sole (mm): 14.7, 17.4 ahead of the leg centre
ankle gap, leg bottom to foot top (mm): 8.9
leg shell (mm): original, 15.3 from bottom to crotch
display: 270.3 x 182.7 x 14.8 mm, 1.073 kg, centre 118 mm ahead, 184 mm up, bottom edge 93 mm above the floor
motor volume inside the shell:
  pelvis#0   100.0 %
  pelvis#1   100.0 %
  ankle_l#0  100.0 %
  foot_l#0   100.0 %
  ankle_r#0  100.0 %
  foot_r#0   100.0 %
