yuuundj/Haetburi-practice/robot/v4_ankle_in_foot/build_report.txt

variant  v4_ankle_in_foot: both ankle motors inside a tall foot, all 7 motors hidden
wrote    robot/v4_ankle_in_foot/haetburi.urdf, robot/v4_ankle_in_foot/haetburi_scene.xml

link       mass kg  com (m, robot frame)
pelvis       0.306  [-0.0091  0.011   0.164 ]
torso        1.803  [-0.0152  0.0004  0.3304]
leg_l        0.042  [0.0007 0.024  0.126 ]
ankle_l      0.082  [0.0007 0.0239 0.072 ]
foot_l       0.236  [0.0007 0.0239 0.0434]
leg_r        0.042  [ 0.0008 -0.024   0.126 ]
ankle_r      0.082  [ 0.0007 -0.0239  0.072 ]
foot_r       0.236  [ 0.0007 -0.0239  0.0434]

total mass 2.831 kg   com [-0.0105  0.0015  0.2434] m   com height 243 mm
standing height 608 mm, character scale x1.6667
foot (mm): 103.1 x 43.0 x 119.6
pitch / roll axis above sole (mm): 38.2 / 68.2
ankle gap (mm): 3.4
motor volume inside the shell:
  pelvis#0   100.0 %
  pelvis#1   100.0 %
  torso#0    100.0 %
  ankle_l#0  100.0 %
  foot_l#0   100.0 %
  ankle_r#0  100.0 %
  foot_r#0   100.0 %
