yuuundj/Haetburi-practice/robot/v6_split_round/build_report.txt

variant  v6_split_round: roll motor in the leg, pitch motor in a round forward foot, shorts
wrote    robot/v6_split_round/haetburi.urdf, robot/v6_split_round/haetburi_scene.xml

link       mass kg  com (m, robot frame)
pelvis       0.623  [0.0084 0.0054 0.1709]
torso        1.503  [-0.0073  0.0005  0.3595]
leg_l        0.105  [0.0008 0.0246 0.1166]
ankle_l      0.050  [0.0007 0.0246 0.0614]
foot_l       0.191  [0.0131 0.0246 0.027 ]
leg_r        0.105  [ 0.0007 -0.0246  0.1166]
ankle_r      0.050  [ 0.0007 -0.0246  0.0614]
foot_r       0.191  [ 0.0131 -0.0246  0.027 ]

total mass 2.818 kg   com [-2.000e-04  1.500e-03  2.441e-01] m   com height 244 mm
standing height 614 mm, character scale x1.6667
foot (mm): 108.1 x 45.0 x 81.5
leg section (mm): 37.0 wide x 46.0 deep
leg length, crotch to bottom (mm): 56.8
pitch / roll axis above sole (mm): 17.2 / 105.5
ankle gap (mm): 10.2
motor volume inside the shell:
  pelvis#0   100.0 %
  pelvis#1   100.0 %
  torso#0    100.0 %
  leg_l#0    100.0 %
  foot_l#0   100.0 %
  leg_r#0    100.0 %
  foot_r#0   100.0 %
