yuuundj/Haetburi-practice/robot/v11_newbase_display/haetburi.urdf

<?xml version="1.0"?>
<!-- Haetburi biped (v11_newbase_display) - generated by tools/build_model.py, do not edit by hand -->
<robot name="haetburi">
  <mujoco>
    <compiler meshdir="." balanceinertia="true" discardvisual="false" strippath="false" fusestatic="false"/>
  </mujoco>
  <material name="display"><color rgba="0.18 0.19 0.21 1"/></material>
  <material name="screen"><color rgba="0.62 0.80 0.95 1"/></material>
  <material name="shell"><color rgba="0.106 0.216 0.541 1"/></material>
  <material name="motor"><color rgba="0.15 0.15 0.17 1"/></material>
  <material name="foot"><color rgba="0.25 0.25 0.28 1"/></material>
  <link name="world"/>
  <joint name="floating_base" type="floating">
    <parent link="world"/><child link="pelvis"/>
    <origin xyz="0 0 0" rpy="0 0 0"/>
  </joint>
  <link name="pelvis">
    <inertial>
      <origin xyz="0.0175474 -7.32402e-05 0.0167" rpy="0 0 0"/>
      <mass value="0.536641"/>
      <inertia ixx="0.000314489" ixy="-1.02048e-06" ixz="-1.2315e-05" iyy="0.000345732" iyz="8.43513e-08" izz="0.000590502"/>
    </inertial>
    <visual><origin xyz="0 0 0" rpy="0 0 0"/><geometry><mesh filename="meshes/pelvis.stl"/></geometry><material name="shell"/></visual>
    <visual><origin xyz="-0.0119963 0.0340197 0.0195" rpy="0 0 0"/><geometry><box size="0.0465 0.0285 0.034"/></geometry><material name="motor"/></visual>
    <visual><origin xyz="-0.0120037 -0.0344395 0.0195" rpy="0 0 0"/><geometry><box size="0.0465 0.0285 0.034"/></geometry><material name="motor"/></visual>
    <collision><origin xyz="0.00914942 -0.000261546 0.018445" rpy="0 0 0"/><geometry><box size="0.100985 0.143996 0.03689"/></geometry></collision>
  </link>
  <link name="torso">
    <inertial>
      <origin xyz="0.0119712 0.000196608 0.234971" rpy="0 0 0"/>
      <mass value="3.45527"/>
      <inertia ixx="0.102355" ixy="-0.000387687" ixz="0.0114402" iyy="0.106829" iyz="-0.000340856" izz="0.0542465"/>
    </inertial>
    <visual><origin xyz="0 0 0" rpy="0 0 0"/><geometry><mesh filename="meshes/torso.stl"/></geometry><material name="shell"/></visual>
    <visual><origin xyz="-0.012 0 0.0175" rpy="0 0 0"/><geometry><box size="0.0465 0.0285 0.034"/></geometry><material name="motor"/></visual>
    <visual><origin xyz="0.116743 0 0.122317" rpy="0 0 0"/><geometry><box size="0.0115 0.2105 0.1423"/></geometry><material name="display"/></visual>
    <visual><origin xyz="0.122493 0 0.122317" rpy="0 0 0"/><geometry><box size="0.0004 0.192 0.12"/></geometry><material name="screen"/></visual>
    <collision><origin xyz="-0.0202093 -1.69977e-06 0.0756888" rpy="0 0 0"/><geometry><box size="0.32241 0.172541 0.169892"/></geometry></collision>
    <collision><origin xyz="0.0661878 0.111106 0.11628" rpy="0 0 0"/><geometry><sphere radius="0.0879747"/></geometry></collision>
    <collision><origin xyz="0.0666454 -0.111311 0.116106" rpy="0 0 0"/><geometry><sphere radius="0.0878001"/></geometry></collision>
    <collision><origin xyz="-0.00830768 0.000424862 0.198833" rpy="0 0 0"/><geometry><sphere radius="0.165795"/></geometry></collision>
    <collision><origin xyz="-0.0144764 -0.00019533 0.275177" rpy="0 0 0"/><geometry><sphere radius="0.191278"/></geometry></collision>
    <collision><origin xyz="-0.0220435 -0.000322386 0.351535" rpy="0 0 0"/><geometry><sphere radius="0.189062"/></geometry></collision>
    <collision><origin xyz="-0.0172931 0.00136186 0.427888" rpy="0 0 0"/><geometry><sphere radius="0.164397"/></geometry></collision>
    <collision><origin xyz="-0.0102328 0.0107795 0.504289" rpy="0 0 0"/><geometry><sphere radius="0.117177"/></geometry></collision>
    <collision><origin xyz="-0.0187531 -0.00356288 0.580622" rpy="0 0 0"/><geometry><sphere radius="0.0680012"/></geometry></collision>
    <collision><origin xyz="0.116743 0 0.122317" rpy="0 0 0"/><geometry><box size="0.0115 0.2105 0.1423"/></geometry></collision>
  </link>
  <link name="leg_l">
    <inertial>
      <origin xyz="-0.000470057 -0.000169539 -0.0296694" rpy="0 0 0"/>
      <mass value="0.0625673"/>
      <inertia ixx="2.59686e-05" ixy="-2.31484e-08" ixz="5.07106e-07" iyy="2.21211e-05" iyz="2.27217e-07" izz="2.01825e-05"/>
    </inertial>
    <visual><origin xyz="0 0 0" rpy="0 0 0"/><geometry><mesh filename="meshes/leg_l.stl"/></geometry><material name="shell"/></visual>
    <collision><origin xyz="-7.8706e-07 -1.08503e-05 -0.00849725" rpy="0 0 0"/><geometry><box size="0.0648948 0.0594546 0.0169945"/></geometry></collision>
  </link>
  <link name="foot_l">
    <inertial>
      <origin xyz="0.0012255 0.0107441 -0.00186089" rpy="0 0 0"/>
      <mass value="0.149794"/>
      <inertia ixx="7.17079e-05" ixy="-3.21363e-06" ixz="-6.7791e-07" iyy="9.76424e-05" iyz="-2.83098e-06" izz="0.000118926"/>
    </inertial>
    <visual><origin xyz="0 0 0" rpy="0 0 0"/><geometry><mesh filename="meshes/foot_l.stl"/></geometry><material name="shell"/></visual>
    <visual><origin xyz="0 0.012 7.34788e-19" rpy="0 0 0"/><geometry><box size="0.034 0.0465 0.0285"/></geometry><material name="motor"/></visual>
    <collision><origin xyz="0 0 0" rpy="0 0 0"/><geometry><mesh filename="meshes/foot_l.stl"/></geometry></collision>
  </link>
  <link name="leg_r">
    <inertial>
      <origin xyz="-0.000351561 0.000195358 -0.0295195" rpy="0 0 0"/>
      <mass value="0.0627758"/>
      <inertia ixx="2.62581e-05" ixy="-9.16334e-08" ixz="3.9612e-07" iyy="2.21735e-05" iyz="-2.61945e-07" izz="2.03678e-05"/>
    </inertial>
    <visual><origin xyz="0 0 0" rpy="0 0 0"/><geometry><mesh filename="meshes/leg_r.stl"/></geometry><material name="shell"/></visual>
    <collision><origin xyz="1.87959e-06 1.72012e-05 -0.00838829" rpy="0 0 0"/><geometry><box size="0.0648423 0.0595689 0.0167766"/></geometry></collision>
  </link>
  <link name="foot_r">
    <inertial>
      <origin xyz="0.00229683 -0.0109198 -0.00191251" rpy="0 0 0"/>
      <mass value="0.149486"/>
      <inertia ixx="7.13723e-05" ixy="3.63287e-06" ixz="-7.75189e-07" iyy="9.77393e-05" iyz="2.88465e-06" izz="0.000119138"/>
    </inertial>
    <visual><origin xyz="0 0 0" rpy="0 0 0"/><geometry><mesh filename="meshes/foot_r.stl"/></geometry><material name="shell"/></visual>
    <visual><origin xyz="0 -0.012 7.34788e-19" rpy="0 0 0"/><geometry><box size="0.034 0.0465 0.0285"/></geometry><material name="motor"/></visual>
    <collision><origin xyz="0 0 0" rpy="0 0 0"/><geometry><mesh filename="meshes/foot_r.stl"/></geometry></collision>
  </link>
  <joint name="waist_yaw" type="revolute">
    <parent link="pelvis"/><child link="torso"/>
    <origin xyz="0 0 0.03689" rpy="0 0 0"/>
    <axis xyz="0 0 1"/>
    <limit lower="-1.0472" upper="1.0472" effort="1.4" velocity="5.97"/>
    <dynamics damping="0.1" friction="0.04"/>
  </joint>
  <joint name="hip_yaw_l" type="revolute">
    <parent link="pelvis"/><child link="leg_l"/>
    <origin xyz="3.66423e-06 0.0340197 0" rpy="0 0 0"/>
    <axis xyz="0 0 1"/>
    <limit lower="-0.523599" upper="0.523599" effort="1.4" velocity="5.97"/>
    <dynamics damping="0.1" friction="0.04"/>
  </joint>
  <joint name="hip_yaw_r" type="revolute">
    <parent link="pelvis"/><child link="leg_r"/>
    <origin xyz="-3.66423e-06 -0.0344395 0" rpy="0 0 0"/>
    <axis xyz="0 0 1"/>
    <limit lower="-0.523599" upper="0.523599" effort="1.4" velocity="5.97"/>
    <dynamics damping="0.1" friction="0.04"/>
  </joint>
  <joint name="ankle_roll_l" type="revolute">
    <parent link="leg_l"/><child link="foot_l"/>
    <origin xyz="0.0152101 -0.00934904 -0.0537575" rpy="0 0 0"/>
    <axis xyz="1 0 0"/>
    <limit lower="-0.261799" upper="0.261799" effort="1.4" velocity="5.97"/>
    <dynamics damping="0.1" friction="0.04"/>
  </joint>
  <joint name="ankle_roll_r" type="revolute">
    <parent link="leg_r"/><child link="foot_r"/>
    <origin xyz="0.0129966 0.0096597 -0.0537575" rpy="0 0 0"/>
    <axis xyz="1 0 0"/>
    <limit lower="-0.261799" upper="0.261799" effort="1.4" velocity="5.97"/>
    <dynamics damping="0.1" friction="0.04"/>
  </joint>
</robot>
