yuuundj/Haetburi-practice/robot/v12_slipper_display/haetburi.urdf

<?xml version="1.0"?>
<!-- Haetburi biped (v12_slipper_display) - generated by tools/build_model.py, do not edit by hand -->
<robot name="haetburi">
  <mujoco>
    <compiler meshdir="." balanceinertia="true" discardvisual="false" strippath="false" fusestatic="false"/>
  </mujoco>
  <material name="display"><color rgba="0.18 0.19 0.21 1"/></material>
  <material name="screen"><color rgba="0.62 0.80 0.95 1"/></material>
  <material name="shell"><color rgba="0.106 0.216 0.541 1"/></material>
  <material name="motor"><color rgba="0.15 0.15 0.17 1"/></material>
  <material name="foot"><color rgba="0.25 0.25 0.28 1"/></material>
  <link name="world"/>
  <joint name="floating_base" type="floating">
    <parent link="world"/><child link="pelvis"/>
    <origin xyz="0 0 0" rpy="0 0 0"/>
  </joint>
  <link name="pelvis">
    <inertial>
      <origin xyz="0.015438 -4.94845e-05 0.0270987" rpy="0 0 0"/>
      <mass value="0.537445"/>
      <inertia ixx="0.00022952" ixy="-2.25154e-07" ixz="-2.75386e-05" iyy="0.000176351" iyz="4.86873e-08" izz="0.000268178"/>
    </inertial>
    <visual><origin xyz="0 0 0" rpy="0 0 0"/><geometry><mesh filename="meshes/pelvis.stl"/></geometry><material name="shell"/></visual>
    <visual><origin xyz="0.0120026 0.0238233 0.032" rpy="0 0 0"/><geometry><box size="0.0465 0.0285 0.034"/></geometry><material name="motor"/></visual>
    <visual><origin xyz="0.0119974 -0.0241173 0.032" rpy="0 0 0"/><geometry><box size="0.0465 0.0285 0.034"/></geometry><material name="motor"/></visual>
    <collision><origin xyz="0.00726628 -0.000142355 0.0254167" rpy="0 0 0"/><geometry><box size="0.0871192 0.115689 0.0508333"/></geometry></collision>
  </link>
  <link name="torso">
    <inertial>
      <origin xyz="0.0198038 9.70446e-05 0.122089" rpy="0 0 0"/>
      <mass value="2.06339"/>
      <inertia ixx="0.0316271" ixy="-8.99459e-05" ixz="0.0052462" iyy="0.0318877" iyz="-8.72193e-05" izz="0.0168966"/>
    </inertial>
    <visual><origin xyz="0 0 0" rpy="0 0 0"/><geometry><mesh filename="meshes/torso.stl"/></geometry><material name="shell"/></visual>
    <visual><origin xyz="-0.012 0 0.0175" rpy="0 0 0"/><geometry><box size="0.0465 0.0285 0.034"/></geometry><material name="motor"/></visual>
    <visual><origin xyz="0.0817526 0 0.0394059" rpy="0 0 0"/><geometry><box size="0.0115 0.2105 0.1423"/></geometry><material name="display"/></visual>
    <visual><origin xyz="0.0875026 0 0.0394059" rpy="0 0 0"/><geometry><box size="0.0004 0.192 0.12"/></geometry><material name="screen"/></visual>
    <collision><origin xyz="-0.0379573 -1.76698e-06 0.0280034" rpy="0 0 0"/><geometry><box size="0.178167 0.12081 0.118972"/></geometry></collision>
    <collision><origin xyz="0.04635 0.0935783 0.0564289" rpy="0 0 0"/><geometry><sphere radius="0.0676906"/></geometry></collision>
    <collision><origin xyz="0.0466704 -0.0937217 0.0564289" rpy="0 0 0"/><geometry><sphere radius="0.0676255"/></geometry></collision>
    <collision><origin xyz="-0.00581771 0.000297523 0.114239" rpy="0 0 0"/><geometry><sphere radius="0.116103"/></geometry></collision>
    <collision><origin xyz="-0.0101376 -0.000136786 0.167701" rpy="0 0 0"/><geometry><sphere radius="0.133948"/></geometry></collision>
    <collision><origin xyz="-0.0154366 -0.00022576 0.221173" rpy="0 0 0"/><geometry><sphere radius="0.132396"/></geometry></collision>
    <collision><origin xyz="-0.01211 0.000953686 0.274642" rpy="0 0 0"/><geometry><sphere radius="0.115124"/></geometry></collision>
    <collision><origin xyz="-0.00716584 0.00754869 0.328144" rpy="0 0 0"/><geometry><sphere radius="0.0820566"/></geometry></collision>
    <collision><origin xyz="-0.0131324 -0.00249501 0.381598" rpy="0 0 0"/><geometry><sphere radius="0.0476199"/></geometry></collision>
    <collision><origin xyz="0.0817526 0 0.0394059" rpy="0 0 0"/><geometry><box size="0.0115 0.2105 0.1423"/></geometry></collision>
  </link>
  <link name="leg_l">
    <inertial>
      <origin xyz="-0.000526044 0.000120221 -0.0272381" rpy="0 0 0"/>
      <mass value="0.0599756"/>
      <inertia ixx="2.07265e-05" ixy="-2.00815e-08" ixz="5.60358e-07" iyy="1.61874e-05" iyz="-1.07437e-07" izz="1.15679e-05"/>
    </inertial>
    <visual><origin xyz="0 0 0" rpy="0 0 0"/><geometry><mesh filename="meshes/leg_l.stl"/></geometry><material name="shell"/></visual>
    <visual><origin xyz="-0.0230197 -0.00607258 -0.0363125" rpy="0 0 0"/><geometry><box size="0.003 0.03 0.052625"/></geometry><material name="foot"/></visual>
    <visual><origin xyz="-0.00726969 -0.00607258 -0.0115" rpy="0 0 0"/><geometry><box size="0.0345 0.03 0.003"/></geometry><material name="foot"/></visual>
    <collision><origin xyz="-5.51163e-07 -7.59827e-06 -0.005" rpy="0 0 0"/><geometry><box size="0.0454446 0.0416349 0.01"/></geometry></collision>
  </link>
  <link name="foot_l">
    <inertial>
      <origin xyz="0.00704868 0.00210881 0.00783148" rpy="0 0 0"/>
      <mass value="0.0760105"/>
      <inertia ixx="2.39811e-05" ixy="-3.63992e-06" ixz="5.55134e-06" iyy="3.80909e-05" iyz="1.96859e-06" izz="2.96862e-05"/>
    </inertial>
    <visual><origin xyz="0 0 0" rpy="0 0 0"/><geometry><mesh filename="meshes/foot_l.stl"/></geometry><material name="shell"/></visual>
    <visual><origin xyz="-0 0 0.012" rpy="0 0 0"/><geometry><box size="0.034 0.0285 0.0465"/></geometry><material name="motor"/></visual>
    <collision><origin xyz="0 0 0" rpy="0 0 0"/><geometry><mesh filename="meshes/foot_l.stl"/></geometry></collision>
    <collision><origin xyz="-0 0 0.012" rpy="0 0 0"/><geometry><box size="0.034 0.0285 0.0465"/></geometry></collision>
  </link>
  <link name="leg_r">
    <inertial>
      <origin xyz="-0.000151712 6.07334e-05 -0.0266789" rpy="0 0 0"/>
      <mass value="0.0619754"/>
      <inertia ixx="2.15883e-05" ixy="-1.94399e-07" ixz="1.72919e-07" iyy="1.68213e-05" iyz="-8.16914e-08" izz="1.19002e-05"/>
    </inertial>
    <visual><origin xyz="0 0 0" rpy="0 0 0"/><geometry><mesh filename="meshes/leg_r.stl"/></geometry><material name="shell"/></visual>
    <visual><origin xyz="-0.0230146 0.00607651 -0.0363125" rpy="0 0 0"/><geometry><box size="0.003 0.03 0.052625"/></geometry><material name="foot"/></visual>
    <visual><origin xyz="-0.00726456 0.00607651 -0.0115" rpy="0 0 0"/><geometry><box size="0.0345 0.03 0.003"/></geometry><material name="foot"/></visual>
    <collision><origin xyz="1.31624e-06 1.20456e-05 -0.005" rpy="0 0 0"/><geometry><box size="0.0454078 0.0417149 0.01"/></geometry></collision>
  </link>
  <link name="foot_r">
    <inertial>
      <origin xyz="0.0070079 -0.00211247 0.00783321" rpy="0 0 0"/>
      <mass value="0.0759422"/>
      <inertia ixx="2.39803e-05" ixy="3.63669e-06" ixz="5.53844e-06" iyy="3.79437e-05" iyz="-1.98131e-06" izz="2.95458e-05"/>
    </inertial>
    <visual><origin xyz="0 0 0" rpy="0 0 0"/><geometry><mesh filename="meshes/foot_r.stl"/></geometry><material name="shell"/></visual>
    <visual><origin xyz="-0 0 0.012" rpy="0 0 0"/><geometry><box size="0.034 0.0285 0.0465"/></geometry><material name="motor"/></visual>
    <collision><origin xyz="0 0 0" rpy="0 0 0"/><geometry><mesh filename="meshes/foot_r.stl"/></geometry></collision>
    <collision><origin xyz="-0 0 0.012" rpy="0 0 0"/><geometry><box size="0.034 0.0285 0.0465"/></geometry></collision>
  </link>
  <joint name="waist_yaw" type="revolute">
    <parent link="pelvis"/><child link="torso"/>
    <origin xyz="0 0 0.0508333" rpy="0 0 0"/>
    <axis xyz="0 0 1"/>
    <limit lower="-1.0472" upper="1.0472" effort="1.4" velocity="5.97"/>
    <dynamics damping="0.1" friction="0.04"/>
  </joint>
  <joint name="hip_yaw_l" type="revolute">
    <parent link="pelvis"/><child link="leg_l"/>
    <origin xyz="2.56599e-06 0.0238233 0" rpy="0 0 0"/>
    <axis xyz="0 0 1"/>
    <limit lower="-0.523599" upper="0.523599" effort="1.4" velocity="5.97"/>
    <dynamics damping="0.1" friction="0.04"/>
  </joint>
  <joint name="hip_yaw_r" type="revolute">
    <parent link="pelvis"/><child link="leg_r"/>
    <origin xyz="-2.56599e-06 -0.0241173 0" rpy="0 0 0"/>
    <axis xyz="0 0 1"/>
    <limit lower="-0.523599" upper="0.523599" effort="1.4" velocity="5.97"/>
    <dynamics damping="0.1" friction="0.04"/>
  </joint>
  <joint name="ankle_roll_l" type="revolute">
    <parent link="leg_l"/><child link="foot_l"/>
    <origin xyz="-0.00201969 -0.00607258 -0.052625" rpy="0 0 0"/>
    <axis xyz="1 0 0"/>
    <limit lower="-0.261799" upper="0.261799" effort="1.4" velocity="5.97"/>
    <dynamics damping="0.1" friction="0.04"/>
  </joint>
  <joint name="ankle_roll_r" type="revolute">
    <parent link="leg_r"/><child link="foot_r"/>
    <origin xyz="-0.00201456 0.00607651 -0.052625" rpy="0 0 0"/>
    <axis xyz="1 0 0"/>
    <limit lower="-0.261799" upper="0.261799" effort="1.4" velocity="5.97"/>
    <dynamics damping="0.1" friction="0.04"/>
  </joint>
</robot>
