yuuundj/Haetburi-practice/robot/v14_scs0009_hidden/haetburi.urdf

<?xml version="1.0"?>
<!-- Haetburi biped (v14_scs0009_hidden) - generated by tools/build_model.py, do not edit by hand -->
<robot name="haetburi">
  <mujoco>
    <compiler meshdir="." balanceinertia="true" discardvisual="false" strippath="false" fusestatic="false"/>
  </mujoco>
  <material name="display"><color rgba="0.18 0.19 0.21 1"/></material>
  <material name="screen"><color rgba="0.62 0.80 0.95 1"/></material>
  <material name="shell"><color rgba="0.106 0.216 0.541 1"/></material>
  <material name="motor"><color rgba="0.15 0.15 0.17 1"/></material>
  <material name="foot"><color rgba="0.25 0.25 0.28 1"/></material>
  <link name="world"/>
  <joint name="floating_base" type="floating">
    <parent link="world"/><child link="pelvis"/>
    <origin xyz="0 0 0" rpy="0 0 0"/>
  </joint>
  <link name="pelvis">
    <inertial>
      <origin xyz="0.0097263 -4.87134e-05 0.0205655" rpy="0 0 0"/>
      <mass value="0.131027"/>
      <inertia ixx="4.38717e-05" ixy="-4.88381e-08" ixz="-3.58043e-06" iyy="3.22931e-05" iyz="3.92503e-09" izz="5.35545e-05"/>
    </inertial>
    <visual><origin xyz="0 0 0" rpy="0 0 0"/><geometry><mesh filename="meshes/pelvis.stl"/></geometry><material name="shell"/></visual>
    <visual><origin xyz="0.00560197 0.0182963 0.024625" rpy="0 0 0"/><geometry><box size="0.0232 0.0121 0.02525"/></geometry><material name="motor"/></visual>
    <visual><origin xyz="0.00559803 -0.0185221 0.024625" rpy="0 0 0"/><geometry><box size="0.0232 0.0121 0.02525"/></geometry><material name="motor"/></visual>
    <collision><origin xyz="0.0055805 -0.000109329 0.01952" rpy="0 0 0"/><geometry><box size="0.0669075 0.0888493 0.03904"/></geometry></collision>
  </link>
  <link name="torso">
    <inertial>
      <origin xyz="0.016319 7.72691e-05 0.0965368" rpy="0 0 0"/>
      <mass value="0.901556"/>
      <inertia ixx="0.00825268" ixy="-2.39546e-05" ixz="0.00150206" iyy="0.00830177" iyz="-2.31102e-05" izz="0.00450974"/>
    </inertial>
    <visual><origin xyz="0 0 0" rpy="0 0 0"/><geometry><mesh filename="meshes/torso.stl"/></geometry><material name="shell"/></visual>
    <visual><origin xyz="0.062786 0 0.0289837" rpy="0 0 0"/><geometry><box size="0.008832 0.161664 0.109286"/></geometry><material name="display"/></visual>
    <visual><origin xyz="0.067202 0 0.0289837" rpy="0 0 0"/><geometry><box size="0.0004 0.147456 0.09216"/></geometry><material name="screen"/></visual>
    <collision><origin xyz="-0.0291512 -1.35704e-06 0.0215066" rpy="0 0 0"/><geometry><box size="0.136832 0.0927821 0.0913706"/></geometry></collision>
    <collision><origin xyz="0.0355968 0.0718681 0.0433374" rpy="0 0 0"/><geometry><sphere radius="0.0519864"/></geometry></collision>
    <collision><origin xyz="0.0358429 -0.0719783 0.0433374" rpy="0 0 0"/><geometry><sphere radius="0.0519364"/></geometry></collision>
    <collision><origin xyz="-0.004468 0.000228497 0.0877353" rpy="0 0 0"/><geometry><sphere radius="0.0891668"/></geometry></collision>
    <collision><origin xyz="-0.00778564 -0.000105052 0.128794" rpy="0 0 0"/><geometry><sphere radius="0.102872"/></geometry></collision>
    <collision><origin xyz="-0.0118553 -0.000173384 0.169861" rpy="0 0 0"/><geometry><sphere radius="0.101681"/></geometry></collision>
    <collision><origin xyz="-0.00930047 0.000732431 0.210925" rpy="0 0 0"/><geometry><sphere radius="0.088415"/></geometry></collision>
    <collision><origin xyz="-0.00550337 0.0057974 0.252014" rpy="0 0 0"/><geometry><sphere radius="0.0630195"/></geometry></collision>
    <collision><origin xyz="-0.0100857 -0.00191617 0.293068" rpy="0 0 0"/><geometry><sphere radius="0.0365721"/></geometry></collision>
    <collision><origin xyz="0.062786 0 0.0289837" rpy="0 0 0"/><geometry><box size="0.008832 0.161664 0.109286"/></geometry></collision>
  </link>
  <link name="leg_l">
    <inertial>
      <origin xyz="-0.000245192 -8.84352e-05 -0.0166362" rpy="0 0 0"/>
      <mass value="0.0143302"/>
      <inertia ixx="2.90545e-06" ixy="-1.497e-09" ixz="3.49708e-08" iyy="1.82568e-06" iyz="1.54605e-08" izz="2.68445e-06"/>
    </inertial>
    <visual><origin xyz="0 0 0" rpy="0 0 0"/><geometry><mesh filename="meshes/leg_l.stl"/></geometry><material name="shell"/></visual>
    <collision><origin xyz="-4.23293e-07 -5.83547e-06 -0.00456995" rpy="0 0 0"/><geometry><box size="0.0349014 0.0319756 0.0091399"/></geometry></collision>
  </link>
  <link name="foot_l">
    <inertial>
      <origin xyz="0.000411766 0.00389255 -0.00232073" rpy="0 0 0"/>
      <mass value="0.0454368"/>
      <inertia ixx="5.1883e-06" ixy="-2.3182e-07" ixz="-8.67415e-08" iyy="7.0546e-06" iyz="-5.18059e-07" izz="8.13425e-06"/>
    </inertial>
    <visual><origin xyz="0 0 0" rpy="0 0 0"/><geometry><mesh filename="meshes/foot_l.stl"/></geometry><material name="shell"/></visual>
    <visual><origin xyz="0 0.0056 3.42901e-19" rpy="0 0 0"/><geometry><box size="0.02525 0.0232 0.0121"/></geometry><material name="motor"/></visual>
    <collision><origin xyz="0 0 0" rpy="0 0 0"/><geometry><mesh filename="meshes/foot_l.stl"/></geometry></collision>
  </link>
  <link name="leg_r">
    <inertial>
      <origin xyz="-0.000183401 0.000101913 -0.016554" rpy="0 0 0"/>
      <mass value="0.0143765"/>
      <inertia ixx="2.92499e-06" ixy="-5.8794e-09" ixz="2.72396e-08" iyy="1.82997e-06" iyz="-1.78241e-08" izz="2.69635e-06"/>
    </inertial>
    <visual><origin xyz="0 0 0" rpy="0 0 0"/><geometry><mesh filename="meshes/leg_r.stl"/></geometry><material name="shell"/></visual>
    <collision><origin xyz="1.01087e-06 9.25105e-06 -0.00451135" rpy="0 0 0"/><geometry><box size="0.0348732 0.0320371 0.0090227"/></geometry></collision>
  </link>
  <link name="foot_r">
    <inertial>
      <origin xyz="0.000349027 -0.0038772 -0.00234477" rpy="0 0 0"/>
      <mass value="0.0453682"/>
      <inertia ixx="5.15499e-06" ixy="2.36972e-07" ixz="-6.72789e-08" iyy="7.01847e-06" iyz="5.15277e-07" izz="8.10368e-06"/>
    </inertial>
    <visual><origin xyz="0 0 0" rpy="0 0 0"/><geometry><mesh filename="meshes/foot_r.stl"/></geometry><material name="shell"/></visual>
    <visual><origin xyz="0 -0.0056 3.42901e-19" rpy="0 0 0"/><geometry><box size="0.02525 0.0232 0.0121"/></geometry><material name="motor"/></visual>
    <collision><origin xyz="0 0 0" rpy="0 0 0"/><geometry><mesh filename="meshes/foot_r.stl"/></geometry></collision>
  </link>
  <joint name="waist_fixed" type="fixed">
    <parent link="pelvis"/><child link="torso"/>
    <origin xyz="0 0 0.03904" rpy="0 0 0"/>
  </joint>
  <joint name="hip_yaw_l" type="revolute">
    <parent link="pelvis"/><child link="leg_l"/>
    <origin xyz="1.97068e-06 0.0182963 0" rpy="0 0 0"/>
    <axis xyz="0 0 1"/>
    <limit lower="-0.523599" upper="0.523599" effort="0.226" velocity="10.5"/>
    <dynamics damping="0.016142857142857146" friction="0.006457142857142858"/>
  </joint>
  <joint name="hip_yaw_r" type="revolute">
    <parent link="pelvis"/><child link="leg_r"/>
    <origin xyz="-1.97068e-06 -0.0185221 0" rpy="0 0 0"/>
    <axis xyz="0 0 1"/>
    <limit lower="-0.523599" upper="0.523599" effort="0.226" velocity="10.5"/>
    <dynamics damping="0.016142857142857146" friction="0.006457142857142858"/>
  </joint>
  <joint name="ankle_roll_l" type="revolute">
    <parent link="leg_l"/><child link="foot_l"/>
    <origin xyz="0.00836715 -0.00460301 -0.03037" rpy="0 0 0"/>
    <axis xyz="1 0 0"/>
    <limit lower="-0.261799" upper="0.261799" effort="0.226" velocity="10.5"/>
    <dynamics damping="0.016142857142857146" friction="0.006457142857142858"/>
  </joint>
  <joint name="ankle_roll_r" type="revolute">
    <parent link="leg_r"/><child link="foot_r"/>
    <origin xyz="0.00845671 0.00455261 -0.03037" rpy="0 0 0"/>
    <axis xyz="1 0 0"/>
    <limit lower="-0.261799" upper="0.261799" effort="0.226" velocity="10.5"/>
    <dynamics damping="0.016142857142857146" friction="0.006457142857142858"/>
  </joint>
</robot>
