yuuundj/Haetburi-practice/robot/v14_sts3032_hidden/haetburi.urdf

<?xml version="1.0"?>
<!-- Haetburi biped (v14_sts3032_hidden) - generated by tools/build_model.py, do not edit by hand -->
<robot name="haetburi">
  <mujoco>
    <compiler meshdir="." balanceinertia="true" discardvisual="false" strippath="false" fusestatic="false"/>
  </mujoco>
  <material name="display"><color rgba="0.18 0.19 0.21 1"/></material>
  <material name="screen"><color rgba="0.62 0.80 0.95 1"/></material>
  <material name="shell"><color rgba="0.106 0.216 0.541 1"/></material>
  <material name="motor"><color rgba="0.15 0.15 0.17 1"/></material>
  <material name="foot"><color rgba="0.25 0.25 0.28 1"/></material>
  <link name="world"/>
  <joint name="floating_base" type="floating">
    <parent link="world"/><child link="pelvis"/>
    <origin xyz="0 0 0" rpy="0 0 0"/>
  </joint>
  <link name="pelvis">
    <inertial>
      <origin xyz="0.0100246 -4.65759e-05 0.0209075" rpy="0 0 0"/>
      <mass value="0.200802"/>
      <inertia ixx="6.22769e-05" ixy="-6.67885e-08" ixz="-5.87167e-06" iyy="4.57148e-05" iyz="1.88518e-08" izz="6.99462e-05"/>
    </inertial>
    <visual><origin xyz="0 0 0" rpy="0 0 0"/><geometry><mesh filename="meshes/pelvis.stl"/></geometry><material name="shell"/></visual>
    <visual><origin xyz="0.005502 0.0185822 0.02575" rpy="0 0 0"/><geometry><box size="0.023 0.012 0.0275"/></geometry><material name="motor"/></visual>
    <visual><origin xyz="0.005498 -0.0188115 0.02575" rpy="0 0 0"/><geometry><box size="0.023 0.012 0.0275"/></geometry><material name="motor"/></visual>
    <collision><origin xyz="0.0056677 -0.000111037 0.019825" rpy="0 0 0"/><geometry><box size="0.067953 0.0902375 0.03965"/></geometry></collision>
  </link>
  <link name="torso">
    <inertial>
      <origin xyz="0.0165597 7.85001e-05 0.0981736" rpy="0 0 0"/>
      <mass value="0.944195"/>
      <inertia ixx="0.00890167" ixy="-2.58865e-05" ixz="0.0016174" iyy="0.00895472" iyz="-2.49635e-05" izz="0.00487197"/>
    </inertial>
    <visual><origin xyz="0 0 0" rpy="0 0 0"/><geometry><mesh filename="meshes/torso.stl"/></geometry><material name="shell"/></visual>
    <visual><origin xyz="0.063767 0 0.0297616" rpy="0 0 0"/><geometry><box size="0.00897 0.16419 0.110994"/></geometry><material name="display"/></visual>
    <visual><origin xyz="0.068252 0 0.0297616" rpy="0 0 0"/><geometry><box size="0.0004 0.14976 0.0936"/></geometry><material name="screen"/></visual>
    <collision><origin xyz="-0.0296067 -1.37824e-06 0.0218426" rpy="0 0 0"/><geometry><box size="0.13897 0.0942318 0.0927983"/></geometry></collision>
    <collision><origin xyz="0.036153 0.072991 0.0440146" rpy="0 0 0"/><geometry><sphere radius="0.0527986"/></geometry></collision>
    <collision><origin xyz="0.0364029 -0.073103 0.0440146" rpy="0 0 0"/><geometry><sphere radius="0.0527479"/></geometry></collision>
    <collision><origin xyz="-0.00453781 0.000232068 0.0891062" rpy="0 0 0"/><geometry><sphere radius="0.0905601"/></geometry></collision>
    <collision><origin xyz="-0.00790729 -0.000106693 0.130807" rpy="0 0 0"/><geometry><sphere radius="0.104479"/></geometry></collision>
    <collision><origin xyz="-0.0120406 -0.000176093 0.172515" rpy="0 0 0"/><geometry><sphere radius="0.103269"/></geometry></collision>
    <collision><origin xyz="-0.00944579 0.000743875 0.21422" rpy="0 0 0"/><geometry><sphere radius="0.0897965"/></geometry></collision>
    <collision><origin xyz="-0.00558936 0.00588798 0.255952" rpy="0 0 0"/><geometry><sphere radius="0.0640042"/></geometry></collision>
    <collision><origin xyz="-0.0102433 -0.00194611 0.297647" rpy="0 0 0"/><geometry><sphere radius="0.0371435"/></geometry></collision>
    <collision><origin xyz="0.063767 0 0.0297616" rpy="0 0 0"/><geometry><box size="0.00897 0.16419 0.110994"/></geometry></collision>
  </link>
  <link name="leg_l">
    <inertial>
      <origin xyz="-0.000150879 -5.44186e-05 -0.0182186" rpy="0 0 0"/>
      <mass value="0.0247778"/>
      <inertia ixx="4.84898e-06" ixy="-1.75e-09" ixz="4.27334e-08" iyy="2.74403e-06" iyz="1.84899e-08" izz="4.46535e-06"/>
    </inertial>
    <visual><origin xyz="0 0 0" rpy="0 0 0"/><geometry><mesh filename="meshes/leg_l.stl"/></geometry><material name="shell"/></visual>
    <collision><origin xyz="-4.29907e-07 -5.92665e-06 -0.00464135" rpy="0 0 0"/><geometry><box size="0.0354468 0.0324752 0.00928271"/></geometry></collision>
  </link>
  <link name="foot_l">
    <inertial>
      <origin xyz="0.000412247 0.0042914 -0.00173449" rpy="0 0 0"/>
      <mass value="0.0580575"/>
      <inertia ixx="6.20998e-06" ixy="-2.53728e-07" ixz="-9.64777e-08" iyy="8.58072e-06" iyz="-5.69344e-07" izz="1.00877e-05"/>
    </inertial>
    <visual><origin xyz="0 0 0" rpy="0 0 0"/><geometry><mesh filename="meshes/foot_l.stl"/></geometry><material name="shell"/></visual>
    <visual><origin xyz="0 0.0055 3.36778e-19" rpy="0 0 0"/><geometry><box size="0.0275 0.023 0.012"/></geometry><material name="motor"/></visual>
    <collision><origin xyz="0 0 0" rpy="0 0 0"/><geometry><mesh filename="meshes/foot_l.stl"/></geometry></collision>
  </link>
  <link name="leg_r">
    <inertial>
      <origin xyz="-0.000112999 6.2792e-05 -0.018142" rpy="0 0 0"/>
      <mass value="0.0248263"/>
      <inertia ixx="4.87541e-06" ixy="-6.2391e-09" ixz="3.31642e-08" iyy="2.7538e-06" iyz="-2.1333e-08" izz="4.47806e-06"/>
    </inertial>
    <visual><origin xyz="0 0 0" rpy="0 0 0"/><geometry><mesh filename="meshes/leg_r.stl"/></geometry><material name="shell"/></visual>
    <collision><origin xyz="1.02667e-06 9.3956e-06 -0.00458184" rpy="0 0 0"/><geometry><box size="0.0354181 0.0325376 0.00916367"/></geometry></collision>
  </link>
  <link name="foot_r">
    <inertial>
      <origin xyz="0.000258929 -0.00408988 -0.00175394" rpy="0 0 0"/>
      <mass value="0.0579856"/>
      <inertia ixx="6.13895e-06" ixy="2.42557e-07" ixz="-5.96493e-08" iyy="8.53331e-06" iyz="5.35183e-07" izz="1.00092e-05"/>
    </inertial>
    <visual><origin xyz="0 0 0" rpy="0 0 0"/><geometry><mesh filename="meshes/foot_r.stl"/></geometry><material name="shell"/></visual>
    <visual><origin xyz="0 -0.0055 3.36778e-19" rpy="0 0 0"/><geometry><box size="0.0275 0.023 0.012"/></geometry><material name="motor"/></visual>
    <collision><origin xyz="0 0 0" rpy="0 0 0"/><geometry><mesh filename="meshes/foot_r.stl"/></geometry></collision>
  </link>
  <joint name="waist_fixed" type="fixed">
    <parent link="pelvis"/><child link="torso"/>
    <origin xyz="0 0 0.03965" rpy="0 0 0"/>
  </joint>
  <joint name="hip_yaw_l" type="revolute">
    <parent link="pelvis"/><child link="leg_l"/>
    <origin xyz="2.00147e-06 0.0185822 0" rpy="0 0 0"/>
    <axis xyz="0 0 1"/>
    <limit lower="-0.523599" upper="0.523599" effort="0.44" velocity="11.6"/>
    <dynamics damping="0.03142857142857144" friction="0.012571428571428574"/>
  </joint>
  <joint name="hip_yaw_r" type="revolute">
    <parent link="pelvis"/><child link="leg_r"/>
    <origin xyz="-2.00147e-06 -0.0188115 0" rpy="0 0 0"/>
    <axis xyz="0 0 1"/>
    <limit lower="-0.523599" upper="0.523599" effort="0.44" velocity="11.6"/>
    <dynamics damping="0.03142857142857144" friction="0.012571428571428574"/>
  </joint>
  <joint name="ankle_roll_l" type="revolute">
    <parent link="leg_l"/><child link="foot_l"/>
    <origin xyz="0.00827484 -0.00479212 -0.0310125" rpy="0 0 0"/>
    <axis xyz="1 0 0"/>
    <limit lower="-0.261799" upper="0.261799" effort="0.44" velocity="11.6"/>
    <dynamics damping="0.03142857142857144" friction="0.012571428571428574"/>
  </joint>
  <joint name="ankle_roll_r" type="revolute">
    <parent link="leg_r"/><child link="foot_r"/>
    <origin xyz="0.0086908 0.00413156 -0.0310125" rpy="0 0 0"/>
    <axis xyz="1 0 0"/>
    <limit lower="-0.261799" upper="0.261799" effort="0.44" velocity="11.6"/>
    <dynamics damping="0.03142857142857144" friction="0.012571428571428574"/>
  </joint>
</robot>
