yuuundj/Haetburi-practice/robot/v14_sts3032_hidden_7in/haetburi.urdf

<?xml version="1.0"?>
<!-- Haetburi biped (v14_sts3032_hidden_7in) - generated by tools/build_model.py, do not edit by hand -->
<robot name="haetburi">
  <mujoco>
    <compiler meshdir="." balanceinertia="true" discardvisual="false" strippath="false" fusestatic="false"/>
  </mujoco>
  <material name="display"><color rgba="0.18 0.19 0.21 1"/></material>
  <material name="screen"><color rgba="0.62 0.80 0.95 1"/></material>
  <material name="shell"><color rgba="0.106 0.216 0.541 1"/></material>
  <material name="motor"><color rgba="0.15 0.15 0.17 1"/></material>
  <material name="foot"><color rgba="0.25 0.25 0.28 1"/></material>
  <link name="world"/>
  <joint name="floating_base" type="floating">
    <parent link="world"/><child link="pelvis"/>
    <origin xyz="0 0 0" rpy="0 0 0"/>
  </joint>
  <link name="pelvis">
    <inertial>
      <origin xyz="-0.012249 -0.00140855 0.0390844" rpy="0 0 0"/>
      <mass value="0.279005"/>
      <inertia ixx="0.000312305" ixy="-1.13454e-05" ixz="0.000131474" iyy="0.000376163" iyz="4.51775e-06" izz="0.000297298"/>
    </inertial>
    <visual><origin xyz="0 0 0" rpy="0 0 0"/><geometry><mesh filename="meshes/pelvis.stl"/></geometry><material name="shell"/></visual>
    <visual><origin xyz="0.00550237 0.0220127 0.02575" rpy="0 0 0"/><geometry><box size="0.023 0.012 0.0275"/></geometry><material name="motor"/></visual>
    <visual><origin xyz="0.00549763 -0.0222844 0.02575" rpy="0 0 0"/><geometry><box size="0.023 0.012 0.0275"/></geometry><material name="motor"/></visual>
    <visual><origin xyz="-0.0439285 -0.009471 0.067375" rpy="0 0 0"/><geometry><box size="0.016 0.056 0.031"/></geometry><material name="foot"/></visual>
    <visual><origin xyz="-0.0285285 0.005929 0.067375" rpy="0 0 0"/><geometry><box size="0.012 0.065 0.03"/></geometry><material name="foot"/></visual>
    <visual><origin xyz="-0.0516285 0.009779 0.1001" rpy="0 0 0"/><geometry><box size="0.006 0.065 0.03"/></geometry><material name="foot"/></visual>
    <visual><origin xyz="-0.0150535 -0.003696 0.021175" rpy="0 0 0"/><geometry><box size="0.008 0.035 0.018"/></geometry><material name="foot"/></visual>
    <visual><origin xyz="-0.0054285 0.000154 0.0154" rpy="0 0 0"/><geometry><box size="0.006 0.022 0.017"/></geometry><material name="foot"/></visual>
    <collision><origin xyz="0.00671404 -0.000131536 0.023485" rpy="0 0 0"/><geometry><box size="0.0804981 0.106897 0.04697"/></geometry></collision>
  </link>
  <link name="torso">
    <inertial>
      <origin xyz="0.00713129 0.000111234 0.122365" rpy="0 0 0"/>
      <mass value="1.14872"/>
      <inertia ixx="0.0138395" ixy="-4.39134e-05" ixz="0.0014008" iyy="0.0137394" iyz="-4.11667e-05" izz="0.00770909"/>
    </inertial>
    <visual><origin xyz="0 0 0" rpy="0 0 0"/><geometry><mesh filename="meshes/torso.stl"/></geometry><material name="shell"/></visual>
    <visual><origin xyz="0.0755394 0 0.052581" rpy="0 0 0"/><geometry><box size="0.0094 0.1755 0.0985"/></geometry><material name="display"/></visual>
    <visual><origin xyz="0.0802394 0 0.052581" rpy="0 0 0"/><geometry><box size="0.0004 0.1542 0.0866"/></geometry><material name="screen"/></visual>
    <collision><origin xyz="-0.0350725 -1.08413e-06 0.0258751" rpy="0 0 0"/><geometry><box size="0.164626 0.111639 0.10993"/></geometry></collision>
    <collision><origin xyz="0.0428274 0.0817158 0.0521403" rpy="0 0 0"/><geometry><sphere radius="0.0603858"/></geometry></collision>
    <collision><origin xyz="0.0431235 -0.0818484 0.0521403" rpy="0 0 0"/><geometry><sphere radius="0.0602941"/></geometry></collision>
    <collision><origin xyz="-0.00537556 0.000274911 0.105557" rpy="0 0 0"/><geometry><sphere radius="0.107279"/></geometry></collision>
    <collision><origin xyz="-0.0093671 -0.00012639 0.154956" rpy="0 0 0"/><geometry><sphere radius="0.123768"/></geometry></collision>
    <collision><origin xyz="-0.0142634 -0.000208602 0.204364" rpy="0 0 0"/><geometry><sphere radius="0.122334"/></geometry></collision>
    <collision><origin xyz="-0.0111896 0.000881206 0.253769" rpy="0 0 0"/><geometry><sphere radius="0.106374"/></geometry></collision>
    <collision><origin xyz="-0.00662124 0.00697499 0.303205" rpy="0 0 0"/><geometry><sphere radius="0.0758203"/></geometry></collision>
    <collision><origin xyz="-0.0121343 -0.00230539 0.352597" rpy="0 0 0"/><geometry><sphere radius="0.0440008"/></geometry></collision>
    <collision><origin xyz="0.0755394 0 0.052581" rpy="0 0 0"/><geometry><box size="0.0094 0.1755 0.0985"/></geometry></collision>
  </link>
  <link name="leg_l">
    <inertial>
      <origin xyz="-0.000367992 -0.000132726 -0.0185944" rpy="0 0 0"/>
      <mass value="0.0288688"/>
      <inertia ixx="7.12359e-06" ixy="-5.16586e-09" ixz="1.12115e-07" iyy="5.20705e-06" iyz="5.07951e-08" izz="6.41093e-06"/>
    </inertial>
    <visual><origin xyz="0 0 0" rpy="0 0 0"/><geometry><mesh filename="meshes/leg_l.stl"/></geometry><material name="shell"/></visual>
    <collision><origin xyz="-5.09274e-07 -7.0208e-06 -0.00549822" rpy="0 0 0"/><geometry><box size="0.0419908 0.0384706 0.0109964"/></geometry></collision>
  </link>
  <link name="foot_l">
    <inertial>
      <origin xyz="0.00106087 0.0048784 -0.0015144" rpy="0 0 0"/>
      <mass value="0.0833169"/>
      <inertia ixx="1.53542e-05" ixy="-8.19337e-07" ixz="-2.8313e-07" iyy="2.30546e-05" iyz="-8.12645e-07" izz="2.68084e-05"/>
    </inertial>
    <visual><origin xyz="0 0 0" rpy="0 0 0"/><geometry><mesh filename="meshes/foot_l.stl"/></geometry><material name="shell"/></visual>
    <visual><origin xyz="0 0.0055 3.36778e-19" rpy="0 0 0"/><geometry><box size="0.0275 0.023 0.012"/></geometry><material name="motor"/></visual>
    <collision><origin xyz="0 0 0" rpy="0 0 0"/><geometry><mesh filename="meshes/foot_l.stl"/></geometry></collision>
  </link>
  <link name="leg_r">
    <inertial>
      <origin xyz="-0.000275034 0.000152833 -0.0184943" rpy="0 0 0"/>
      <mass value="0.0289852"/>
      <inertia ixx="7.18699e-06" ixy="-2.16281e-08" ixz="8.77493e-08" iyy="5.21536e-06" iyz="-5.85372e-08" izz="6.45452e-06"/>
    </inertial>
    <visual><origin xyz="0 0 0" rpy="0 0 0"/><geometry><mesh filename="meshes/leg_r.stl"/></geometry><material name="shell"/></visual>
    <collision><origin xyz="1.21621e-06 1.11302e-05 -0.00542772" rpy="0 0 0"/><geometry><box size="0.0419568 0.0385446 0.0108554"/></geometry></collision>
  </link>
  <link name="foot_r">
    <inertial>
      <origin xyz="0.000557456 -0.0045847 -0.00155031" rpy="0 0 0"/>
      <mass value="0.0831444"/>
      <inertia ixx="1.51956e-05" ixy="7.92488e-07" ixz="-1.55138e-07" iyy="2.28847e-05" iyz="7.60891e-07" izz="2.65985e-05"/>
    </inertial>
    <visual><origin xyz="0 0 0" rpy="0 0 0"/><geometry><mesh filename="meshes/foot_r.stl"/></geometry><material name="shell"/></visual>
    <visual><origin xyz="0 -0.0055 3.36778e-19" rpy="0 0 0"/><geometry><box size="0.0275 0.023 0.012"/></geometry><material name="motor"/></visual>
    <collision><origin xyz="0 0 0" rpy="0 0 0"/><geometry><mesh filename="meshes/foot_r.stl"/></geometry></collision>
  </link>
  <joint name="waist_fixed" type="fixed">
    <parent link="pelvis"/><child link="torso"/>
    <origin xyz="0 0 0.04697" rpy="0 0 0"/>
  </joint>
  <joint name="hip_yaw_l" type="revolute">
    <parent link="pelvis"/><child link="leg_l"/>
    <origin xyz="2.37097e-06 0.0220127 0" rpy="0 0 0"/>
    <axis xyz="0 0 1"/>
    <limit lower="-0.523599" upper="0.523599" effort="0.44" velocity="11.6"/>
    <dynamics damping="0.03142857142857144" friction="0.012571428571428574"/>
  </joint>
  <joint name="hip_yaw_r" type="revolute">
    <parent link="pelvis"/><child link="leg_r"/>
    <origin xyz="-2.37097e-06 -0.0222844 0" rpy="0 0 0"/>
    <axis xyz="0 0 1"/>
    <limit lower="-0.523599" upper="0.523599" effort="0.44" velocity="11.6"/>
    <dynamics damping="0.03142857142857144" friction="0.012571428571428574"/>
  </joint>
  <joint name="ankle_roll_l" type="revolute">
    <parent link="leg_l"/><child link="foot_l"/>
    <origin xyz="0.00933212 -0.00456144 -0.0352375" rpy="0 0 0"/>
    <axis xyz="1 0 0"/>
    <limit lower="-0.261799" upper="0.261799" effort="0.44" velocity="11.6"/>
    <dynamics damping="0.03142857142857144" friction="0.012571428571428574"/>
  </joint>
  <joint name="ankle_roll_r" type="revolute">
    <parent link="leg_r"/><child link="foot_r"/>
    <origin xyz="0.0102099 0.00397892 -0.0352375" rpy="0 0 0"/>
    <axis xyz="1 0 0"/>
    <limit lower="-0.261799" upper="0.261799" effort="0.44" velocity="11.6"/>
    <dynamics damping="0.03142857142857144" friction="0.012571428571428574"/>
  </joint>
</robot>
