yuuundj/Haetburi-practice/robot/v14_xc330_hidden/haetburi.urdf

<?xml version="1.0"?>
<!-- Haetburi biped (v14_xc330_hidden) - generated by tools/build_model.py, do not edit by hand -->
<robot name="haetburi">
  <mujoco>
    <compiler meshdir="." balanceinertia="true" discardvisual="false" strippath="false" fusestatic="false"/>
  </mujoco>
  <material name="display"><color rgba="0.18 0.19 0.21 1"/></material>
  <material name="screen"><color rgba="0.62 0.80 0.95 1"/></material>
  <material name="shell"><color rgba="0.106 0.216 0.541 1"/></material>
  <material name="motor"><color rgba="0.15 0.15 0.17 1"/></material>
  <material name="foot"><color rgba="0.25 0.25 0.28 1"/></material>
  <link name="world"/>
  <joint name="floating_base" type="floating">
    <parent link="world"/><child link="pelvis"/>
    <origin xyz="0 0 0" rpy="0 0 0"/>
  </joint>
  <link name="pelvis">
    <inertial>
      <origin xyz="0.0156311 -5.01055e-05 0.0285884" rpy="0 0 0"/>
      <mass value="0.360675"/>
      <inertia ixx="0.000171552" ixy="-2.34994e-07" ixz="-1.50401e-05" iyy="0.000132527" iyz="-1.56015e-08" izz="0.000224481"/>
    </inertial>
    <visual><origin xyz="0 0 0" rpy="0 0 0"/><geometry><mesh filename="meshes/pelvis.stl"/></geometry><material name="shell"/></visual>
    <visual><origin xyz="0.00880265 0.0245857 0.033" rpy="0 0 0"/><geometry><box size="0.034 0.02 0.026"/></geometry><material name="motor"/></visual>
    <visual><origin xyz="0.00879735 -0.024889 0.033" rpy="0 0 0"/><geometry><box size="0.034 0.02 0.026"/></geometry><material name="motor"/></visual>
    <collision><origin xyz="0.0074988 -0.000146911 0.02623" rpy="0 0 0"/><geometry><box size="0.089907 0.119391 0.05246"/></geometry></collision>
  </link>
  <link name="torso">
    <inertial>
      <origin xyz="0.0216135 0.000104354 0.130744" rpy="0 0 0"/>
      <mass value="2.17652"/>
      <inertia ixx="0.0357799" ixy="-0.000105021" ixz="0.00644111" iyy="0.035995" iyz="-0.000101018" izz="0.0196717"/>
    </inertial>
    <visual><origin xyz="0 0 0" rpy="0 0 0"/><geometry><mesh filename="meshes/torso.stl"/></geometry><material name="shell"/></visual>
    <visual><origin xyz="0.0843686 0 0.0406669" rpy="0 0 0"/><geometry><box size="0.011868 0.217236 0.146854"/></geometry><material name="display"/></visual>
    <visual><origin xyz="0.0903026 0 0.0406669" rpy="0 0 0"/><geometry><box size="0.0004 0.198144 0.12384"/></geometry><material name="screen"/></visual>
    <collision><origin xyz="-0.0391719 -1.82352e-06 0.0288995" rpy="0 0 0"/><geometry><box size="0.183869 0.124676 0.122779"/></geometry></collision>
    <collision><origin xyz="0.0478332 0.0965728 0.0582346" rpy="0 0 0"/><geometry><sphere radius="0.0698567"/></geometry></collision>
    <collision><origin xyz="0.0481639 -0.0967208 0.0582346" rpy="0 0 0"/><geometry><sphere radius="0.0697895"/></geometry></collision>
    <collision><origin xyz="-0.00600387 0.000307043 0.117894" rpy="0 0 0"/><geometry><sphere radius="0.119818"/></geometry></collision>
    <collision><origin xyz="-0.010462 -0.000141163 0.173068" rpy="0 0 0"/><geometry><sphere radius="0.138234"/></geometry></collision>
    <collision><origin xyz="-0.0159306 -0.000232984 0.22825" rpy="0 0 0"/><geometry><sphere radius="0.136633"/></geometry></collision>
    <collision><origin xyz="-0.0124975 0.000984204 0.28343" rpy="0 0 0"/><geometry><sphere radius="0.118808"/></geometry></collision>
    <collision><origin xyz="-0.00739515 0.00779025 0.338644" rpy="0 0 0"/><geometry><sphere radius="0.0846824"/></geometry></collision>
    <collision><origin xyz="-0.0135526 -0.00257485 0.393809" rpy="0 0 0"/><geometry><sphere radius="0.0491437"/></geometry></collision>
    <collision><origin xyz="0.0843686 0 0.0406669" rpy="0 0 0"/><geometry><box size="0.011868 0.217236 0.146854"/></geometry></collision>
  </link>
  <link name="leg_l">
    <inertial>
      <origin xyz="-0.000426212 -0.000153725 -0.0205374" rpy="0 0 0"/>
      <mass value="0.0268786"/>
      <inertia ixx="7.64117e-06" ixy="-6.15894e-09" ixz="1.32393e-07" iyy="5.95425e-06" iyz="6.0226e-08" izz="6.6853e-06"/>
    </inertial>
    <visual><origin xyz="0 0 0" rpy="0 0 0"/><geometry><mesh filename="meshes/leg_l.stl"/></geometry><material name="shell"/></visual>
    <collision><origin xyz="-5.688e-07 -7.84141e-06 -0.00614087" rpy="0 0 0"/><geometry><box size="0.0468988 0.0429672 0.0122817"/></geometry></collision>
  </link>
  <link name="foot_l">
    <inertial>
      <origin xyz="0.000534726 0.0073892 -0.00232158" rpy="0 0 0"/>
      <mass value="0.0798228"/>
      <inertia ixx="2.03828e-05" ixy="-9.25168e-07" ixz="-2.06221e-07" iyy="2.76056e-05" iyz="-1.38617e-06" izz="3.29687e-05"/>
    </inertial>
    <visual><origin xyz="0 0 0" rpy="0 0 0"/><geometry><mesh filename="meshes/foot_l.stl"/></geometry><material name="shell"/></visual>
    <visual><origin xyz="0 0.0088 5.38845e-19" rpy="0 0 0"/><geometry><box size="0.026 0.034 0.02"/></geometry><material name="motor"/></visual>
    <collision><origin xyz="0 0 0" rpy="0 0 0"/><geometry><mesh filename="meshes/foot_l.stl"/></geometry></collision>
  </link>
  <link name="leg_r">
    <inertial>
      <origin xyz="-0.0003185 0.000176986 -0.0204253" rpy="0 0 0"/>
      <mass value="0.0269909"/>
      <inertia ixx="7.71633e-06" ixy="-2.6103e-08" ixz="1.03703e-07" iyy="5.96314e-06" iyz="-6.94008e-08" izz="6.73786e-06"/>
    </inertial>
    <visual><origin xyz="0 0 0" rpy="0 0 0"/><geometry><mesh filename="meshes/leg_r.stl"/></geometry><material name="shell"/></visual>
    <collision><origin xyz="1.35836e-06 1.24311e-05 -0.00606212" rpy="0 0 0"/><geometry><box size="0.0468608 0.0430498 0.0121242"/></geometry></collision>
  </link>
  <link name="foot_r">
    <inertial>
      <origin xyz="0.000868835 -0.00717632 -0.00236172" rpy="0 0 0"/>
      <mass value="0.0796564"/>
      <inertia ixx="2.02028e-05" ixy="1.0119e-06" ixz="-2.24454e-07" iyy="2.75114e-05" iyz="1.34772e-06" izz="3.28357e-05"/>
    </inertial>
    <visual><origin xyz="0 0 0" rpy="0 0 0"/><geometry><mesh filename="meshes/foot_r.stl"/></geometry><material name="shell"/></visual>
    <visual><origin xyz="0 -0.0088 5.38845e-19" rpy="0 0 0"/><geometry><box size="0.026 0.034 0.02"/></geometry><material name="motor"/></visual>
    <collision><origin xyz="0 0 0" rpy="0 0 0"/><geometry><mesh filename="meshes/foot_r.stl"/></geometry></collision>
  </link>
  <joint name="waist_fixed" type="fixed">
    <parent link="pelvis"/><child link="torso"/>
    <origin xyz="0 0 0.05246" rpy="0 0 0"/>
  </joint>
  <joint name="hip_yaw_l" type="revolute">
    <parent link="pelvis"/><child link="leg_l"/>
    <origin xyz="2.6481e-06 0.0245857 0" rpy="0 0 0"/>
    <axis xyz="0 0 1"/>
    <limit lower="-0.523599" upper="0.523599" effort="1.0" velocity="7.43"/>
    <dynamics damping="0.07142857142857144" friction="0.028571428571428574"/>
  </joint>
  <joint name="hip_yaw_r" type="revolute">
    <parent link="pelvis"/><child link="leg_r"/>
    <origin xyz="-2.6481e-06 -0.024889 0" rpy="0 0 0"/>
    <axis xyz="0 0 1"/>
    <limit lower="-0.523599" upper="0.523599" effort="1.0" velocity="7.43"/>
    <dynamics damping="0.07142857142857144" friction="0.028571428571428574"/>
  </joint>
  <joint name="ankle_roll_l" type="revolute">
    <parent link="leg_l"/><child link="foot_l"/>
    <origin xyz="0.0116813 -0.00742343 -0.03924" rpy="0 0 0"/>
    <axis xyz="1 0 0"/>
    <limit lower="-0.261799" upper="0.261799" effort="1.0" velocity="7.43"/>
    <dynamics damping="0.07142857142857144" friction="0.028571428571428574"/>
  </joint>
  <joint name="ankle_roll_r" type="revolute">
    <parent link="leg_r"/><child link="foot_r"/>
    <origin xyz="0.0109417 0.00699945 -0.03924" rpy="0 0 0"/>
    <axis xyz="1 0 0"/>
    <limit lower="-0.261799" upper="0.261799" effort="1.0" velocity="7.43"/>
    <dynamics damping="0.07142857142857144" friction="0.028571428571428574"/>
  </joint>
</robot>
