yuuundj/Haetburi-practice/robot/v16_xm430/haetburi.urdf

<?xml version="1.0"?>
<!-- Haetburi biped (v16_xm430) - generated by tools/build_model.py, do not edit by hand -->
<robot name="haetburi">
  <mujoco>
    <compiler meshdir="." balanceinertia="true" discardvisual="false" strippath="false" fusestatic="false"/>
  </mujoco>
  <material name="display"><color rgba="0.18 0.19 0.21 1"/></material>
  <material name="screen"><color rgba="0.62 0.80 0.95 1"/></material>
  <material name="shell"><color rgba="0.106 0.216 0.541 1"/></material>
  <material name="motor"><color rgba="0.15 0.15 0.17 1"/></material>
  <material name="foot"><color rgba="0.25 0.25 0.28 1"/></material>
  <link name="world"/>
  <joint name="floating_base" type="floating">
    <parent link="world"/><child link="pelvis"/>
    <origin xyz="0 0 0" rpy="0 0 0"/>
  </joint>
  <link name="pelvis">
    <inertial>
      <origin xyz="-0.00228866 -0.000165581 0.0508124" rpy="0 0 0"/>
      <mass value="0.746087"/>
      <inertia ixx="0.00260875" ixy="6.1257e-07" ixz="0.000510418" iyy="0.00243468" iyz="-1.43412e-06" izz="0.00290076"/>
    </inertial>
    <visual><origin xyz="0 0 0" rpy="0 0 0"/><geometry><mesh filename="meshes/pelvis.stl"/></geometry><material name="shell"/></visual>
    <visual><origin xyz="0.0120044 0.0405949 0.037" rpy="0 0 0"/><geometry><box size="0.0465 0.0285 0.034"/></geometry><material name="motor"/></visual>
    <visual><origin xyz="0.0119956 -0.0410958 0.037" rpy="0 0 0"/><geometry><box size="0.0465 0.0285 0.034"/></geometry><material name="motor"/></visual>
    <collision><origin xyz="0.0123817 -0.000242574 0.04331" rpy="0 0 0"/><geometry><box size="0.148451 0.197134 0.08662"/></geometry></collision>
  </link>
  <link name="torso">
    <inertial>
      <origin xyz="0.0194673 0.000199278 0.239954" rpy="0 0 0"/>
      <mass value="8.47174"/>
      <inertia ixx="0.382191" ixy="-0.0013163" ixz="0.0546104" iyy="0.382539" iyz="-0.00119915" izz="0.210702"/>
    </inertial>
    <visual><origin xyz="0 0 0" rpy="0 0 0"/><geometry><mesh filename="meshes/torso.stl"/></geometry><material name="shell"/></visual>
    <visual><origin xyz="0.139306 0 0.0706976" rpy="0 0 0"/><geometry><box size="0.019596 0.358692 0.242479"/></geometry><material name="display"/></visual>
    <visual><origin xyz="0.149104 0 0.0706976" rpy="0 0 0"/><geometry><box size="0.0004 0.327168 0.20448"/></geometry><material name="screen"/></visual>
    <collision><origin xyz="-0.0646792 -3.01093e-06 0.0477177" rpy="0 0 0"/><geometry><box size="0.303597 0.20586 0.202729"/></geometry></collision>
    <collision><origin xyz="0.0789804 0.159457 0.0961549" rpy="0 0 0"/><geometry><sphere radius="0.115345"/></geometry></collision>
    <collision><origin xyz="0.0795264 -0.159702 0.0961549" rpy="0 0 0"/><geometry><sphere radius="0.115234"/></geometry></collision>
    <collision><origin xyz="-0.00991337 0.000506978 0.194663" rpy="0 0 0"/><geometry><sphere radius="0.197839"/></geometry></collision>
    <collision><origin xyz="-0.0172744 -0.000233083 0.285763" rpy="0 0 0"/><geometry><sphere radius="0.228247"/></geometry></collision>
    <collision><origin xyz="-0.026304 -0.000384695 0.376879" rpy="0 0 0"/><geometry><sphere radius="0.225604"/></geometry></collision>
    <collision><origin xyz="-0.0206354 0.00162508 0.467989" rpy="0 0 0"/><geometry><sphere radius="0.196171"/></geometry></collision>
    <collision><origin xyz="-0.0122106 0.012863 0.559157" rpy="0 0 0"/><geometry><sphere radius="0.139824"/></geometry></collision>
    <collision><origin xyz="-0.0223776 -0.0042515 0.650244" rpy="0 0 0"/><geometry><sphere radius="0.0811443"/></geometry></collision>
    <collision><origin xyz="0.139306 0 0.0706976" rpy="0 0 0"/><geometry><box size="0.019596 0.358692 0.242479"/></geometry></collision>
  </link>
  <link name="leg_l">
    <inertial>
      <origin xyz="-0.000833421 -0.000300596 -0.0339554" rpy="0 0 0"/>
      <mass value="0.102171"/>
      <inertia ixx="7.18023e-05" ixy="-7.16058e-08" ixz="1.62867e-06" iyy="6.8596e-05" iyz="7.40527e-07" izz="5.28579e-05"/>
    </inertial>
    <visual><origin xyz="0 0 0" rpy="0 0 0"/><geometry><mesh filename="meshes/leg_l.stl"/></geometry><material name="shell"/></visual>
    <collision><origin xyz="-9.39181e-07 -1.29475e-05 -0.0101396" rpy="0 0 0"/><geometry><box size="0.0774375 0.0709459 0.0202791"/></geometry></collision>
  </link>
  <link name="ankle_l">
    <inertial>
      <origin xyz="-0.000852146 -0.000230877 -0.00119636" rpy="0 0 0"/>
      <mass value="0.153678"/>
      <inertia ixx="2.14759e-05" ixy="-5.21669e-07" ixz="-2.70319e-06" iyy="5.43955e-05" iyz="-4.85603e-08" izz="5.94888e-05"/>
    </inertial>
    <visual><origin xyz="0.012 0 0" rpy="0 0 0"/><geometry><box size="0.0465 0.034 0.0285"/></geometry><material name="motor"/></visual>
  </link>
  <link name="foot_l">
    <inertial>
      <origin xyz="0.019483 0.000898793 0.00682364" rpy="0 0 0"/>
      <mass value="0.285271"/>
      <inertia ixx="0.000207611" ixy="-1.29464e-05" ixz="1.92051e-06" iyy="0.00037773" iyz="-4.78019e-08" izz="0.000418217"/>
    </inertial>
    <visual><origin xyz="0 0 0" rpy="0 0 0"/><geometry><mesh filename="meshes/foot_l.stl"/></geometry><material name="shell"/></visual>
    <visual><origin xyz="0 0 0.012" rpy="0 0 0"/><geometry><box size="0.034 0.0285 0.0465"/></geometry><material name="motor"/></visual>
    <collision><origin xyz="0 0 0" rpy="0 0 0"/><geometry><mesh filename="meshes/foot_l.stl"/></geometry></collision>
  </link>
  <link name="leg_r">
    <inertial>
      <origin xyz="-0.000622321 0.000345815 -0.03376" rpy="0 0 0"/>
      <mass value="0.102677"/>
      <inertia ixx="7.27029e-05" ixy="-3.23785e-07" ixz="1.27495e-06" iyy="6.86885e-05" iyz="-8.52978e-07" izz="5.35074e-05"/>
    </inertial>
    <visual><origin xyz="0 0 0" rpy="0 0 0"/><geometry><mesh filename="meshes/leg_r.stl"/></geometry><material name="shell"/></visual>
    <collision><origin xyz="2.24287e-06 2.05258e-05 -0.0100096" rpy="0 0 0"/><geometry><box size="0.0773749 0.0710822 0.0200191"/></geometry></collision>
  </link>
  <link name="ankle_r">
    <inertial>
      <origin xyz="-0.000852146 -0.000230877 -0.00119636" rpy="0 0 0"/>
      <mass value="0.153678"/>
      <inertia ixx="2.14759e-05" ixy="-5.21669e-07" ixz="-2.70319e-06" iyy="5.43955e-05" iyz="-4.85603e-08" izz="5.94888e-05"/>
    </inertial>
    <visual><origin xyz="0.012 0 0" rpy="0 0 0"/><geometry><box size="0.0465 0.034 0.0285"/></geometry><material name="motor"/></visual>
  </link>
  <link name="foot_r">
    <inertial>
      <origin xyz="0.0206219 -0.00108027 0.00675174" rpy="0 0 0"/>
      <mass value="0.284521"/>
      <inertia ixx="0.000206386" ixy="1.42642e-05" ixz="2.84188e-06" iyy="0.000383148" iyz="7.69132e-08" izz="0.000423753"/>
    </inertial>
    <visual><origin xyz="0 0 0" rpy="0 0 0"/><geometry><mesh filename="meshes/foot_r.stl"/></geometry><material name="shell"/></visual>
    <visual><origin xyz="0 0 0.012" rpy="0 0 0"/><geometry><box size="0.034 0.0285 0.0465"/></geometry><material name="motor"/></visual>
    <collision><origin xyz="0 0 0" rpy="0 0 0"/><geometry><mesh filename="meshes/foot_r.stl"/></geometry></collision>
  </link>
  <joint name="waist_fixed" type="fixed">
    <parent link="pelvis"/><child link="torso"/>
    <origin xyz="0 0 0.08662" rpy="0 0 0"/>
  </joint>
  <joint name="hip_yaw_l" type="revolute">
    <parent link="pelvis"/><child link="leg_l"/>
    <origin xyz="4.37245e-06 0.0405949 0" rpy="0 0 0"/>
    <axis xyz="0 0 1"/>
    <limit lower="-0.523599" upper="0.523599" effort="4.1" velocity="4.82"/>
    <dynamics damping="0.29285714285714287" friction="0.11714285714285713"/>
  </joint>
  <joint name="hip_yaw_r" type="revolute">
    <parent link="pelvis"/><child link="leg_r"/>
    <origin xyz="-4.37245e-06 -0.0410958 0" rpy="0 0 0"/>
    <axis xyz="0 0 1"/>
    <limit lower="-0.523599" upper="0.523599" effort="4.1" velocity="4.82"/>
    <dynamics damping="0.29285714285714287" friction="0.11714285714285713"/>
  </joint>
  <joint name="ankle_pitch_l" type="revolute">
    <parent link="leg_l"/><child link="ankle_l"/>
    <origin xyz="0.022562 0.00266644 -0.06945" rpy="0 0 0"/>
    <axis xyz="0 1 0"/>
    <limit lower="-0.261799" upper="0.261799" effort="4.1" velocity="4.82"/>
    <dynamics damping="0.29285714285714287" friction="0.11714285714285713"/>
  </joint>
  <joint name="ankle_pitch_r" type="revolute">
    <parent link="leg_r"/><child link="ankle_r"/>
    <origin xyz="0.0206307 -0.000449521 -0.06945" rpy="0 0 0"/>
    <axis xyz="0 1 0"/>
    <limit lower="-0.261799" upper="0.261799" effort="4.1" velocity="4.82"/>
    <dynamics damping="0.29285714285714287" friction="0.11714285714285713"/>
  </joint>
  <joint name="ankle_roll_l" type="revolute">
    <parent link="ankle_l"/><child link="foot_l"/>
    <origin xyz="-0.03111 -0.00099 -0.00513" rpy="0 0 0"/>
    <axis xyz="1 0 0"/>
    <limit lower="-0.20944" upper="0.20944" effort="4.1" velocity="4.82"/>
    <dynamics damping="0.29285714285714287" friction="0.11714285714285713"/>
  </joint>
  <joint name="ankle_roll_r" type="revolute">
    <parent link="ankle_r"/><child link="foot_r"/>
    <origin xyz="-0.03111 -0.00099 -0.00513" rpy="0 0 0"/>
    <axis xyz="1 0 0"/>
    <limit lower="-0.20944" upper="0.20944" effort="4.1" velocity="4.82"/>
    <dynamics damping="0.29285714285714287" friction="0.11714285714285713"/>
  </joint>
</robot>
