yuuundj/Haetburi-practice/robot/v17_sts3032_w4/haetburi.urdf

<?xml version="1.0"?>
<!-- Haetburi biped (v17_sts3032_w4) - generated by tools/build_model.py, do not edit by hand -->
<robot name="haetburi">
  <mujoco>
    <compiler meshdir="." balanceinertia="true" discardvisual="false" strippath="false" fusestatic="false"/>
  </mujoco>
  <material name="display"><color rgba="0.18 0.19 0.21 1"/></material>
  <material name="screen"><color rgba="0.62 0.80 0.95 1"/></material>
  <material name="shell"><color rgba="0.106 0.216 0.541 1"/></material>
  <material name="motor"><color rgba="0.15 0.15 0.17 1"/></material>
  <material name="foot"><color rgba="0.25 0.25 0.28 1"/></material>
  <link name="world"/>
  <joint name="floating_base" type="floating">
    <parent link="world"/><child link="pelvis"/>
    <origin xyz="0 0 0" rpy="0 0 0"/>
  </joint>
  <link name="pelvis">
    <inertial>
      <origin xyz="-0.00610925 9.50716e-06 0.0405152" rpy="0 0 0"/>
      <mass value="0.292915"/>
      <inertia ixx="0.00030735" ixy="8.35174e-07" ixz="8.23488e-05" iyy="0.000357816" iyz="8.25968e-07" izz="0.000307664"/>
    </inertial>
    <visual><origin xyz="0 0 0" rpy="0 0 0"/><geometry><mesh filename="meshes/pelvis.stl"/></geometry><material name="shell"/></visual>
    <visual><origin xyz="0.00600244 0.0226798 0.05175" rpy="0 0 0"/><geometry><box size="0.023 0.012 0.0275"/></geometry><material name="motor"/></visual>
    <visual><origin xyz="0.00699756 -0.0229596 0.05175" rpy="0 0 0"/><geometry><box size="0.023 0.012 0.0275"/></geometry><material name="motor"/></visual>
    <collision><origin xyz="0.0069175 -0.000135522 0.0201274" rpy="0 0 0"/><geometry><box size="0.0829374 0.110136 0.0565319"/></geometry></collision>
  </link>
  <link name="torso">
    <inertial>
      <origin xyz="0.0238953 7.63336e-05 0.103132" rpy="0 0 0"/>
      <mass value="1.599"/>
      <inertia ixx="0.0205747" ixy="-4.70239e-05" ixz="0.00355319" iyy="0.0202897" iyz="-5.01842e-05" izz="0.0117163"/>
    </inertial>
    <visual><origin xyz="0 0 0" rpy="0 0 0"/><geometry><mesh filename="meshes/torso.stl"/></geometry><material name="shell"/></visual>
    <visual><origin xyz="0.0778284 0 0.0371177" rpy="0 0 0"/><geometry><box size="0.010948 0.200396 0.13547"/></geometry><material name="display"/></visual>
    <visual><origin xyz="0.0833024 0 0.0371177" rpy="0 0 0"/><geometry><box size="0.0004 0.182784 0.11424"/></geometry><material name="screen"/></visual>
    <collision><origin xyz="-0.0361353 -1.68216e-06 0.0266592" rpy="0 0 0"/><geometry><box size="0.169615 0.115011 0.113262"/></geometry></collision>
    <collision><origin xyz="0.0441252 0.0890865 0.0537203" rpy="0 0 0"/><geometry><sphere radius="0.0644414"/></geometry></collision>
    <collision><origin xyz="0.0444303 -0.0892231 0.0537203" rpy="0 0 0"/><geometry><sphere radius="0.0643794"/></geometry></collision>
    <collision><origin xyz="-0.00553846 0.000283241 0.108755" rpy="0 0 0"/><geometry><sphere radius="0.11053"/></geometry></collision>
    <collision><origin xyz="-0.00965095 -0.00013022 0.159651" rpy="0 0 0"/><geometry><sphere radius="0.127519"/></geometry></collision>
    <collision><origin xyz="-0.0146957 -0.000214924 0.210557" rpy="0 0 0"/><geometry><sphere radius="0.126041"/></geometry></collision>
    <collision><origin xyz="-0.0115287 0.000907909 0.261459" rpy="0 0 0"/><geometry><sphere radius="0.109598"/></geometry></collision>
    <collision><origin xyz="-0.00682188 0.00718636 0.312393" rpy="0 0 0"/><geometry><sphere radius="0.0781179"/></geometry></collision>
    <collision><origin xyz="-0.012502 -0.00237525 0.363282" rpy="0 0 0"/><geometry><sphere radius="0.0453342"/></geometry></collision>
    <collision><origin xyz="0.0778284 0 0.0371177" rpy="0 0 0"/><geometry><box size="0.010948 0.200396 0.13547"/></geometry></collision>
  </link>
  <link name="leg_l">
    <inertial>
      <origin xyz="-0.000485724 0.00188918 -0.0283227" rpy="0 0 0"/>
      <mass value="0.0342656"/>
      <inertia ixx="1.15863e-05" ixy="-1.82618e-08" ixz="7.92926e-08" iyy="9.66639e-06" iyz="1.56223e-08" izz="4.2911e-06"/>
    </inertial>
    <visual><origin xyz="0 0 0" rpy="0 0 0"/><geometry><mesh filename="meshes/leg_l.stl"/></geometry><material name="shell"/></visual>
    <collision><origin xyz="-0.000246323 0.00227676 -0.0235691" rpy="0 0 0"/><geometry><box size="0.0422678 0.0380901 0.00552114"/></geometry></collision>
  </link>
  <link name="hip_l">
    <inertial>
      <origin xyz="0 -0.00169586 0.0195876" rpy="0 0 0"/>
      <mass value="0.0359266"/>
      <inertia ixx="2.75364e-06" ixy="0" ixz="0" iyy="1.47051e-06" iyz="2.28102e-08" izz="1.88312e-06"/>
    </inertial>
    <visual><origin xyz="0 -0.002 0.0205" rpy="0 0 0"/><geometry><box size="0.012 0.0275 0.023"/></geometry><material name="motor"/></visual>
  </link>
  <link name="foot_l">
    <inertial>
      <origin xyz="0.000379982 0.00454592 -0.000993857" rpy="0 0 0"/>
      <mass value="0.0859819"/>
      <inertia ixx="1.68751e-05" ixy="-8.22236e-07" ixz="-1.78481e-07" iyy="2.55293e-05" iyz="-7.59144e-07" izz="2.96581e-05"/>
    </inertial>
    <visual><origin xyz="0 0 0" rpy="0 0 0"/><geometry><mesh filename="meshes/foot_l.stl"/></geometry><material name="shell"/></visual>
    <visual><origin xyz="0 0.0055 3.36778e-19" rpy="0 0 0"/><geometry><box size="0.0275 0.023 0.012"/></geometry><material name="motor"/></visual>
    <collision><origin xyz="0 0 0" rpy="0 0 0"/><geometry><mesh filename="meshes/foot_l.stl"/></geometry></collision>
  </link>
  <link name="leg_r">
    <inertial>
      <origin xyz="-0.000764726 -0.00238582 -0.0289208" rpy="0 0 0"/>
      <mass value="0.0352523"/>
      <inertia ixx="1.20498e-05" ixy="3.06836e-09" ixz="1.61846e-07" iyy="1.01783e-05" iyz="-1.8703e-08" izz="4.75363e-06"/>
    </inertial>
    <visual><origin xyz="0 0 0" rpy="0 0 0"/><geometry><mesh filename="meshes/leg_r.stl"/></geometry><material name="shell"/></visual>
    <collision><origin xyz="-0.00142742 -0.00269772 -0.0232627" rpy="0 0 0"/><geometry><box size="0.0423493 0.038395 0.00784336"/></geometry></collision>
  </link>
  <link name="hip_r">
    <inertial>
      <origin xyz="0 0.00211983 0.0204355" rpy="0 0 0"/>
      <mass value="0.0359266"/>
      <inertia ixx="2.78263e-06" ixy="0" ixz="0" iyy="1.49523e-06" iyz="-3.32649e-08" izz="1.8874e-06"/>
    </inertial>
    <visual><origin xyz="0 0.0025 0.0215" rpy="0 0 0"/><geometry><box size="0.012 0.0275 0.023"/></geometry><material name="motor"/></visual>
  </link>
  <link name="foot_r">
    <inertial>
      <origin xyz="0.000483094 -0.00458102 -0.0010322" rpy="0 0 0"/>
      <mass value="0.0857989"/>
      <inertia ixx="1.67672e-05" ixy="8.78849e-07" ixz="-1.59698e-07" iyy="2.54142e-05" iyz="7.68938e-07" izz="2.95706e-05"/>
    </inertial>
    <visual><origin xyz="0 0 0" rpy="0 0 0"/><geometry><mesh filename="meshes/foot_r.stl"/></geometry><material name="shell"/></visual>
    <visual><origin xyz="0 -0.0055 3.36778e-19" rpy="0 0 0"/><geometry><box size="0.0275 0.023 0.012"/></geometry><material name="motor"/></visual>
    <collision><origin xyz="0 0 0" rpy="0 0 0"/><geometry><mesh filename="meshes/foot_r.stl"/></geometry></collision>
  </link>
  <joint name="waist_fixed" type="fixed">
    <parent link="pelvis"/><child link="torso"/>
    <origin xyz="0 0 0.0483933" rpy="0 0 0"/>
  </joint>
  <joint name="hip_yaw_l" type="revolute">
    <parent link="pelvis"/><child link="hip_l"/>
    <origin xyz="0.000502443 0.0226798 0" rpy="0 0 0"/>
    <axis xyz="0 0 1"/>
    <limit lower="-0.296706" upper="0.296706" effort="0.44" velocity="11.6"/>
    <dynamics damping="0.03142857142857144" friction="0.012571428571428574"/>
  </joint>
  <joint name="hip_pitch_l" type="revolute">
    <parent link="hip_l"/><child link="leg_l"/>
    <origin xyz="0 -0.002 0.015" rpy="0 0 0"/>
    <axis xyz="0 1 0"/>
    <limit lower="-0.506145" upper="0.383972" effort="0.44" velocity="11.6"/>
    <dynamics damping="0.03142857142857144" friction="0.012571428571428574"/>
  </joint>
  <joint name="hip_yaw_r" type="revolute">
    <parent link="pelvis"/><child link="hip_r"/>
    <origin xyz="0.00149756 -0.0229596 0" rpy="0 0 0"/>
    <axis xyz="0 0 1"/>
    <limit lower="-0.296706" upper="0.296706" effort="0.44" velocity="11.6"/>
    <dynamics damping="0.03142857142857144" friction="0.012571428571428574"/>
  </joint>
  <joint name="hip_pitch_r" type="revolute">
    <parent link="hip_r"/><child link="leg_r"/>
    <origin xyz="0 0.0025 0.016" rpy="0 0 0"/>
    <axis xyz="0 1 0"/>
    <limit lower="-0.506145" upper="0.383972" effort="0.44" velocity="11.6"/>
    <dynamics damping="0.03142857142857144" friction="0.012571428571428574"/>
  </joint>
  <joint name="ankle_roll_l" type="revolute">
    <parent link="leg_l"/><child link="foot_l"/>
    <origin xyz="0.0105067 -0.00181269 -0.0518067" rpy="0 0 0"/>
    <axis xyz="1 0 0"/>
    <limit lower="-0.261799" upper="0.261799" effort="0.44" velocity="11.6"/>
    <dynamics damping="0.03142857142857144" friction="0.012571428571428574"/>
  </joint>
  <joint name="ankle_roll_r" type="revolute">
    <parent link="leg_r"/><child link="foot_r"/>
    <origin xyz="0.00922108 0.0013598 -0.0528067" rpy="0 0 0"/>
    <axis xyz="1 0 0"/>
    <limit lower="-0.261799" upper="0.261799" effort="0.44" velocity="11.6"/>
    <dynamics damping="0.03142857142857144" friction="0.012571428571428574"/>
  </joint>
</robot>
