yuuundj/Haetburi-practice/robot/v19_scs0009/haetburi.urdf

<?xml version="1.0"?>
<!-- Haetburi biped (v19_scs0009) - generated by tools/build_model.py, do not edit by hand -->
<robot name="haetburi">
  <mujoco>
    <compiler meshdir="." balanceinertia="true" discardvisual="false" strippath="false" fusestatic="false"/>
  </mujoco>
  <material name="display"><color rgba="0.18 0.19 0.21 1"/></material>
  <material name="screen"><color rgba="0.62 0.80 0.95 1"/></material>
  <material name="shell"><color rgba="0.106 0.216 0.541 1"/></material>
  <material name="motor"><color rgba="0.15 0.15 0.17 1"/></material>
  <material name="foot"><color rgba="0.25 0.25 0.28 1"/></material>
  <link name="world"/>
  <joint name="floating_base" type="floating">
    <parent link="world"/><child link="pelvis"/>
    <origin xyz="0 0 0" rpy="0 0 0"/>
  </joint>
  <link name="pelvis">
    <inertial>
      <origin xyz="-0.00565133 -0.0001742 0.0404389" rpy="0 0 0"/>
      <mass value="0.292833"/>
      <inertia ixx="0.000237458" ixy="1.50315e-06" ixz="7.75784e-05" iyy="0.000282223" iyz="-6.59828e-07" izz="0.000279635"/>
    </inertial>
    <visual><origin xyz="0 0 0" rpy="0 0 0"/><geometry><mesh filename="meshes/pelvis.stl"/></geometry><material name="shell"/></visual>
    <visual><origin xyz="0.00710235 0.0218222 0.050825" rpy="0 0 0"/><geometry><box size="0.0232 0.0121 0.02525"/></geometry><material name="motor"/></visual>
    <visual><origin xyz="0.00759765 -0.0220914 0.050825" rpy="0 0 0"/><geometry><box size="0.0232 0.0121 0.02525"/></geometry><material name="motor"/></visual>
    <collision><origin xyz="0.00665591 -0.000130398 0.0312817" rpy="0 0 0"/><geometry><box size="0.0798012 0.105971 0.0305633"/></geometry></collision>
  </link>
  <link name="torso">
    <inertial>
      <origin xyz="0.0223488 7.44665e-05 0.0999104" rpy="0 0 0"/>
      <mass value="1.46009"/>
      <inertia ixx="0.0174471" ixy="-4.03743e-05" ixz="0.00297839" iyy="0.0172088" iyz="-4.29393e-05" izz="0.00993189"/>
    </inertial>
    <visual><origin xyz="0 0 0" rpy="0 0 0"/><geometry><mesh filename="meshes/torso.stl"/></geometry><material name="shell"/></visual>
    <visual><origin xyz="0.0748853 0 0.0357141" rpy="0 0 0"/><geometry><box size="0.010534 0.192818 0.130347"/></geometry><material name="display"/></visual>
    <visual><origin xyz="0.0801523 0 0.0357141" rpy="0 0 0"/><geometry><box size="0.0004 0.175872 0.10992"/></geometry><material name="screen"/></visual>
    <collision><origin xyz="-0.0347689 -1.61855e-06 0.0256511" rpy="0 0 0"/><geometry><box size="0.163201 0.110662 0.108979"/></geometry></collision>
    <collision><origin xyz="0.0424566 0.0857177 0.0516889" rpy="0 0 0"/><geometry><sphere radius="0.0620046"/></geometry></collision>
    <collision><origin xyz="0.0427501 -0.0858491 0.0516889" rpy="0 0 0"/><geometry><sphere radius="0.0619449"/></geometry></collision>
    <collision><origin xyz="-0.00532902 0.000272531 0.104643" rpy="0 0 0"/><geometry><sphere radius="0.10635"/></geometry></collision>
    <collision><origin xyz="-0.009286 -0.000125296 0.153614" rpy="0 0 0"/><geometry><sphere radius="0.122696"/></geometry></collision>
    <collision><origin xyz="-0.0141399 -0.000206796 0.202594" rpy="0 0 0"/><geometry><sphere radius="0.121275"/></geometry></collision>
    <collision><origin xyz="-0.0110928 0.000873577 0.251572" rpy="0 0 0"/><geometry><sphere radius="0.105453"/></geometry></collision>
    <collision><origin xyz="-0.00656391 0.0069146 0.300579" rpy="0 0 0"/><geometry><sphere radius="0.0751639"/></geometry></collision>
    <collision><origin xyz="-0.0120293 -0.00228543 0.349544" rpy="0 0 0"/><geometry><sphere radius="0.0436198"/></geometry></collision>
    <collision><origin xyz="0.0748853 0 0.0357141" rpy="0 0 0"/><geometry><box size="0.010534 0.192818 0.130347"/></geometry></collision>
  </link>
  <link name="leg_l">
    <inertial>
      <origin xyz="-0.00142793 0.00169675 -0.0124327" rpy="0 0 0"/>
      <mass value="0.0444015"/>
      <inertia ixx="2.42411e-05" ixy="7.00684e-08" ixz="5.44817e-07" iyy="2.38542e-05" iyz="1.40733e-07" izz="1.08526e-05"/>
    </inertial>
    <visual><origin xyz="0 0 0" rpy="0 0 0"/><geometry><mesh filename="meshes/leg_l.stl"/></geometry><material name="shell"/></visual>
    <collision><origin xyz="-0.00151967 0.00207091 -0.00199661" rpy="0 0 0"/><geometry><box size="0.041197 0.0377789 0.0498092"/></geometry></collision>
  </link>
  <link name="hip_l">
    <inertial>
      <origin xyz="0 -0.00169586 0.0205051" rpy="0 0 0"/>
      <mass value="0.0189692"/>
      <inertia ixx="1.34943e-06" ixy="0" ixz="0" iyy="8.05144e-07" iyz="1.44526e-08" izz="8.66384e-07"/>
    </inertial>
    <visual><origin xyz="0 -0.002 0.0216" rpy="0 0 0"/><geometry><box size="0.0121 0.02525 0.0232"/></geometry><material name="motor"/></visual>
  </link>
  <link name="foot_l">
    <inertial>
      <origin xyz="0.0011021 0.00469495 -0.00157523" rpy="0 0 0"/>
      <mass value="0.07077"/>
      <inertia ixx="1.42002e-05" ixy="-7.84883e-07" ixz="-2.8065e-07" iyy="2.1269e-05" iyz="-7.74582e-07" izz="2.45661e-05"/>
    </inertial>
    <visual><origin xyz="0 0 0" rpy="0 0 0"/><geometry><mesh filename="meshes/foot_l.stl"/></geometry><material name="shell"/></visual>
    <visual><origin xyz="0 0.0056 3.42901e-19" rpy="0 0 0"/><geometry><box size="0.02525 0.0232 0.0121"/></geometry><material name="motor"/></visual>
    <collision><origin xyz="0 0 0" rpy="0 0 0"/><geometry><mesh filename="meshes/foot_l.stl"/></geometry></collision>
  </link>
  <link name="leg_r">
    <inertial>
      <origin xyz="-0.00164899 -0.00217189 -0.0122858" rpy="0 0 0"/>
      <mass value="0.044664"/>
      <inertia ixx="2.4402e-05" ixy="-8.64724e-08" ixz="7.13259e-07" iyy="2.3989e-05" iyz="-1.41398e-07" izz="1.09856e-05"/>
    </inertial>
    <visual><origin xyz="0 0 0" rpy="0 0 0"/><geometry><mesh filename="meshes/leg_r.stl"/></geometry><material name="shell"/></visual>
    <collision><origin xyz="-0.00207213 -0.00255403 -0.00170545" rpy="0 0 0"/><geometry><box size="0.0410472 0.0378571 0.050112"/></geometry></collision>
  </link>
  <link name="hip_r">
    <inertial>
      <origin xyz="0 0.00211983 0.0205051" rpy="0 0 0"/>
      <mass value="0.0189692"/>
      <inertia ixx="1.35168e-06" ixy="0" ixz="0" iyy="8.05144e-07" iyz="-1.80657e-08" izz="8.68643e-07"/>
    </inertial>
    <visual><origin xyz="0 0.0025 0.0216" rpy="0 0 0"/><geometry><box size="0.0121 0.02525 0.0232"/></geometry><material name="motor"/></visual>
  </link>
  <link name="foot_r">
    <inertial>
      <origin xyz="0.000754303 -0.00463915 -0.0019275" rpy="0 0 0"/>
      <mass value="0.0706006"/>
      <inertia ixx="1.41088e-05" ixy="7.89255e-07" ixz="-1.8081e-07" iyy="2.11511e-05" iyz="7.70784e-07" izz="2.44396e-05"/>
    </inertial>
    <visual><origin xyz="0 0 0" rpy="0 0 0"/><geometry><mesh filename="meshes/foot_r.stl"/></geometry><material name="shell"/></visual>
    <visual><origin xyz="0 -0.0056 3.42901e-19" rpy="0 0 0"/><geometry><box size="0.02525 0.0232 0.0121"/></geometry><material name="motor"/></visual>
    <collision><origin xyz="0 0 0" rpy="0 0 0"/><geometry><mesh filename="meshes/foot_r.stl"/></geometry></collision>
  </link>
  <joint name="waist_fixed" type="fixed">
    <parent link="pelvis"/><child link="torso"/>
    <origin xyz="0 0 0.0465633" rpy="0 0 0"/>
  </joint>
  <joint name="hip_yaw_l" type="revolute">
    <parent link="pelvis"/><child link="hip_l"/>
    <origin xyz="0.00150235 0.0218222 0" rpy="0 0 0"/>
    <axis xyz="0 0 1"/>
    <limit lower="-0.296706" upper="0.296706" effort="0.226" velocity="10.5"/>
    <dynamics damping="0.016142857142857146" friction="0.006457142857142858"/>
  </joint>
  <joint name="hip_pitch_l" type="revolute">
    <parent link="hip_l"/><child link="leg_l"/>
    <origin xyz="0 -0.002 0.016" rpy="0 0 0"/>
    <axis xyz="0 1 0"/>
    <limit lower="-0.558505" upper="0.471239" effort="0.226" velocity="10.5"/>
    <dynamics damping="0.016142857142857146" friction="0.006457142857142858"/>
  </joint>
  <joint name="hip_yaw_r" type="revolute">
    <parent link="pelvis"/><child link="hip_r"/>
    <origin xyz="0.00199765 -0.0220914 0" rpy="0 0 0"/>
    <axis xyz="0 0 1"/>
    <limit lower="-0.296706" upper="0.296706" effort="0.226" velocity="10.5"/>
    <dynamics damping="0.016142857142857146" friction="0.006457142857142858"/>
  </joint>
  <joint name="hip_pitch_r" type="revolute">
    <parent link="hip_r"/><child link="leg_r"/>
    <origin xyz="0 0.0025 0.016" rpy="0 0 0"/>
    <axis xyz="0 1 0"/>
    <limit lower="-0.558505" upper="0.471239" effort="0.226" velocity="10.5"/>
    <dynamics damping="0.016142857142857146" friction="0.006457142857142858"/>
  </joint>
  <joint name="ankle_roll_l" type="revolute">
    <parent link="leg_l"/><child link="foot_l"/>
    <origin xyz="0.007942 -0.00243537 -0.0511775" rpy="0 0 0"/>
    <axis xyz="1 0 0"/>
    <limit lower="-0.261799" upper="0.261799" effort="0.226" velocity="10.5"/>
    <dynamics damping="0.016142857142857146" friction="0.006457142857142858"/>
  </joint>
  <joint name="ankle_roll_r" type="revolute">
    <parent link="leg_r"/><child link="foot_r"/>
    <origin xyz="0.00793048 0.00182629 -0.0507958" rpy="0 0 0"/>
    <axis xyz="1 0 0"/>
    <limit lower="-0.261799" upper="0.261799" effort="0.226" velocity="10.5"/>
    <dynamics damping="0.016142857142857146" friction="0.006457142857142858"/>
  </joint>
</robot>
