yuuundj/Haetburi-practice/robot/v19_xl330/haetburi.urdf

<?xml version="1.0"?>
<!-- Haetburi biped (v19_xl330) - generated by tools/build_model.py, do not edit by hand -->
<robot name="haetburi">
  <mujoco>
    <compiler meshdir="." balanceinertia="true" discardvisual="false" strippath="false" fusestatic="false"/>
  </mujoco>
  <material name="display"><color rgba="0.18 0.19 0.21 1"/></material>
  <material name="screen"><color rgba="0.62 0.80 0.95 1"/></material>
  <material name="shell"><color rgba="0.106 0.216 0.541 1"/></material>
  <material name="motor"><color rgba="0.15 0.15 0.17 1"/></material>
  <material name="foot"><color rgba="0.25 0.25 0.28 1"/></material>
  <link name="world"/>
  <joint name="floating_base" type="floating">
    <parent link="world"/><child link="pelvis"/>
    <origin xyz="0 0 0" rpy="0 0 0"/>
  </joint>
  <link name="pelvis">
    <inertial>
      <origin xyz="-0.00189578 -0.000138654 0.0462165" rpy="0 0 0"/>
      <mass value="0.417834"/>
      <inertia ixx="0.000583376" ixy="3.10739e-06" ixz="0.000149816" iyy="0.000619771" iyz="5.75977e-06" izz="0.000691068"/>
    </inertial>
    <visual><origin xyz="0 0 0" rpy="0 0 0"/><geometry><mesh filename="meshes/pelvis.stl"/></geometry><material name="shell"/></visual>
    <visual><origin xyz="0.014303 0.0280162 0.062" rpy="0 0 0"/><geometry><box size="0.034 0.02 0.026"/></geometry><material name="motor"/></visual>
    <visual><origin xyz="0.015297 -0.0283619 0.062" rpy="0 0 0"/><geometry><box size="0.034 0.02 0.026"/></geometry><material name="motor"/></visual>
    <collision><origin xyz="0.00854514 -0.00016741 0.03749" rpy="0 0 0"/><geometry><box size="0.102452 0.13605 0.04458"/></geometry></collision>
  </link>
  <link name="torso">
    <inertial>
      <origin xyz="0.0304346 9.21525e-05 0.127815" rpy="0 0 0"/>
      <mass value="2.49671"/>
      <inertia ixx="0.0486542" ixy="-0.000109285" ixz="0.00845894" iyy="0.047975" iyz="-0.000116759" izz="0.0276872"/>
    </inertial>
    <visual><origin xyz="0 0 0" rpy="0 0 0"/><geometry><mesh filename="meshes/torso.stl"/></geometry><material name="shell"/></visual>
    <visual><origin xyz="0.096141 0 0.0478113" rpy="0 0 0"/><geometry><box size="0.013524 0.247548 0.167345"/></geometry><material name="display"/></visual>
    <visual><origin xyz="0.102903 0 0.0478113" rpy="0 0 0"/><geometry><box size="0.0004 0.225792 0.14112"/></geometry><material name="screen"/></visual>
    <collision><origin xyz="-0.0446378 -2.07797e-06 0.032932" rpy="0 0 0"/><geometry><box size="0.209525 0.142073 0.139911"/></geometry></collision>
    <collision><origin xyz="0.0545076 0.110048 0.0663604" rpy="0 0 0"/><geometry><sphere radius="0.0796041"/></geometry></collision>
    <collision><origin xyz="0.0548844 -0.110217 0.0663604" rpy="0 0 0"/><geometry><sphere radius="0.0795276"/></geometry></collision>
    <collision><origin xyz="-0.00684162 0.000349887 0.134345" rpy="0 0 0"/><geometry><sphere radius="0.136537"/></geometry></collision>
    <collision><origin xyz="-0.0119218 -0.00016086 0.197217" rpy="0 0 0"/><geometry><sphere radius="0.157523"/></geometry></collision>
    <collision><origin xyz="-0.0181535 -0.000265494 0.260099" rpy="0 0 0"/><geometry><sphere radius="0.155698"/></geometry></collision>
    <collision><origin xyz="-0.0142413 0.00112154 0.322979" rpy="0 0 0"/><geometry><sphere radius="0.135386"/></geometry></collision>
    <collision><origin xyz="-0.00842703 0.00887726 0.385897" rpy="0 0 0"/><geometry><sphere radius="0.0964986"/></geometry></collision>
    <collision><origin xyz="-0.0154437 -0.00293413 0.44876" rpy="0 0 0"/><geometry><sphere radius="0.056001"/></geometry></collision>
    <collision><origin xyz="0.096141 0 0.0478113" rpy="0 0 0"/><geometry><box size="0.013524 0.247548 0.167345"/></geometry></collision>
  </link>
  <link name="leg_l">
    <inertial>
      <origin xyz="-0.00401168 0.00262601 -0.0100784" rpy="0 0 0"/>
      <mass value="0.068048"/>
      <inertia ixx="5.545e-05" ixy="1.24017e-07" ixz="2.73356e-06" iyy="5.66805e-05" iyz="2.5413e-07" izz="2.72513e-05"/>
    </inertial>
    <visual><origin xyz="0 0 0" rpy="0 0 0"/><geometry><mesh filename="meshes/leg_l.stl"/></geometry><material name="shell"/></visual>
    <collision><origin xyz="-0.00552526 0.00309104 0.00174308" rpy="0 0 0"/><geometry><box size="0.0528905 0.0485022 0.0618771"/></geometry></collision>
  </link>
  <link name="hip_l">
    <inertial>
      <origin xyz="0 -0.0025438 0.0220535" rpy="0 0 0"/>
      <mass value="0.0258671"/>
      <inertia ixx="2.98455e-06" ixy="0" ixz="0" iyy="2.55823e-06" iyz="5.25547e-08" izz="1.62632e-06"/>
    </inertial>
    <visual><origin xyz="0 -0.003 0.024" rpy="0 0 0"/><geometry><box size="0.02 0.026 0.034"/></geometry><material name="motor"/></visual>
  </link>
  <link name="foot_l">
    <inertial>
      <origin xyz="0.00159194 0.00760185 -0.0019764" rpy="0 0 0"/>
      <mass value="0.103166"/>
      <inertia ixx="3.7535e-05" ixy="-2.05766e-06" ixz="-5.72074e-07" iyy="5.58219e-05" iyz="-1.6394e-06" izz="6.58108e-05"/>
    </inertial>
    <visual><origin xyz="0 0 0" rpy="0 0 0"/><geometry><mesh filename="meshes/foot_l.stl"/></geometry><material name="shell"/></visual>
    <visual><origin xyz="0 0.0088 5.38845e-19" rpy="0 0 0"/><geometry><box size="0.026 0.034 0.02"/></geometry><material name="motor"/></visual>
    <collision><origin xyz="0 0 0" rpy="0 0 0"/><geometry><mesh filename="meshes/foot_l.stl"/></geometry></collision>
  </link>
  <link name="leg_r">
    <inertial>
      <origin xyz="-0.00440962 -0.00257259 -0.0116486" rpy="0 0 0"/>
      <mass value="0.0699431"/>
      <inertia ixx="6.10943e-05" ixy="-1.94982e-07" ixz="3.34094e-06" iyy="6.24068e-05" iyz="-2.79784e-07" izz="2.86152e-05"/>
    </inertial>
    <visual><origin xyz="0 0 0" rpy="0 0 0"/><geometry><mesh filename="meshes/leg_r.stl"/></geometry><material name="shell"/></visual>
    <collision><origin xyz="-0.00659261 -0.00306936 0.000874972" rpy="0 0 0"/><geometry><box size="0.0526981 0.0486026 0.0657819"/></geometry></collision>
  </link>
  <link name="hip_r">
    <inertial>
      <origin xyz="0 0.0025438 0.0245973" rpy="0 0 0"/>
      <mass value="0.0258671"/>
      <inertia ixx="3.10198e-06" ixy="0" ixz="0" iyy="2.67566e-06" iyz="-6.48723e-08" izz="1.62632e-06"/>
    </inertial>
    <visual><origin xyz="0 0.003 0.027" rpy="0 0 0"/><geometry><box size="0.02 0.026 0.034"/></geometry><material name="motor"/></visual>
  </link>
  <link name="foot_r">
    <inertial>
      <origin xyz="0.00175311 -0.00751124 -0.00203423" rpy="0 0 0"/>
      <mass value="0.102887"/>
      <inertia ixx="3.72566e-05" ixy="2.18095e-06" ixz="-5.11501e-07" iyy="5.55756e-05" iyz="1.62582e-06" izz="6.558e-05"/>
    </inertial>
    <visual><origin xyz="0 0 0" rpy="0 0 0"/><geometry><mesh filename="meshes/foot_r.stl"/></geometry><material name="shell"/></visual>
    <visual><origin xyz="0 -0.0088 5.38845e-19" rpy="0 0 0"/><geometry><box size="0.026 0.034 0.02"/></geometry><material name="motor"/></visual>
    <collision><origin xyz="0 0 0" rpy="0 0 0"/><geometry><mesh filename="meshes/foot_r.stl"/></geometry></collision>
  </link>
  <joint name="waist_fixed" type="fixed">
    <parent link="pelvis"/><child link="torso"/>
    <origin xyz="0 0 0.05978" rpy="0 0 0"/>
  </joint>
  <joint name="hip_yaw_l" type="revolute">
    <parent link="pelvis"/><child link="hip_l"/>
    <origin xyz="0.00550302 0.0280162 0" rpy="0 0 0"/>
    <axis xyz="0 0 1"/>
    <limit lower="-0.366519" upper="0.366519" effort="0.52" velocity="10.79"/>
    <dynamics damping="0.037142857142857144" friction="0.014857142857142859"/>
  </joint>
  <joint name="hip_pitch_l" type="revolute">
    <parent link="hip_l"/><child link="leg_l"/>
    <origin xyz="0 -0.003 0.0152" rpy="0 0 0"/>
    <axis xyz="0 1 0"/>
    <limit lower="-0.523599" upper="0.418879" effort="0.52" velocity="10.79"/>
    <dynamics damping="0.037142857142857144" friction="0.014857142857142859"/>
  </joint>
  <joint name="hip_yaw_r" type="revolute">
    <parent link="pelvis"/><child link="hip_r"/>
    <origin xyz="0.00649698 -0.0283619 0" rpy="0 0 0"/>
    <axis xyz="0 0 1"/>
    <limit lower="-0.366519" upper="0.366519" effort="0.52" velocity="10.79"/>
    <dynamics damping="0.037142857142857144" friction="0.014857142857142859"/>
  </joint>
  <joint name="hip_pitch_r" type="revolute">
    <parent link="hip_r"/><child link="leg_r"/>
    <origin xyz="0 0.003 0.0182" rpy="0 0 0"/>
    <axis xyz="0 1 0"/>
    <limit lower="-0.523599" upper="0.418879" effort="0.52" velocity="10.79"/>
    <dynamics damping="0.037142857142857144" friction="0.014857142857142859"/>
  </joint>
  <joint name="ankle_roll_l" type="revolute">
    <parent link="leg_l"/><child link="foot_l"/>
    <origin xyz="0.00663361 -0.00382274 -0.05951" rpy="0 0 0"/>
    <axis xyz="1 0 0"/>
    <limit lower="-0.261799" upper="0.261799" effort="0.52" velocity="10.79"/>
    <dynamics damping="0.037142857142857144" friction="0.014857142857142859"/>
  </joint>
  <joint name="ankle_roll_r" type="revolute">
    <parent link="leg_r"/><child link="foot_r"/>
    <origin xyz="0.00528074 0.00366681 -0.06251" rpy="0 0 0"/>
    <axis xyz="1 0 0"/>
    <limit lower="-0.261799" upper="0.261799" effort="0.52" velocity="10.79"/>
    <dynamics damping="0.037142857142857144" friction="0.014857142857142859"/>
  </joint>
</robot>
