yuuundj/Haetburi-practice/tools/write_mjcf.py

"""Emit the MuJoCo scene (robot + floor + XL430 position servos + sensors)."""
import numpy as np

import haetburi_params as P
import massprops as MP

DEG = np.pi / 180.0
ARMATURE = P.MOTOR_GEAR ** 2 * P.MOTOR_ROTOR_INERTIA      # reflected rotor inertia

LEG_CHAIN = {"leg_l", "leg_r", "ankle_l", "ankle_r", "foot_l", "foot_r"}


def _tree(joints):
    """parent -> [(joint, child)] from the joint list."""
    t = {}
    for jn, parent, child, *_ in joints:
        t.setdefault(parent, []).append((jn, child))
    return t


def f3(v):
    return " ".join(f"{x:.6g}" for x in v)


def _body(L, joints, name, indent, out, tree=None):
    tree = _tree(joints) if tree is None else tree
    link = L[name]
    m, c, I = link.props()
    pad = " " * indent
    out.append(f'{pad}<body name="{name}" pos="{f3(_origin_of(joints, name, L))}">')
    out.append(f'{pad}  <inertial pos="{f3(c)}" mass="{m:.6g}" '
               f'fullinertia="{I[0,0]:.6g} {I[1,1]:.6g} {I[2,2]:.6g} '
               f'{I[0,1]:.6g} {I[0,2]:.6g} {I[1,2]:.6g}"/>')
    jn = _joint_of(joints, name)
    if jn is not None and jn[5] is not None:          # lk None: a fixed joint (no motor)
        _, _, _, axis, _, lk = jn
        lo, hi = P.LIM[lk]
        out.append(f'{pad}  <joint name="{jn[0]}" class="dxl" axis="{f3(axis)}" '
                   f'range="{lo*DEG:.6g} {hi*DEG:.6g}"/>')
    if link.mesh_file is not None:
        out.append(f'{pad}  <geom class="shell" mesh="{name}"/>')
    for _, (size, pos), mat in link.visual:
        cls = {"motor": "motorbox", "foot": "footbox"}.get(mat, "visbox")
        extra = f' material="{mat}"' if cls == "visbox" else ""
        out.append(f'{pad}  <geom class="{cls}"{extra} size="{f3(np.array(size)/2)}" pos="{f3(pos)}"/>')
    cls = "colleg" if name in LEG_CHAIN else "colbody"
    for i, (kind, params) in enumerate(link.collision):
        if kind == "mesh":
            out.append(f'{pad}  <geom class="{cls}" name="{name}_c{i}" type="mesh" mesh="{params}"/>')
        elif kind == "box":
            size, pos = params
            out.append(f'{pad}  <geom class="{cls}" name="{name}_c{i}" type="box" '
                       f'size="{f3(np.array(size)/2)}" pos="{f3(pos)}"/>')
        else:
            r, pos = params
            out.append(f'{pad}  <geom class="{cls}" name="{name}_c{i}" type="sphere" '
                       f'size="{r:.6g}" pos="{f3(pos)}"/>')
    if name == "torso":
        out.append(f'{pad}  <site name="imu" pos="0 0 0.02" size="0.006"/>')
    if link.z_sole_mm is not None:
        z = -link.z_sole_mm * 1e-3
        out.append(f'{pad}  <site name="{name}_sole" pos="0 0 {z:.6g}" size="0.006"/>')
    for _, child in tree.get(name, []):
        _body(L, joints, child, indent + 2, out, tree)
    out.append(f'{pad}</body>')


def _joint_of(joints, child):
    for j in joints:
        if j[2] == child:
            return j
    return None


def _origin_of(joints, child, L):
    j = _joint_of(joints, child)
    return j[4] if j is not None else np.zeros(3)


def write(L, joints, meta, path):
    items = [(l.props()[0], l.props()[1] + meta["org"][n], l.props()[2]) for n, l in L.items()]
    M, C, _ = MP.combine(items)
    root = meta["org"]["pelvis"] - np.array([C[0], C[1], 0.0])   # com over the world origin

    o = []
    o.append(f'<!-- Haetburi biped scene ({P.VARIANT}) - generated by tools/build_model.py -->')
    o.append('<mujoco model="haetburi">')
    o.append('  <compiler angle="radian" meshdir="meshes" autolimits="true"/>')
    o.append('  <option timestep="0.002" integrator="implicitfast" cone="elliptic" impratio="5"/>')
    o.append('  <size memory="20M"/>')
    o.append('')
    o.append('  <default>')
    o.append('    <default class="dxl">')
    o.append(f'      <joint type="hinge" damping="{P.JOINT_DAMPING}" '
             f'frictionloss="{P.JOINT_FRICTION}" armature="{ARMATURE:.5g}"/>')
    o.append(f'      <position kp="{P.ACT_KP}" kv="{P.ACT_KV}" '
             f'forcerange="-{P.MOTOR_STALL_NM} {P.MOTOR_STALL_NM}"/>')
    o.append('    </default>')
    o.append('    <default class="shell">')
    o.append('      <geom type="mesh" material="shell" contype="0" conaffinity="0" group="2"/>')
    o.append('    </default>')
    o.append('    <default class="motorbox">')
    o.append('      <geom type="box" material="motor" contype="0" conaffinity="0" group="2"/>')
    o.append('    </default>')
    o.append('    <default class="footbox">')
    o.append('      <geom type="box" material="foot" contype="0" conaffinity="0" group="2"/>')
    o.append('    </default>')
    o.append('    <default class="visbox">')
    o.append('      <geom type="box" contype="0" conaffinity="0" group="2"/>')
    o.append('    </default>')
    o.append('    <default class="colleg">')
    o.append('      <geom group="3" rgba="0.9 0.2 0.2 0.35" contype="1" conaffinity="1" '
             'friction="1.0 0.02 0.001" solref="0.005 1"/>')
    o.append('    </default>')
    o.append('    <default class="colbody">')
    o.append('      <geom group="3" rgba="0.9 0.2 0.2 0.35" contype="2" conaffinity="2" '
             'friction="0.6 0.01 0.001"/>')
    o.append('    </default>')
    o.append('  </default>')
    o.append('')
    o.append('  <visual>')
    o.append('    <global offwidth="1600" offheight="1200" azimuth="200" elevation="-12"/>')
    o.append('    <quality shadowsize="4096" offsamples="4"/>')
    o.append('    <map znear="0.01" zfar="30"/>')
    o.append('    <headlight ambient="0.35 0.35 0.35" diffuse="0.5 0.5 0.5" specular="0.1 0.1 0.1"/>')
    o.append('  </visual>')
    o.append('')
    o.append('  <asset>')
    o.append('    <texture type="skybox" builtin="gradient" rgb1="0.55 0.68 0.85" '
             'rgb2="0.08 0.10 0.16" width="512" height="3072"/>')
    o.append('    <texture type="2d" name="grid" builtin="checker" mark="edge" '
             'rgb1="0.82 0.83 0.85" rgb2="0.72 0.74 0.78" markrgb="0.4 0.4 0.4" '
             'width="300" height="300"/>')
    o.append('    <material name="grid" texture="grid" texuniform="true" '
             'texrepeat="6 6" reflectance="0.05"/>')
    o.append('    <material name="shell" rgba="0.106 0.216 0.541 1" specular="0.3" shininess="0.4"/>')
    o.append('    <material name="motor" rgba="0.13 0.13 0.15 1" specular="0.5" shininess="0.6"/>')
    o.append('    <material name="foot" rgba="0.25 0.25 0.28 1"/>')
    o.append('    <material name="display" rgba="0.18 0.19 0.21 1" specular="0.6" shininess="0.7"/>')
    o.append('    <material name="screen" rgba="0.62 0.80 0.95 1" specular="0.9" shininess="0.9" emission="0.25"/>')
    for n, l in L.items():
        if l.mesh_file is not None:
            o.append(f'    <mesh name="{n}" file="{n}.stl"/>')
    o.append('  </asset>')
    o.append('')
    o.append('  <worldbody>')
    o.append('    <light name="key" pos="0.8 0.6 2.0" dir="-0.35 -0.25 -1" directional="true"/>')
    o.append('    <light name="fill" pos="-1.0 -0.8 1.4" dir="0.5 0.4 -1" diffuse="0.3 0.3 0.3"/>')
    o.append('    <geom name="floor" type="plane" size="4 4 0.05" material="grid" '
             'contype="3" conaffinity="3" friction="1.0 0.02 0.001"/>')
    o.append(f'    <body name="pelvis" pos="{f3(root)}">')
    o.append('      <freejoint name="floating_base"/>')
    tmp = []
    _body(L, joints, "pelvis", 6, tmp)
    o.extend(tmp[1:-1])          # drop the duplicated <body>/</body> wrapper
    o.append('    </body>')
    o.append('  </worldbody>')
    o.append('')
    if meta.get("exclude"):
        o.append('  <contact>')
        for b1, b2 in meta["exclude"]:
            # the leg floats just above its own foot; the build keeps them apart
            o.append(f'    <exclude body1="{b1}" body2="{b2}"/>')
        o.append('  </contact>')
        o.append('')
    driven = [j for j in joints if j[5] is not None]
    o.append('  <actuator>')
    for jn, _, _, _, _, lk in driven:
        lo, hi = P.LIM[lk]
        o.append(f'    <position class="dxl" name="{jn}" joint="{jn}" '
                 f'ctrlrange="{lo*DEG:.6g} {hi*DEG:.6g}"/>')
    o.append('  </actuator>')
    o.append('')
    o.append('  <sensor>')
    for jn, _, _, _, _, _ in driven:
        o.append(f'    <jointpos name="{jn}_pos" joint="{jn}"/>')
    for jn, _, _, _, _, _ in driven:
        o.append(f'    <jointactuatorfrc name="{jn}_trq" joint="{jn}"/>')
    o.append('    <framequat name="torso_quat" objtype="site" objname="imu"/>')
    o.append('    <gyro name="torso_gyro" site="imu"/>')
    o.append('    <accelerometer name="torso_acc" site="imu"/>')
    o.append('    <force name="foot_l_force" site="foot_l_sole"/>')
    o.append('    <force name="foot_r_force" site="foot_r_sole"/>')
    o.append('  </sensor>')
    o.append('')
    o.append('  <keyframe>')
    zeros = " ".join(["0"] * len(driven))
    o.append(f'    <key name="stand" qpos="{f3(root)} 1 0 0 0 {zeros}" ctrl="{zeros}"/>')
    o.append('  </keyframe>')
    o.append('</mujoco>')

    with open(path, "w") as fh:
        fh.write("\n".join(o) + "\n")
    return M, C
