yuuundj/Haetburi-practice/(commit log)

2026-09-24 횃불봇 제작 연습 1일차 업로드
    [foot_l.stl, foot_r.stl, haetburi.urdf, haetburi_feet_v1.stl, haetburi_grip_20mm_300mm.stl, leg_l.stl, leg_r.stl, pelvis.stl]
2026-09-28 횃불봇 제작 연습 2일차 업로드
    [foot_l.stl, foot_r.stl, haetburi.urdf, leg_l.stl, leg_r.stl, pelvis.stl, torso.stl]
2026-10-03 횃불봇 제작 연습 3일차 업로드
    [foot_l.stl, foot_r.stl, haetburi.urdf, haetburi_display_parts.stl, leg_l.stl, leg_r.stl, pelvis.stl, torso.stl]
2026-10-13 새 캐릭터 STL에 꼬리와 디스플레이를 결합한 기반 모델 추가
    [haetburi_display_assembled.stl, haetburi_display_tail.stl]
2026-10-13 새 캐릭터 기반 빌드에 고관절 소켓, 4 mm 외피, 전장품 자동 배치 등 v11~v22 모델링 기능 추가
2026-10-13 IMU 되먹임 균형, 다리-몸통 충돌 검사, 보행 정밀 탐색과 부하 판정 기준 추가
2026-10-13 v11~v22 버전의 모델과 보행·부하 결과 추가
    [body_native.stl, foot_l.stl, foot_r.stl, haetburi.urdf, leg_l.stl, leg_r.stl, pelvis.stl, torso.stl]
2026-10-13 README를 현재 기준 모델 중심으로 정리
